OpenSim2Real/hardware_repository/README.md

# hardware_repository

This is the hardware repository for the OpenSim2Real project. It contains all of the CAD files and supporting documentation.
