OpenSim2Real/hardware_repository/docs/design/design_images/angles.PNG

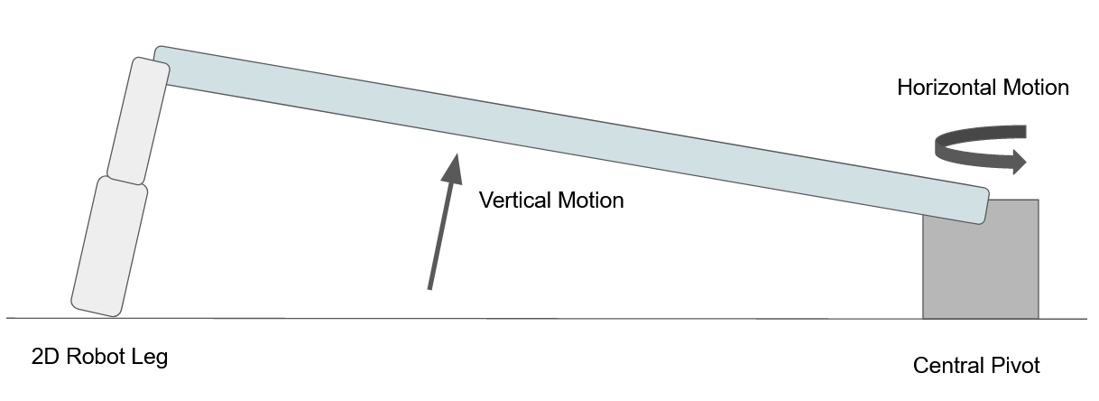
docs/design/design_images/angles.PNG
