OpenSim2Real/hardware_repository/docs/design/design_images/canelectronics.PNG

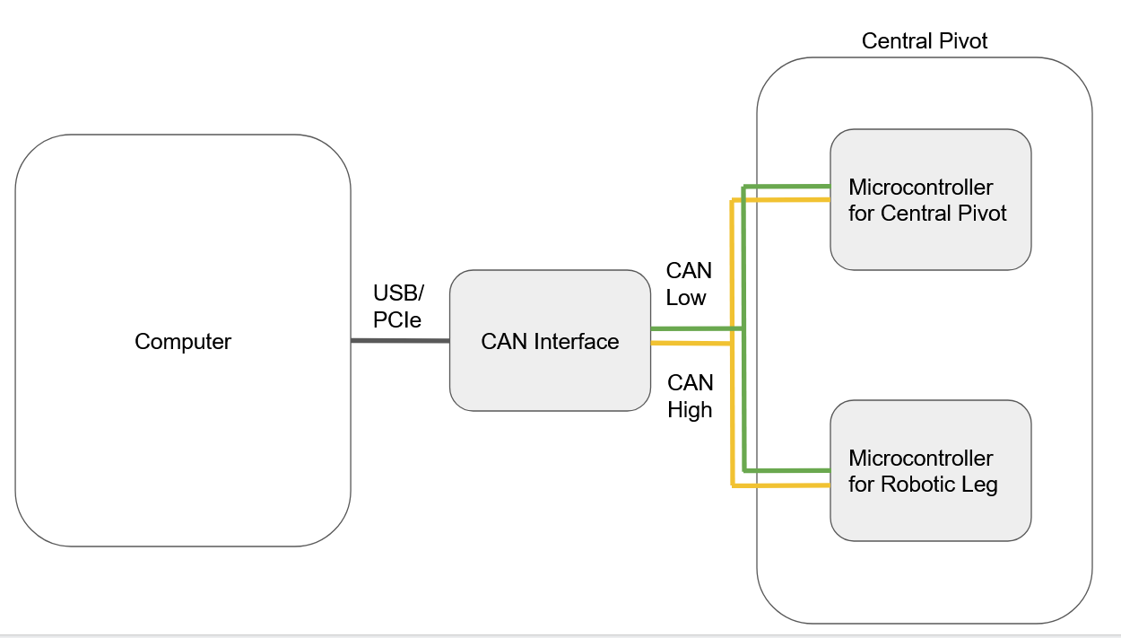
docs/design/design_images/canelectronics.PNG
