OpenSim2Real/hardware_repository/docs/design/design_images/controlelectronics.PNG

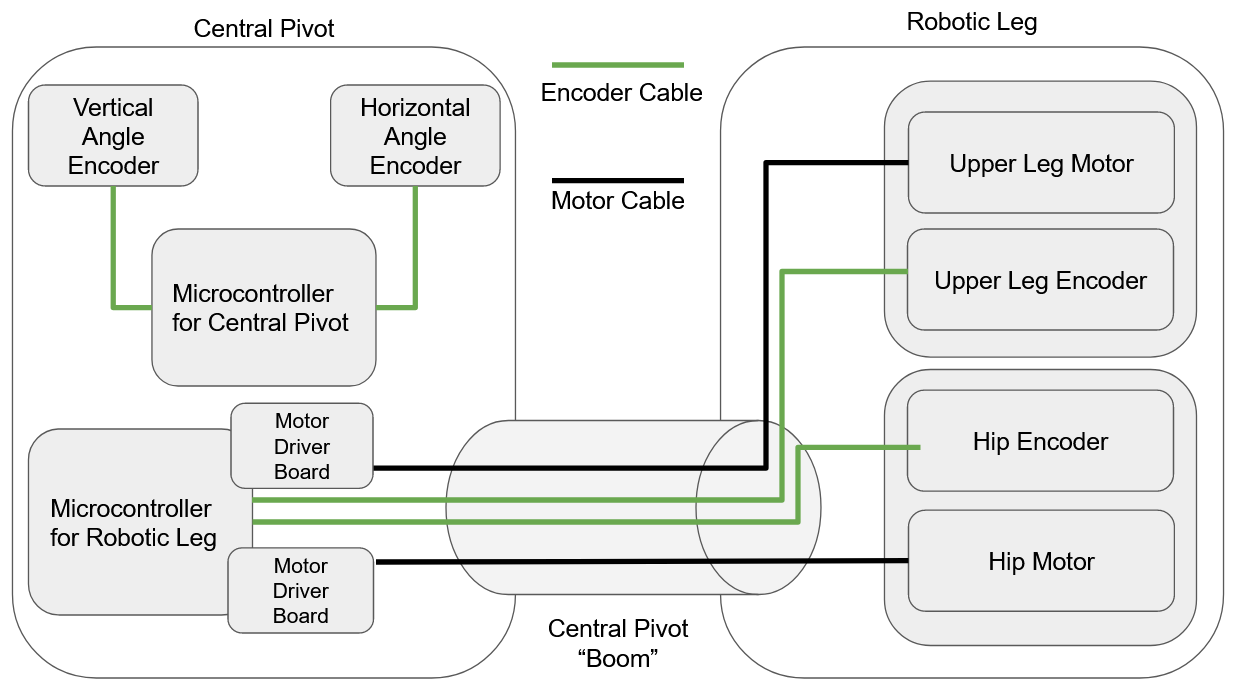
docs/design/design_images/controlelectronics.PNG
