OpenSim2Real/hardware_repository/docs/design/design_images/forces.PNG

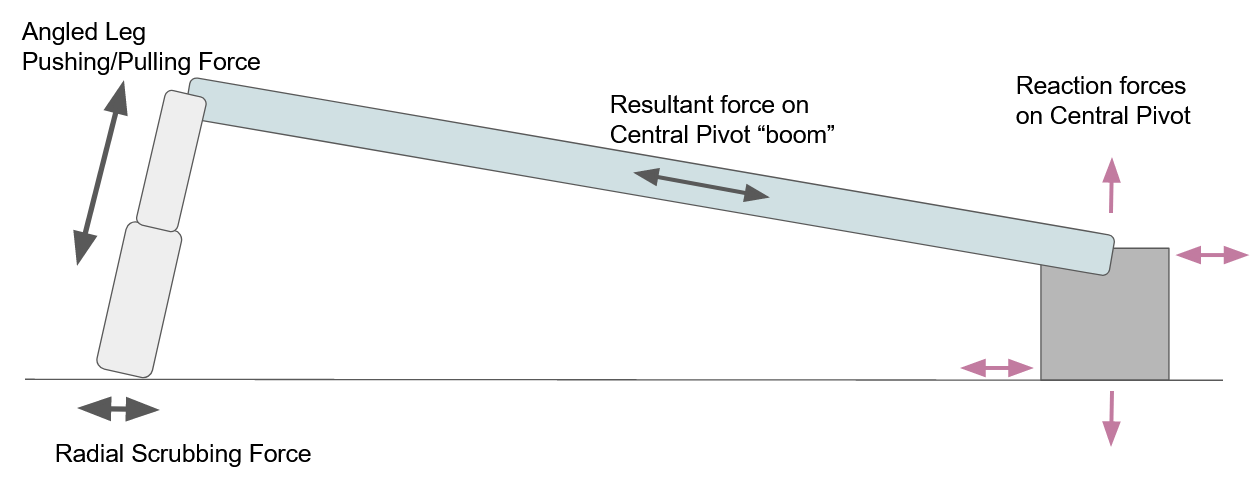
docs/design/design_images/forces.PNG
