OpenSim2Real/hardware_repository/docs/design/design_images/planarizer.PNG

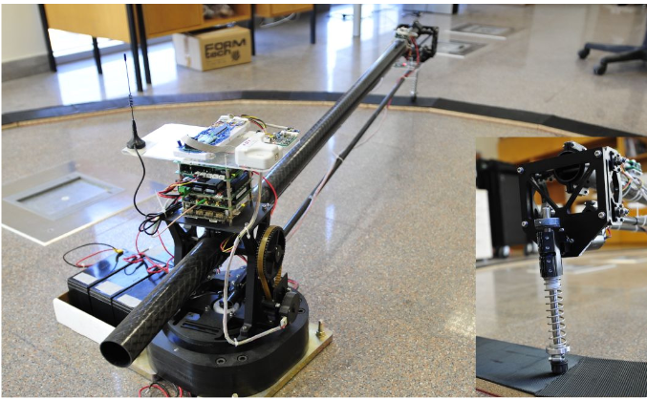
docs/design/design_images/planarizer.PNG
