OpenSim2Real/hardware_repository/docs/design/design_images/planarizer_2.PNG

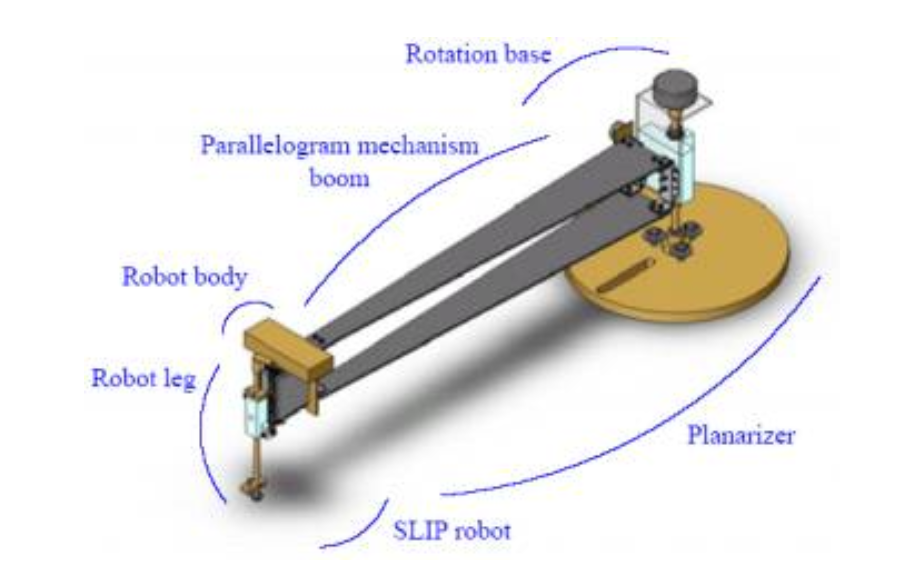
docs/design/design_images/planarizer_2.PNG
