OpenSim2Real/hardware_repository/docs/design/design_images/planarizerforces.PNG

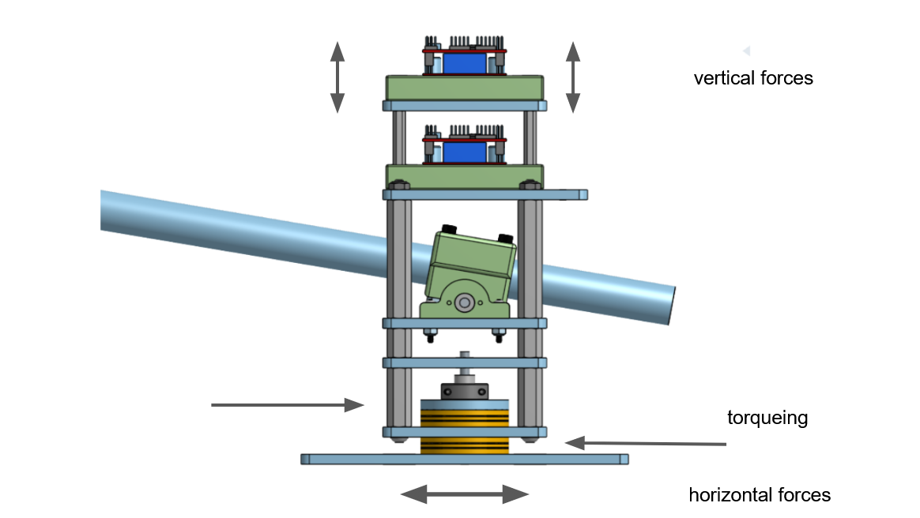
docs/design/design_images/planarizerforces.PNG
