OpenSim2Real/hardware_repository/docs/design/design_images/powerelectronics.PNG

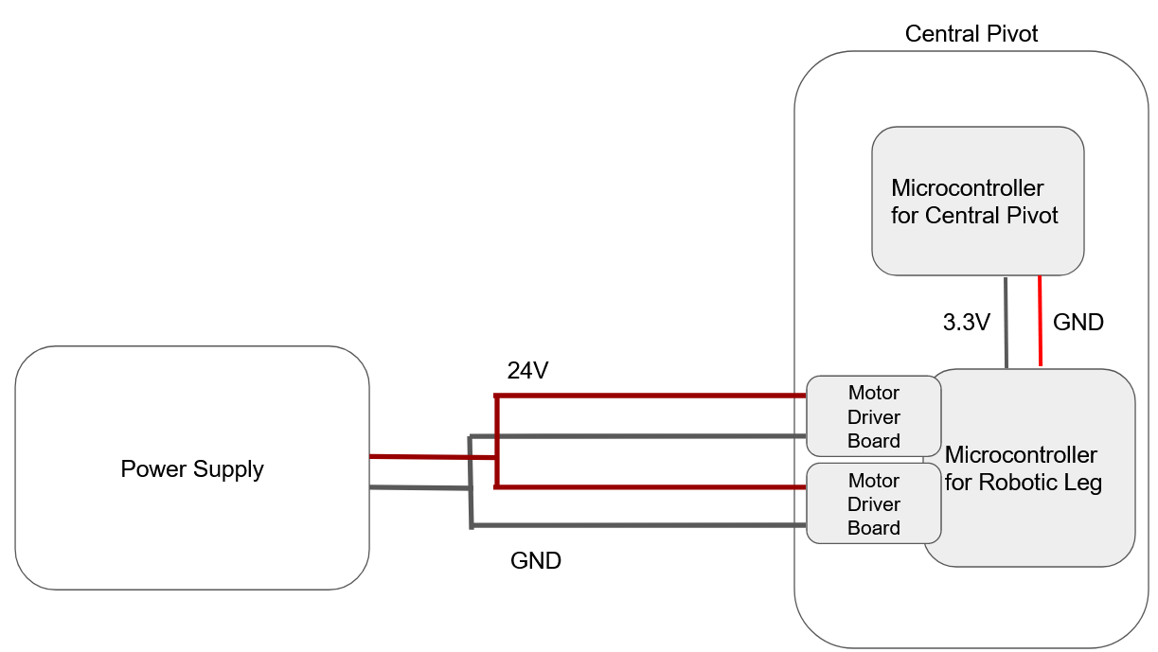
docs/design/design_images/powerelectronics.PNG
