OpenSim2Real/hardware_repository/docs/design/design_images/radialscrubbing.PNG

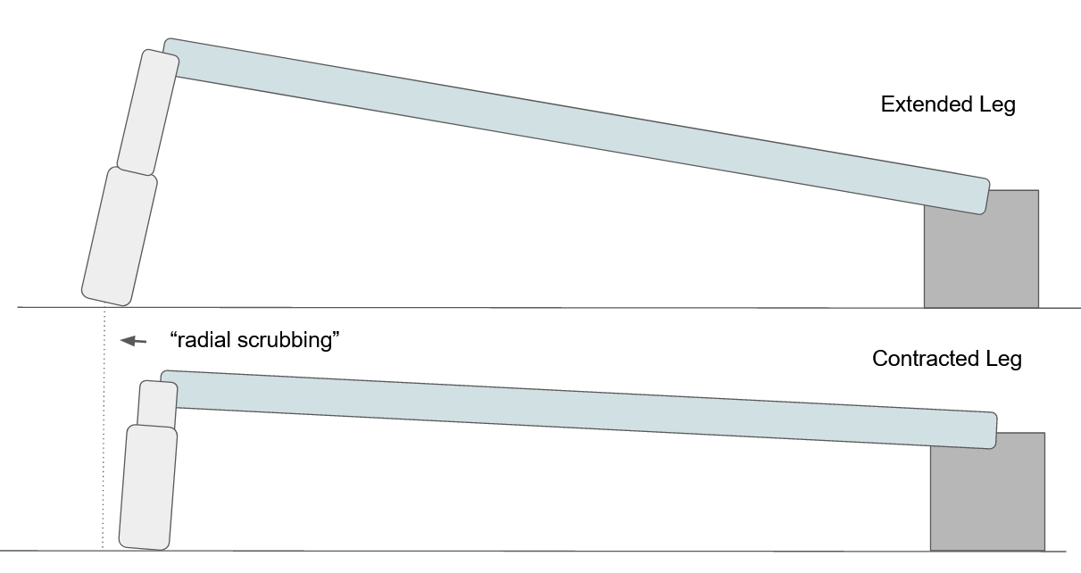
docs/design/design_images/radialscrubbing.PNG
