OpenSim2Real/hardware_repository/docs/design/design_images/roboticleg.PNG

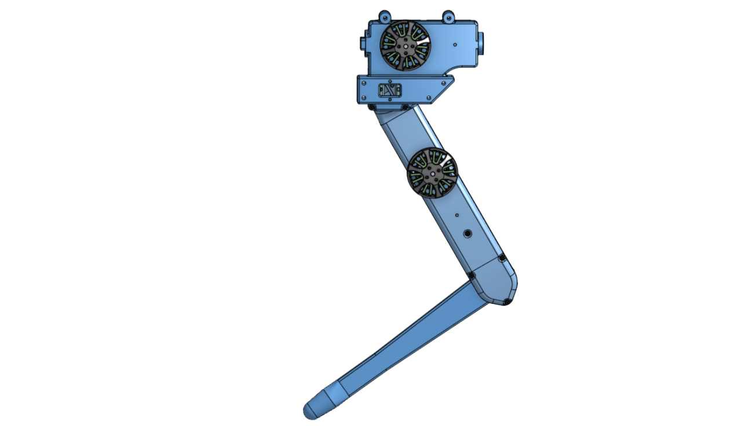
docs/design/design_images/roboticleg.PNG
