OpenSim2Real/hardware_repository/docs/design/design_images/treadmill.PNG

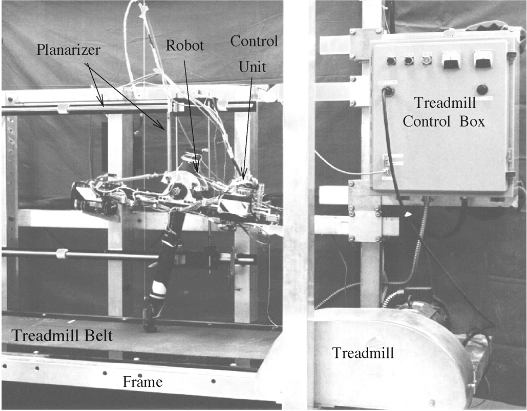
docs/design/design_images/treadmill.PNG
