OpenSim2Real/hardware_repository/docs/firmware/fm_images/import_2.PNG

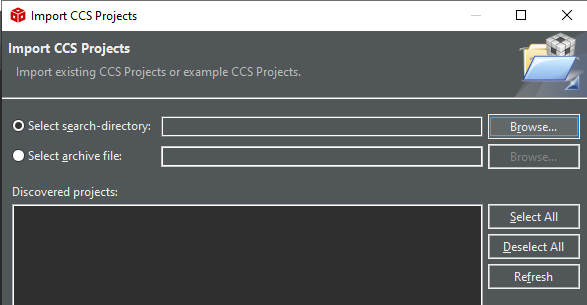
docs/firmware/fm_images/import_2.PNG
