OpenSim2Real/hardware_repository/docs/firmware/fm_images/load.PNG

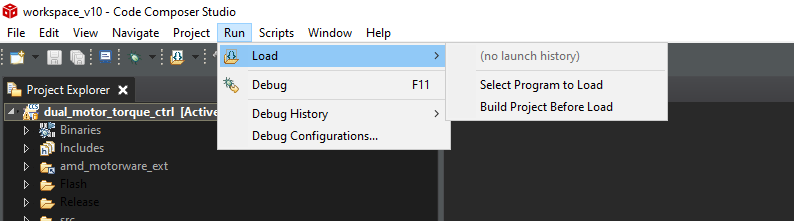
docs/firmware/fm_images/load.PNG
