OpenSim2Real/hardware_repository/docs/physical/cp_images/adapter.jpg

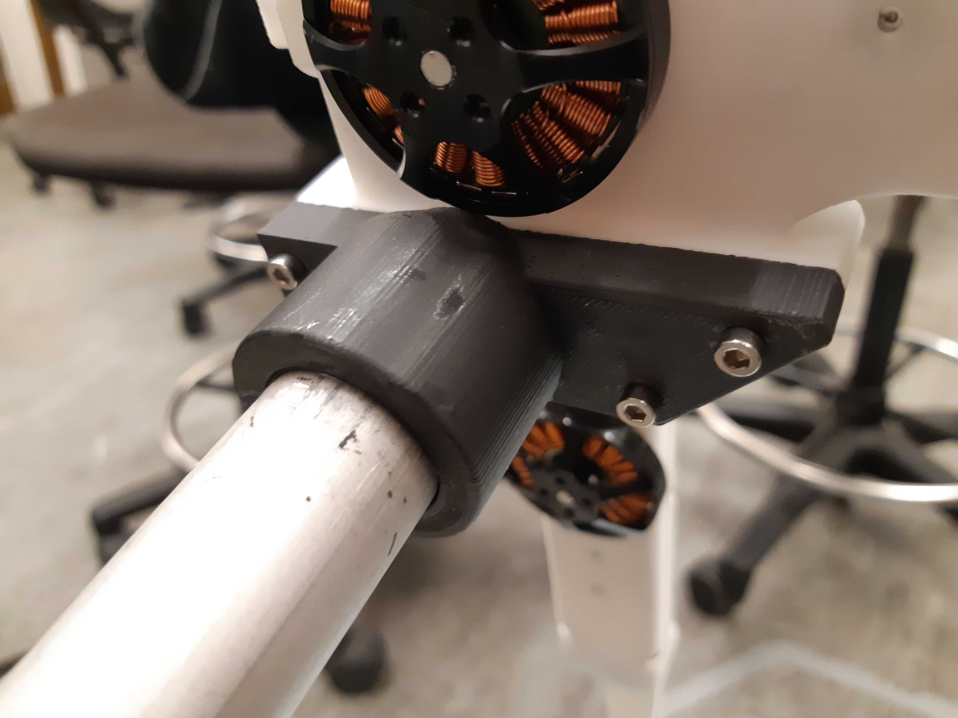
docs/physical/cp_images/adapter.jpg
