OpenSim2Real/hardware_repository/docs/physical/cp_images/adapter_1.jpg

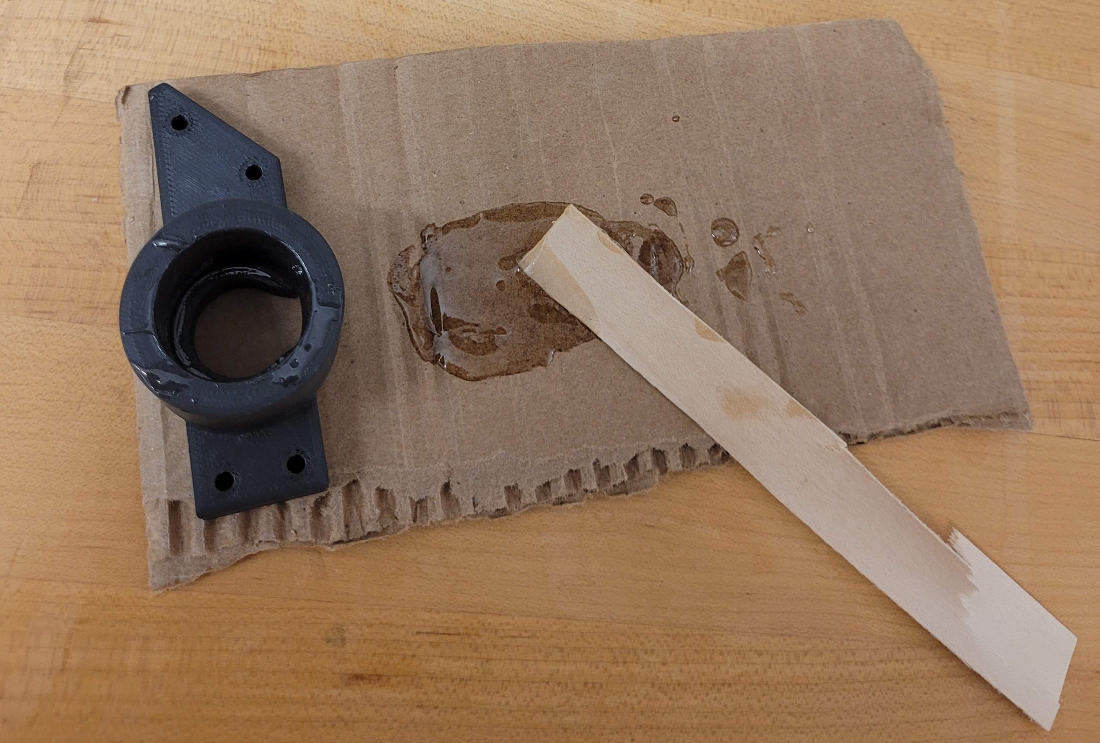
docs/physical/cp_images/adapter_1.jpg
