OpenSim2Real/hardware_repository/docs/physical/cp_images/adapter_2.jpg

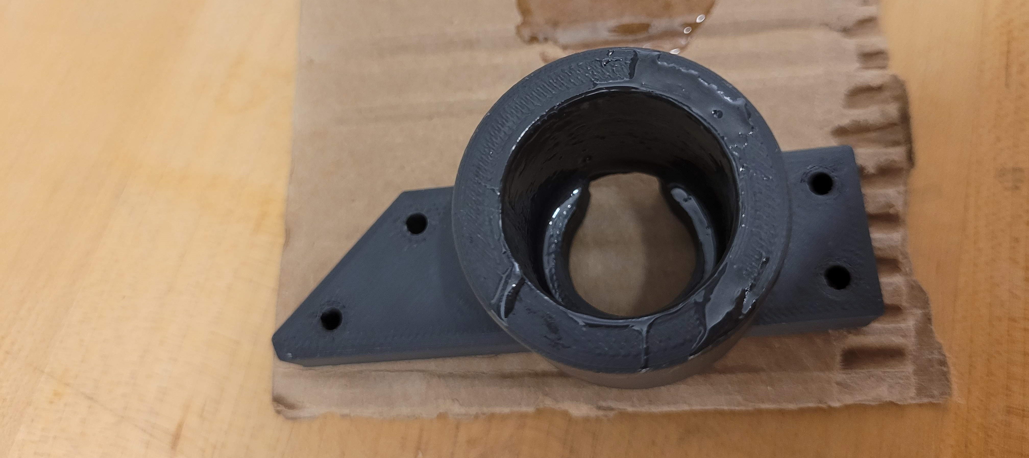
docs/physical/cp_images/adapter_2.jpg
