OpenSim2Real/hardware_repository/docs/physical/cp_images/adapter_4.jpg

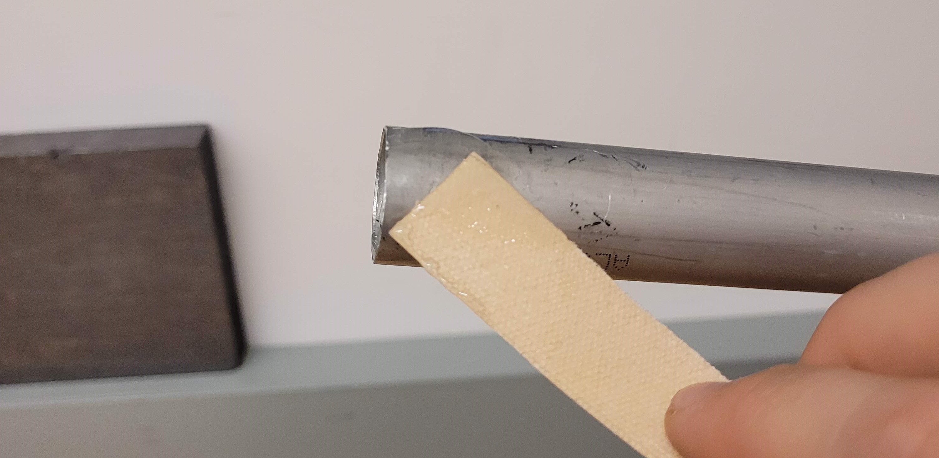
docs/physical/cp_images/adapter_4.jpg
