OpenSim2Real/hardware_repository/docs/physical/cp_images/cp_complete_3.jpg

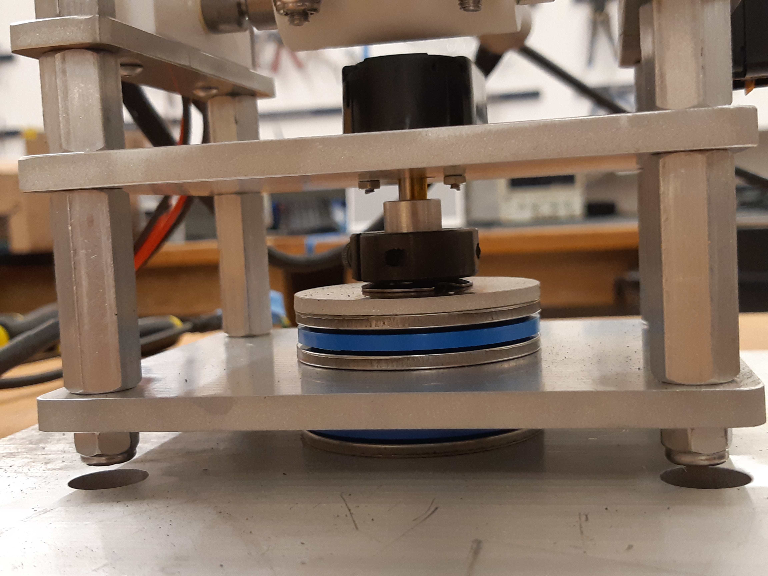
docs/physical/cp_images/cp_complete_3.jpg
