OpenSim2Real/hardware_repository/docs/physical/cp_images/cp_complete_5.jpg

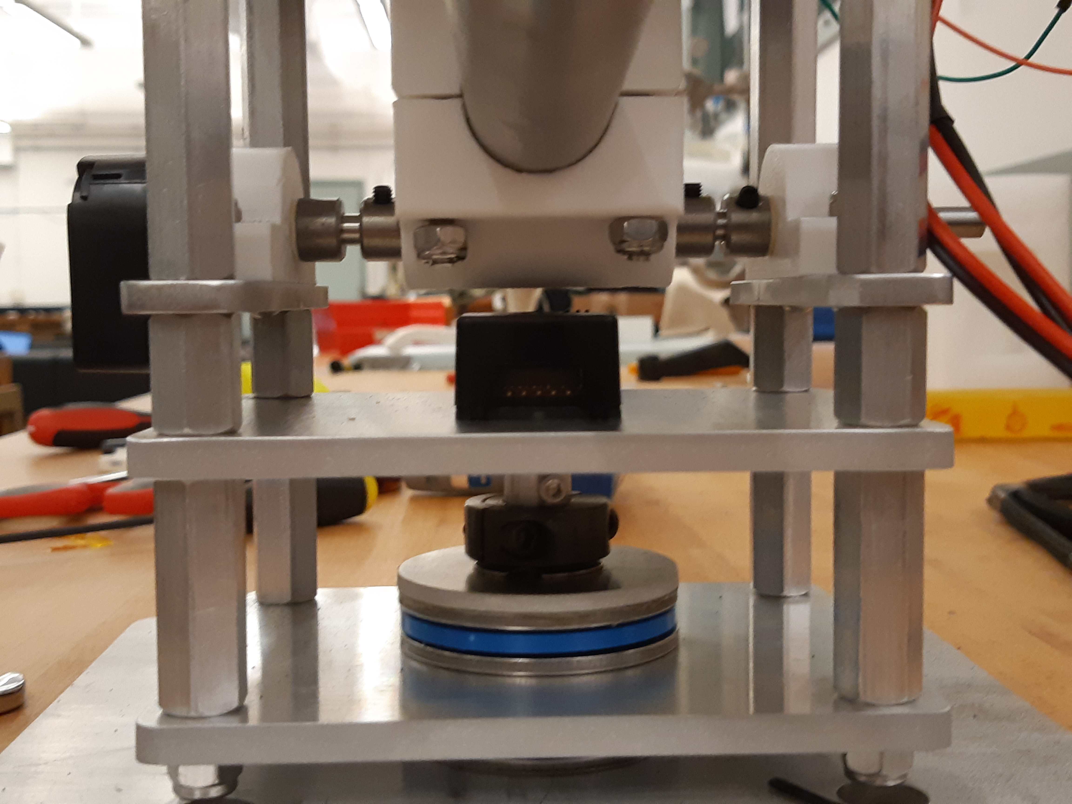
docs/physical/cp_images/cp_complete_5.jpg
