OpenSim2Real/hardware_repository/docs/physical/cp_images/cp_stage_1_2.jpg

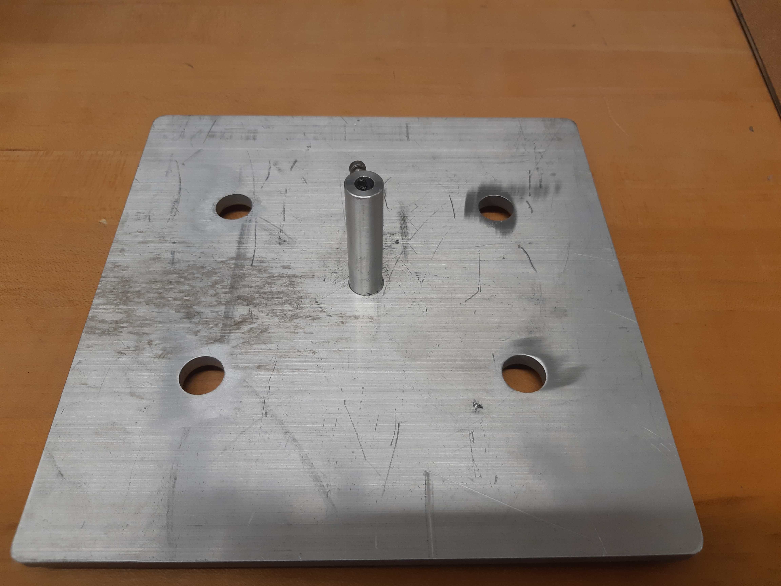
docs/physical/cp_images/cp_stage_1_2.jpg
