OpenSim2Real/hardware_repository/docs/physical/cp_images/cp_stage_9_1.jpg

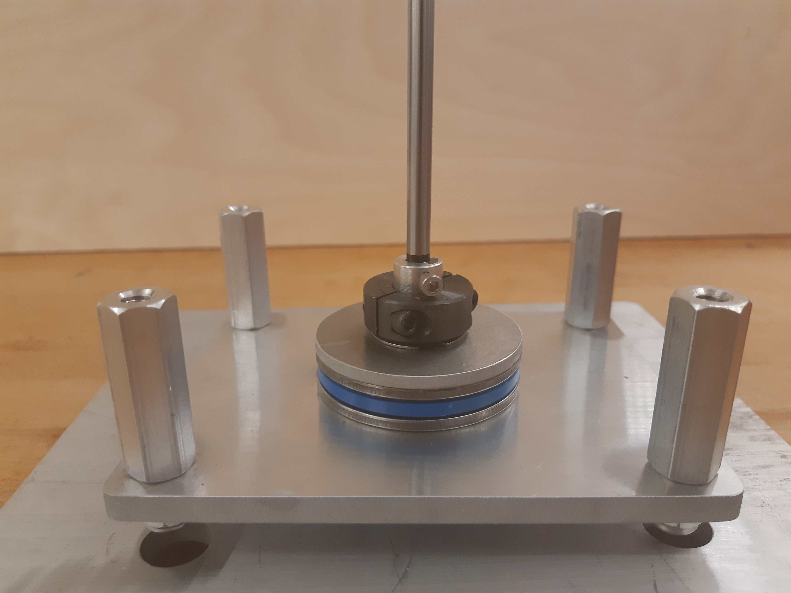
docs/physical/cp_images/cp_stage_9_1.jpg
