OpenSim2Real/hardware_repository/docs/physical/cp_images/cp_stage_14.jpg

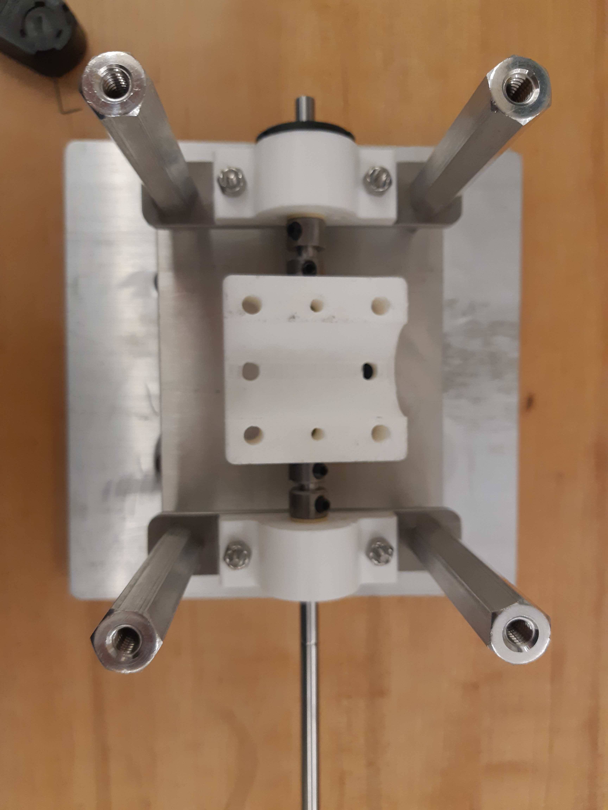
docs/physical/cp_images/cp_stage_14.jpg
