OpenSim2Real/hardware_repository/docs/physical/cp_images/encoderwire_5.jpg

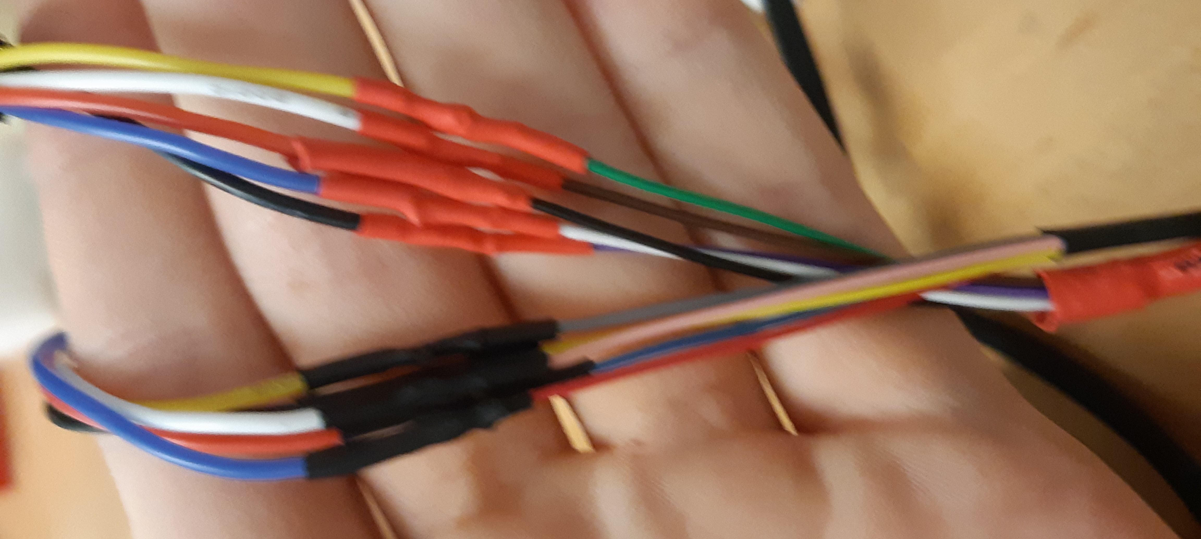
docs/physical/cp_images/encoderwire_5.jpg
