OpenSim2Real/hardware_repository/docs/physical/cp_images/shaft_holder_2.jpg

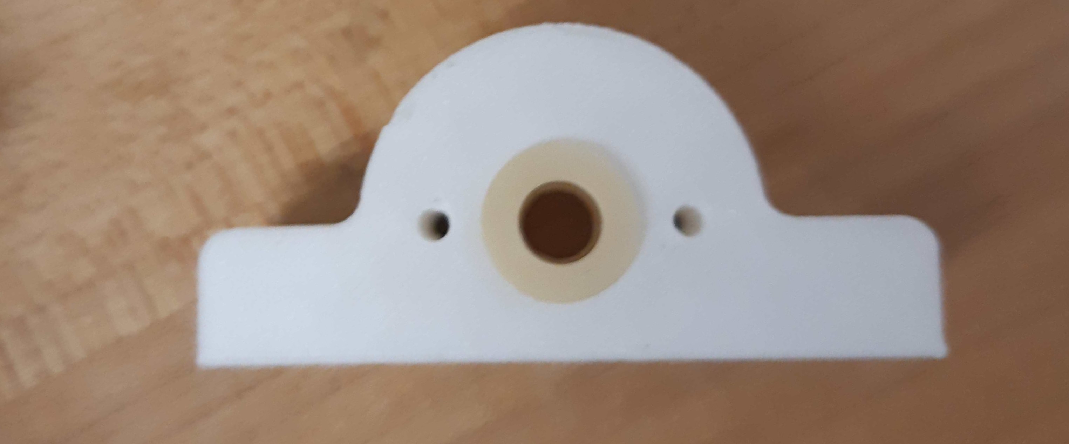
docs/physical/cp_images/shaft_holder_2.jpg
