OpenSim2Real/hardware_repository/docs/physical/cp_images/shaft_holder_5.jpg

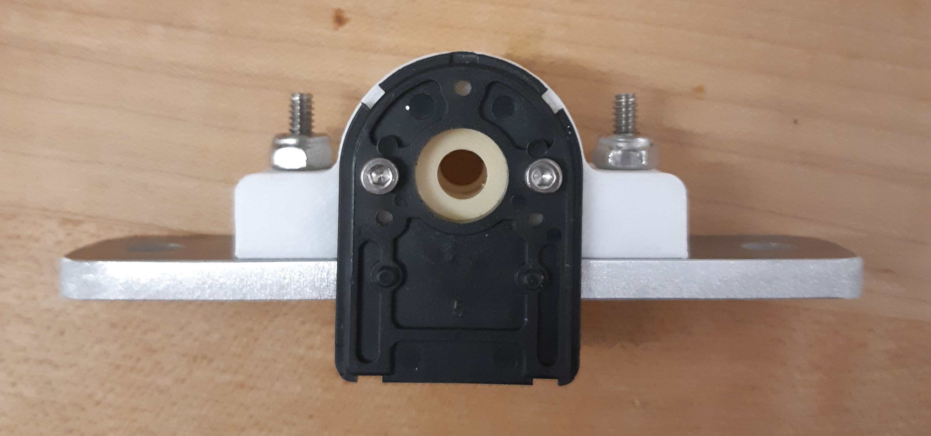
docs/physical/cp_images/shaft_holder_5.jpg
