OpenSim2Real/hardware_repository/docs/physical/in_images/3phase_5.jpg

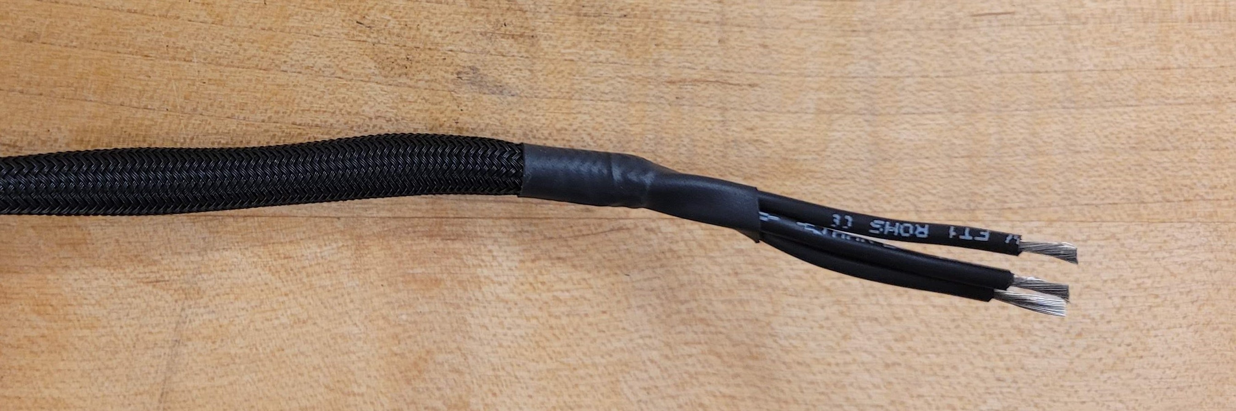
docs/physical/in_images/3phase_5.jpg
