OpenSim2Real/hardware_repository/docs/physical/in_images/3phase_8.jpg

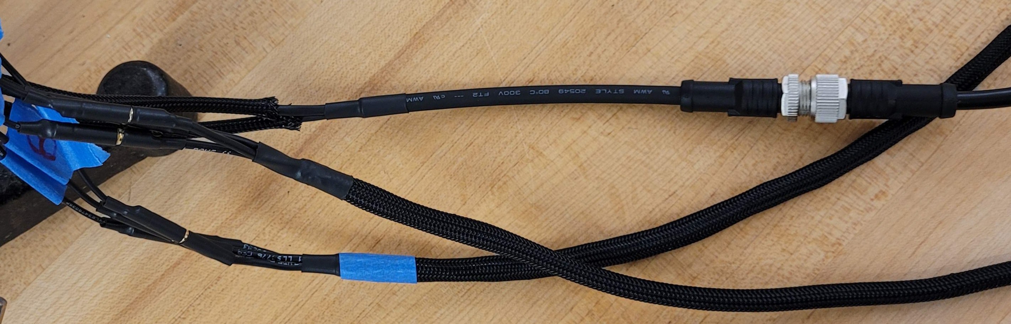
docs/physical/in_images/3phase_8.jpg
