OpenSim2Real/hardware_repository/docs/physical/in_images/3phase_9.jpg

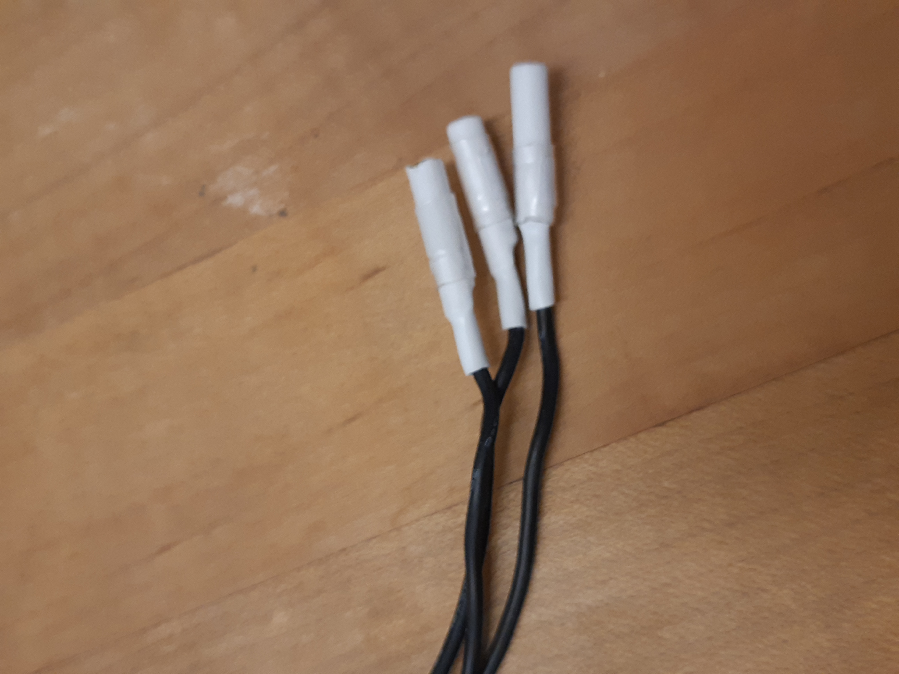
docs/physical/in_images/3phase_9.jpg
