OpenSim2Real/hardware_repository/docs/physical/in_images/can1.jpg

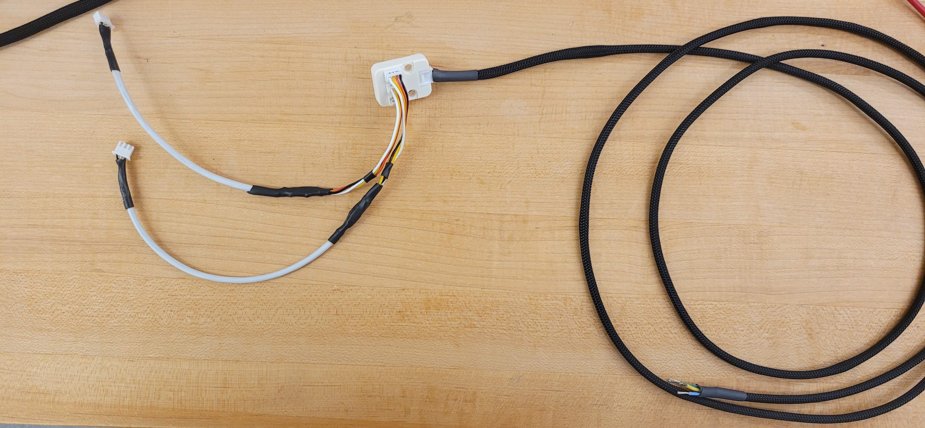
docs/physical/in_images/can1.jpg
