OpenSim2Real/hardware_repository/docs/physical/in_images/can2.jpg

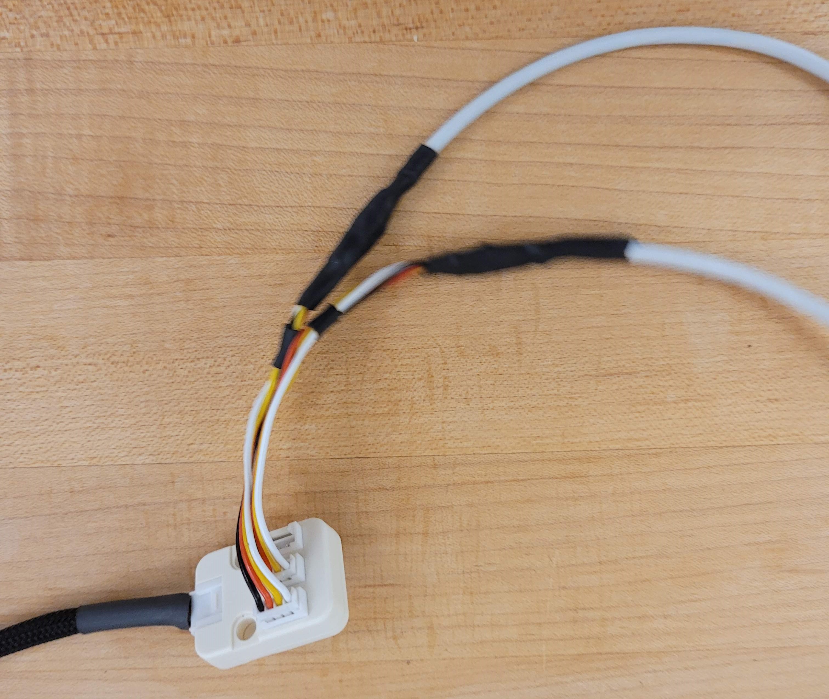
docs/physical/in_images/can2.jpg
