OpenSim2Real/hardware_repository/docs/physical/in_images/can3.jpg

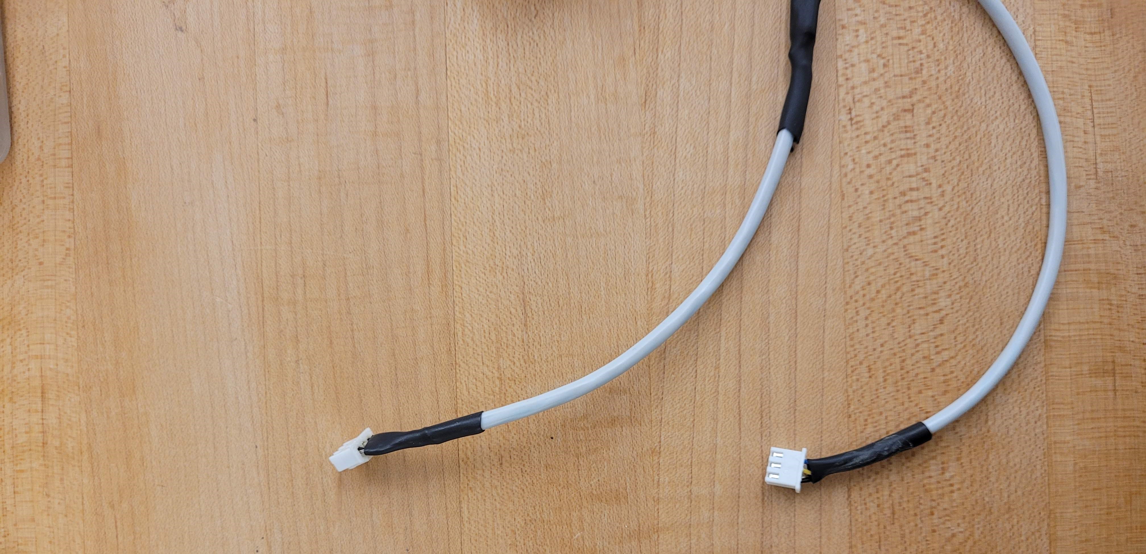
docs/physical/in_images/can3.jpg
