OpenSim2Real/hardware_repository/docs/physical/in_images/conn1.jpg

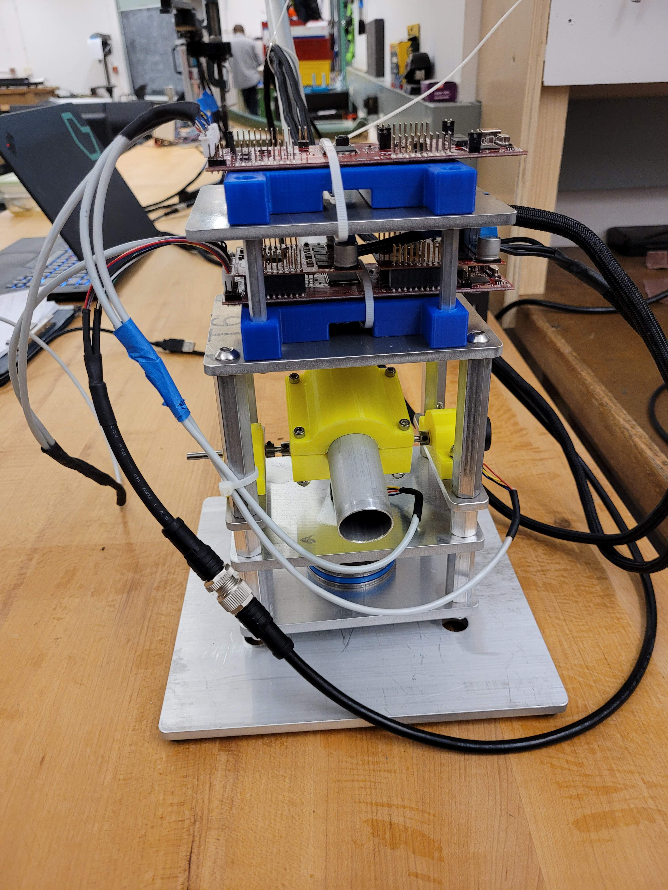
docs/physical/in_images/conn1.jpg
