OpenSim2Real/hardware_repository/docs/physical/in_images/conn2.jpg

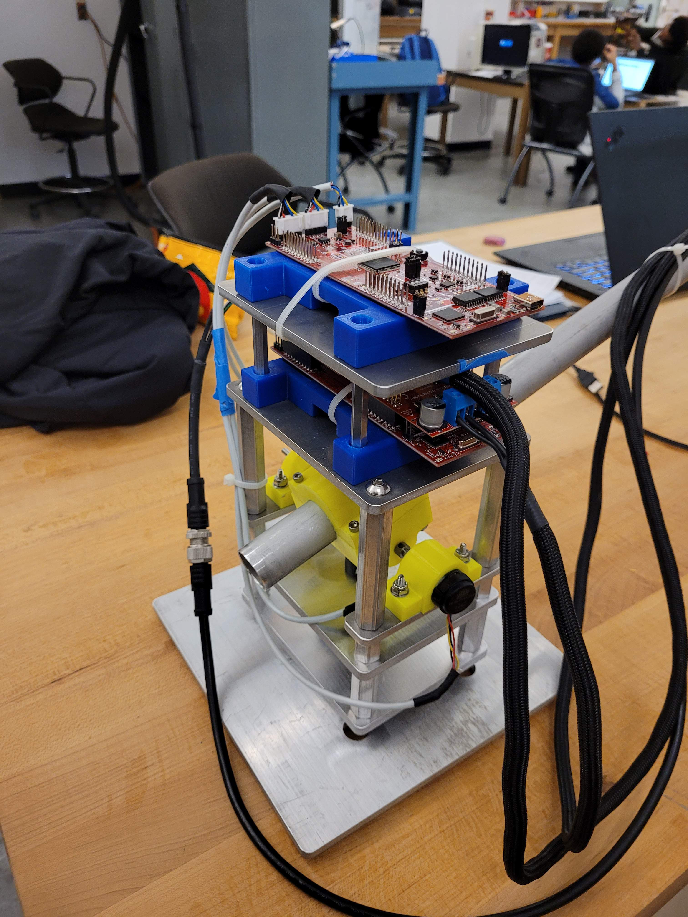
docs/physical/in_images/conn2.jpg
