OpenSim2Real/hardware_repository/docs/physical/in_images/conn3.jpg

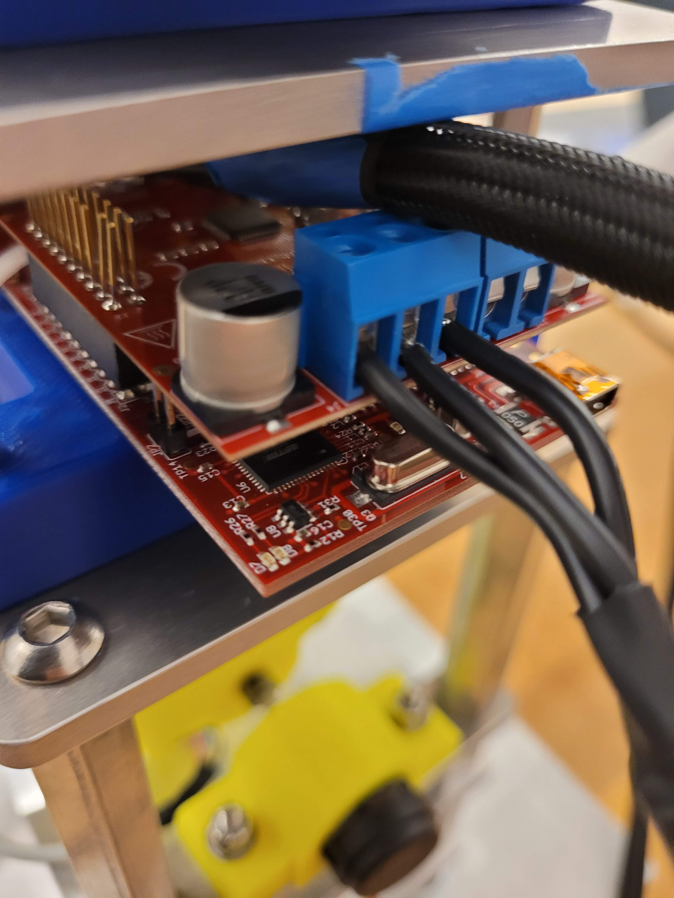
docs/physical/in_images/conn3.jpg
