OpenSim2Real/hardware_repository/docs/physical/in_images/conn4.jpg

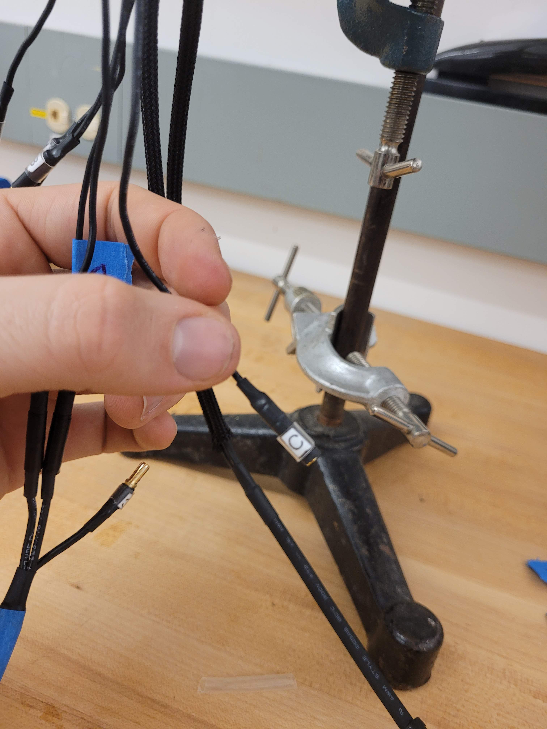
docs/physical/in_images/conn4.jpg
