OpenSim2Real/hardware_repository/docs/physical/in_images/conn5.jpg

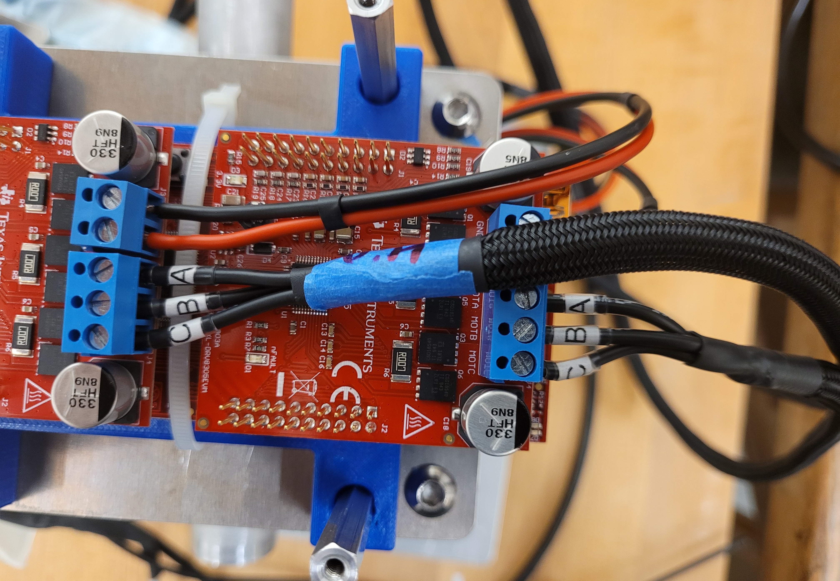
docs/physical/in_images/conn5.jpg
