OpenSim2Real/hardware_repository/docs/physical/in_images/damage_1.jpg

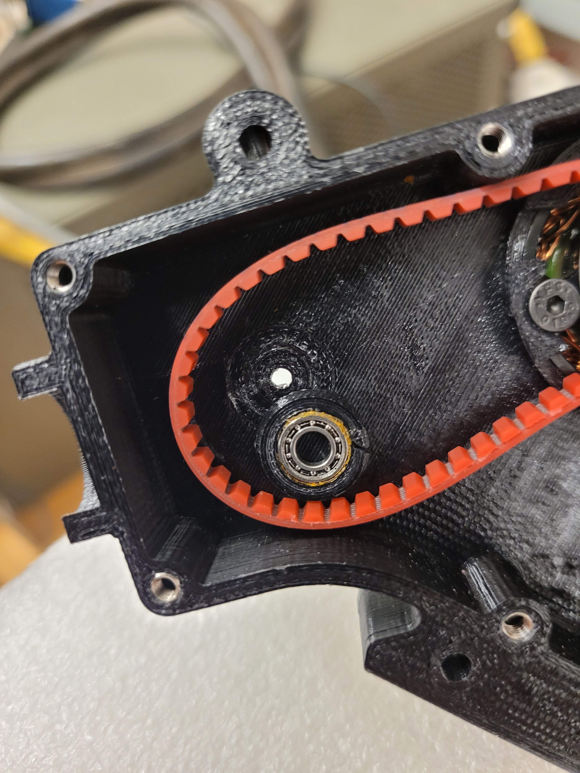
docs/physical/in_images/damage_1.jpg
