OpenSim2Real/hardware_repository/docs/physical/in_images/damage_2.jpg

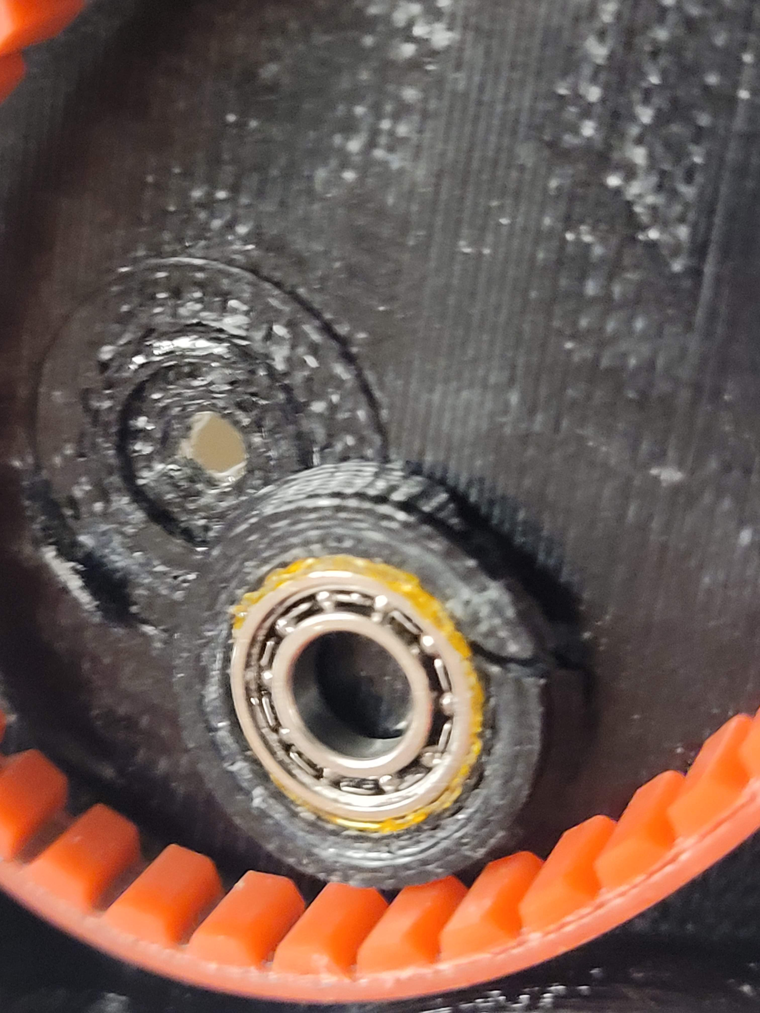
docs/physical/in_images/damage_2.jpg
