OpenSim2Real/hardware_repository/docs/physical/in_images/damage_3.jpg

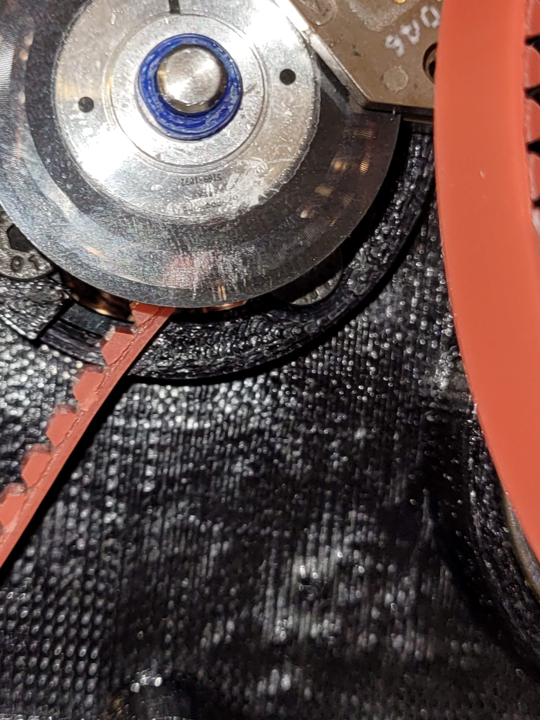
docs/physical/in_images/damage_3.jpg
