OpenSim2Real/hardware_repository/docs/physical/in_images/encoderwire_2.jpg

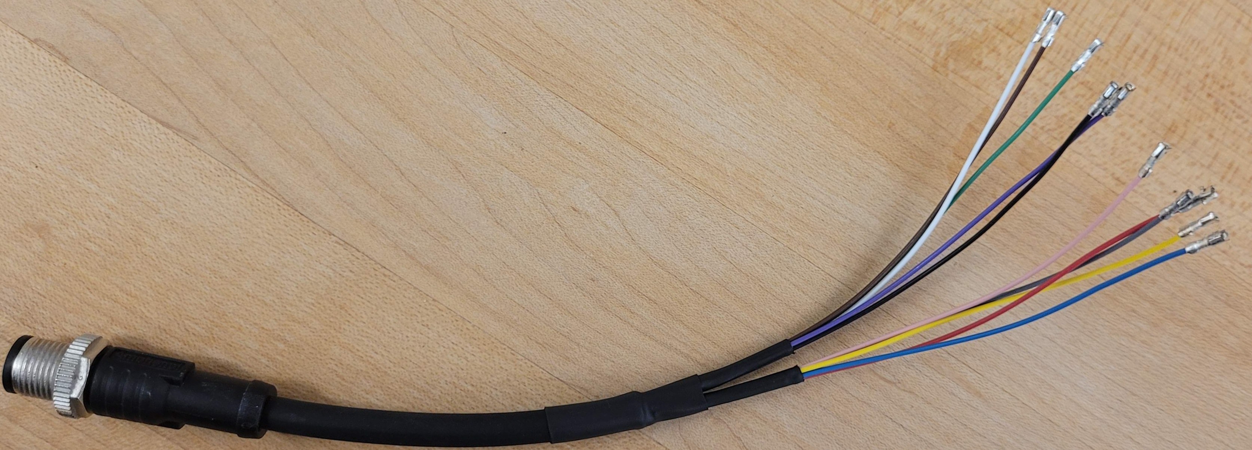
docs/physical/in_images/encoderwire_2.jpg
