OpenSim2Real/hardware_repository/docs/physical/in_images/encoderwire_5.jpg

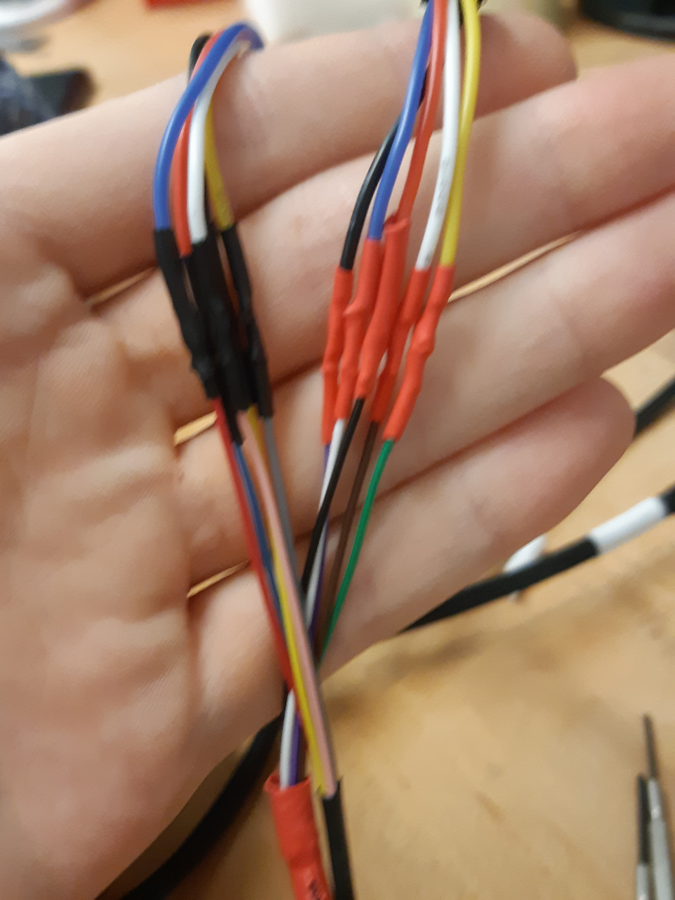
docs/physical/in_images/encoderwire_5.jpg
