OpenSim2Real/hardware_repository/docs/physical/in_images/full_leg.jpg

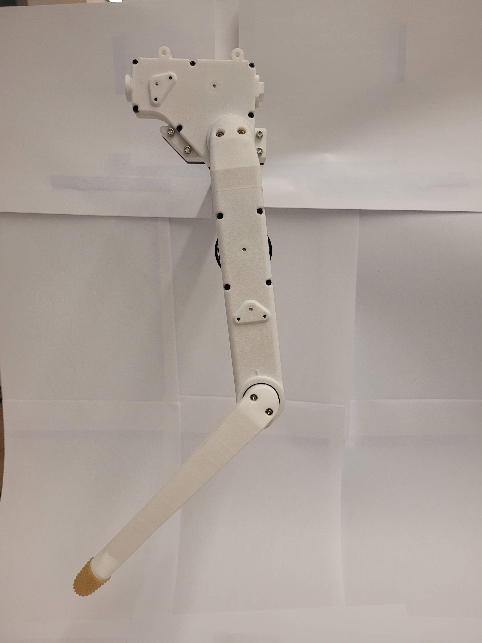
docs/physical/in_images/full_leg.jpg
