OpenSim2Real/hardware_repository/docs/physical/in_images/mm.jpg

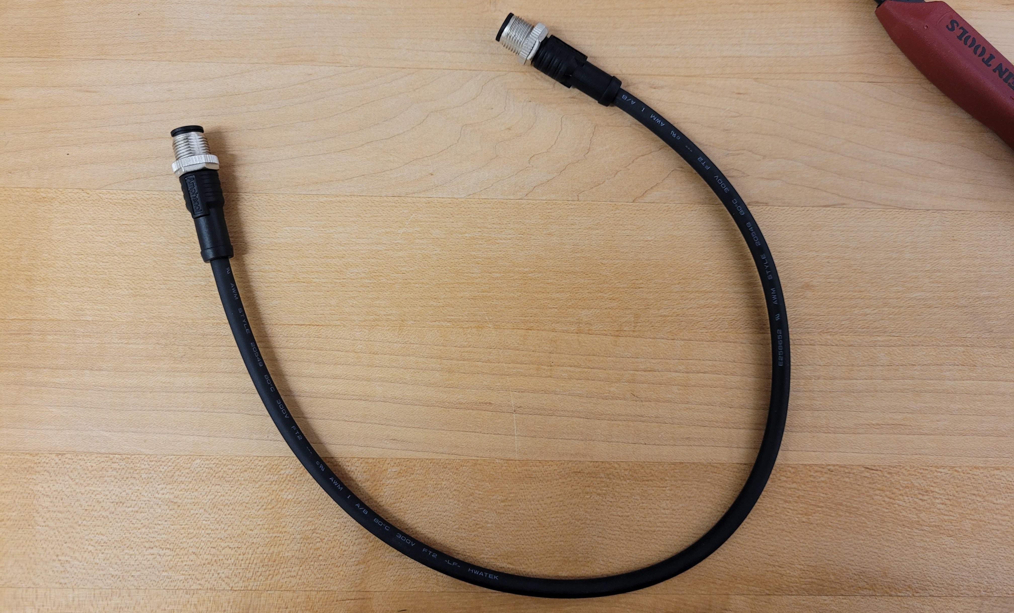
docs/physical/in_images/mm.jpg
