OpenSim2Real/hardware_repository/docs/physical/in_images/mm_cut.jpg

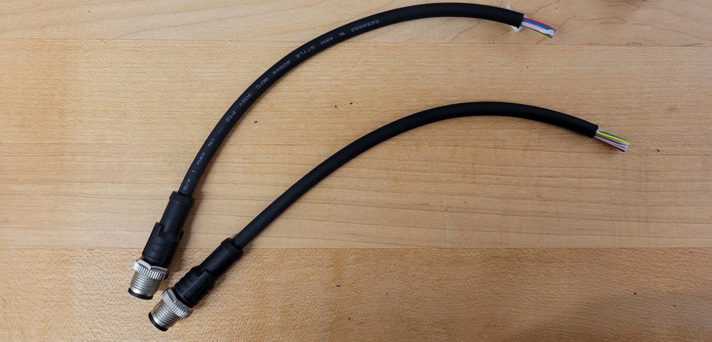
docs/physical/in_images/mm_cut.jpg
