OpenSim2Real/hardware_repository/docs/physical/in_images/power_2.jpg

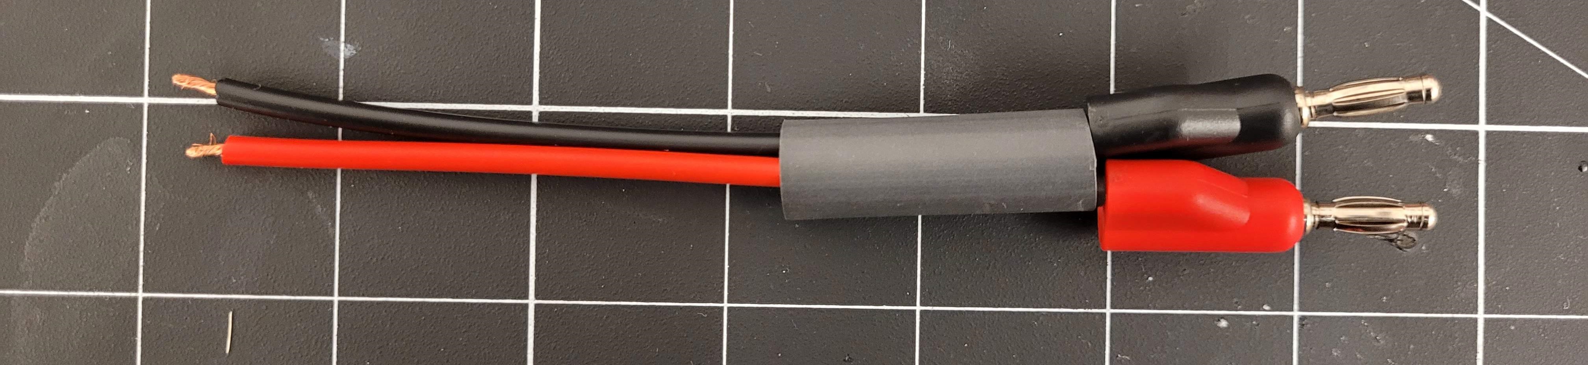
docs/physical/in_images/power_2.jpg
