OpenSim2Real/hardware_repository/docs/physical/in_images/power_3.jpg

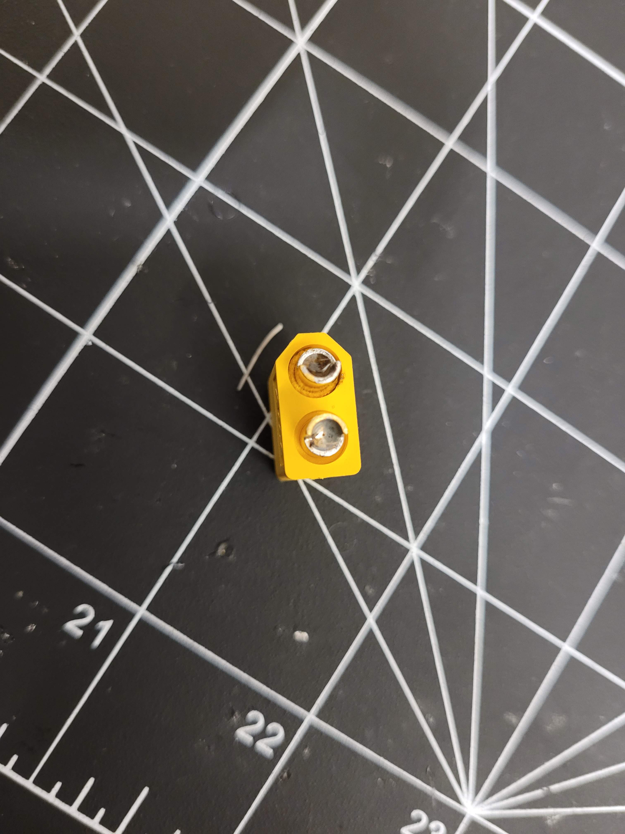
docs/physical/in_images/power_3.jpg
