OpenSim2Real/hardware_repository/docs/physical/in_images/power_7.jpg

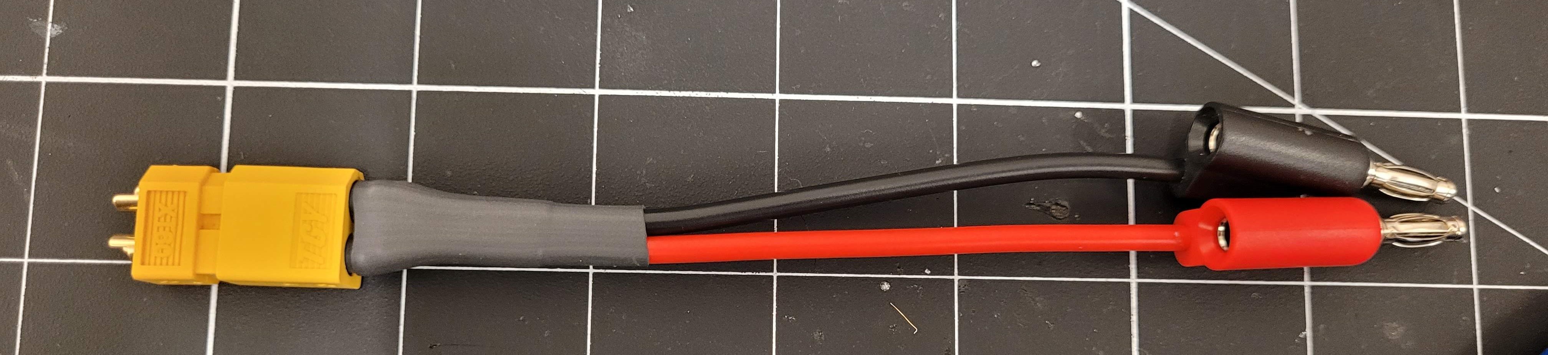
docs/physical/in_images/power_7.jpg
