OpenSim2Real/hardware_repository/docs/physical/in_images/power_8.jpg

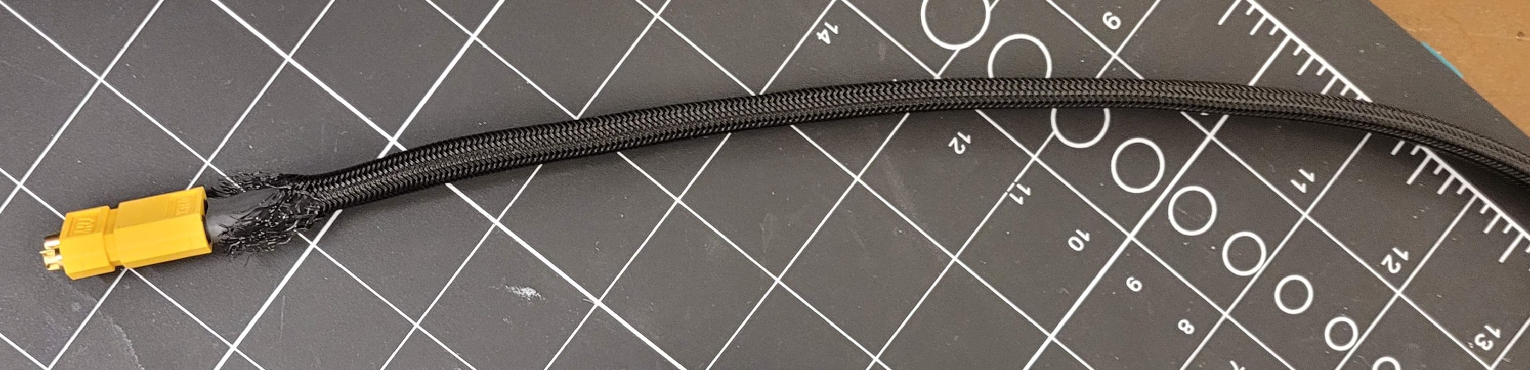
docs/physical/in_images/power_8.jpg
