OpenSim2Real/hardware_repository/docs/physical/leg_images/can_interface_1.PNG

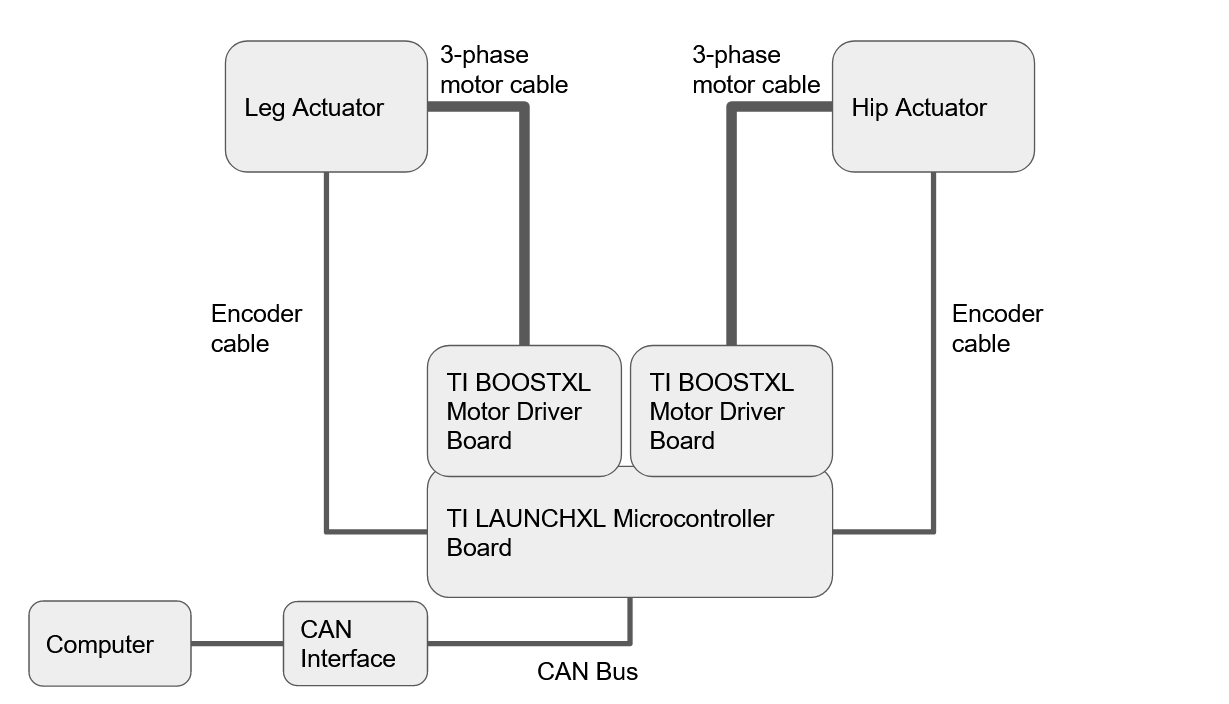
docs/physical/leg_images/can_interface_1.PNG
