OpenSim2Real/hardware_repository/docs/physical/leg_images/encoder_care_1.jpg

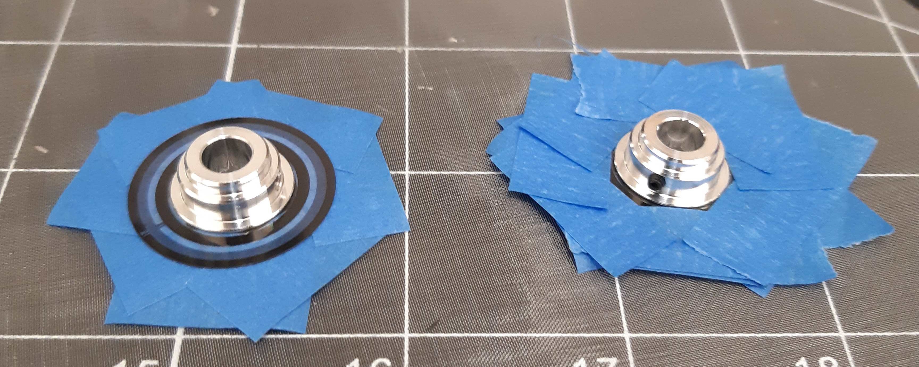
docs/physical/leg_images/encoder_care_1.jpg
