OpenSim2Real/hardware_repository/docs/physical/leg_images/frictioner.jpg

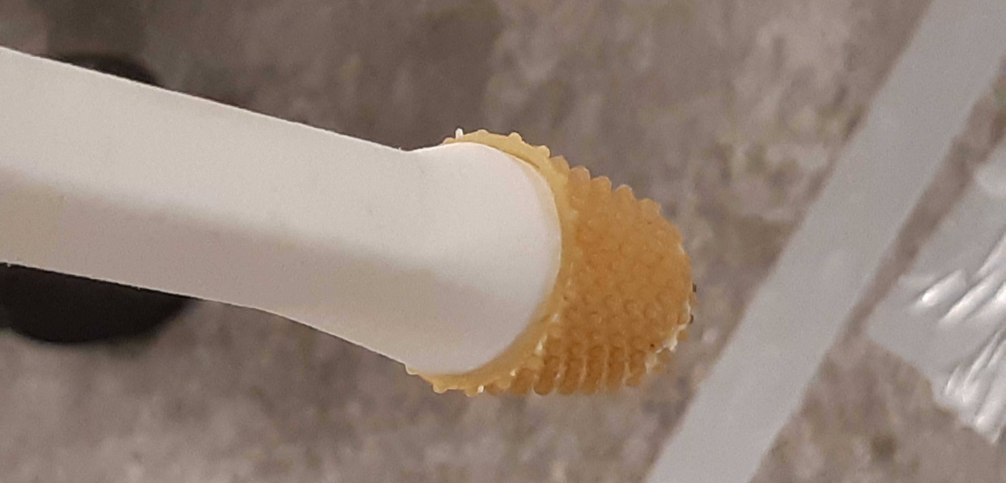
docs/physical/leg_images/frictioner.jpg
