OpenSim2Real/hardware_repository/docs/physical/leg_images/motor_spacing.jpg

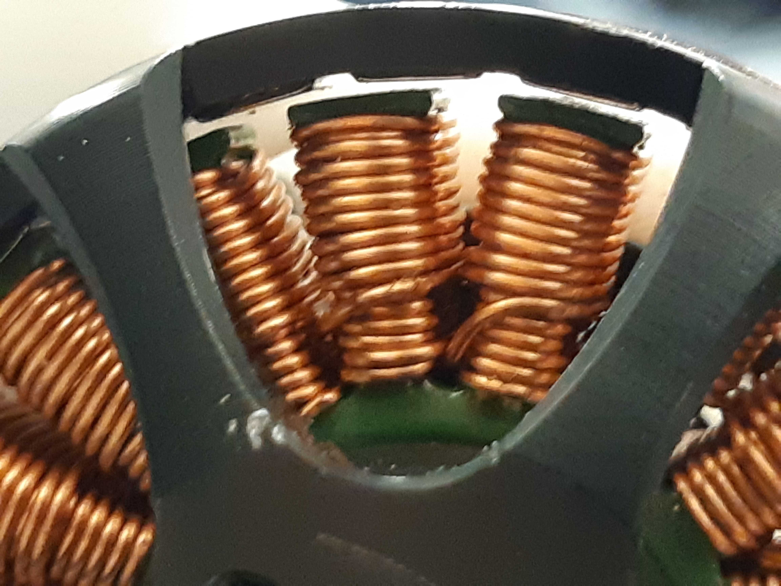
docs/physical/leg_images/motor_spacing.jpg
