OpenSim2Real/hardware_repository/docs/physical/leg_images/outputpulley_2.jpg

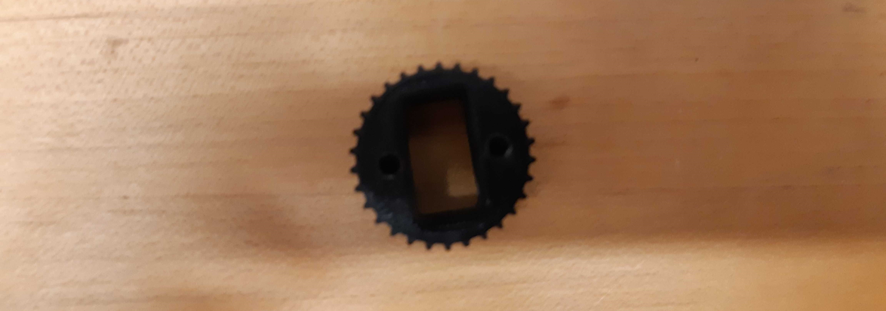
docs/physical/leg_images/outputpulley_2.jpg
