OpenSim2Real/hardware_repository/docs/physical/leg_images/roller_1.jpg

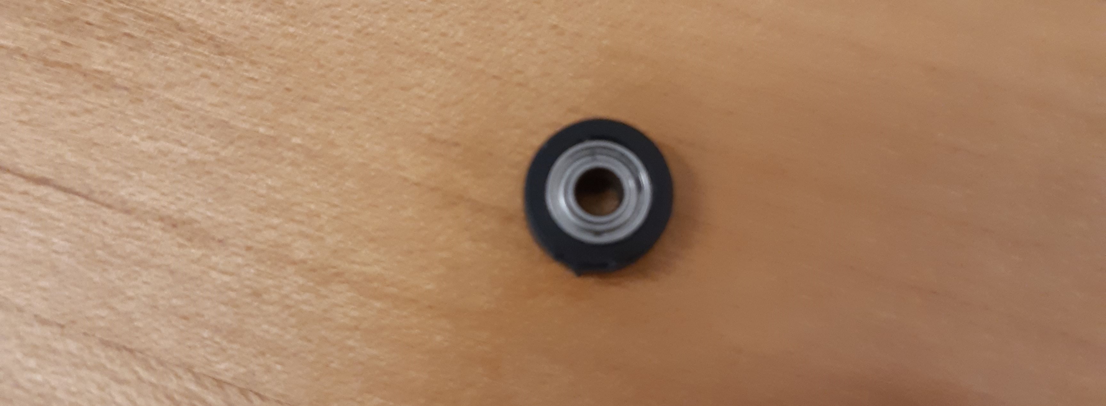
docs/physical/leg_images/roller_1.jpg
