OpenSim2Real/hardware_repository/docs/physical/leg_images/roller_3.jpg

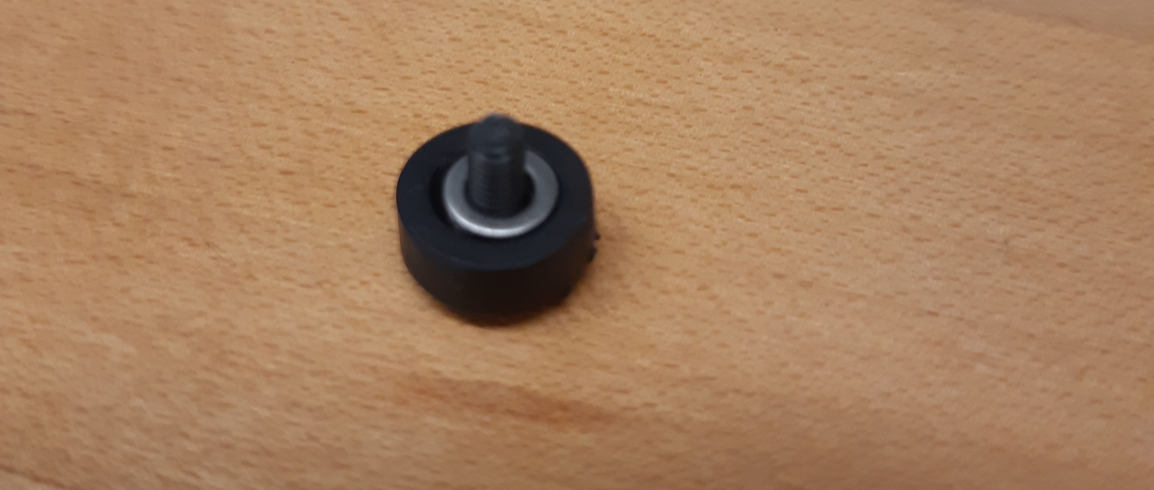
docs/physical/leg_images/roller_3.jpg
