OpenSim2Real/hardware_repository/docs/physical/tools_images/blackwire.jpg

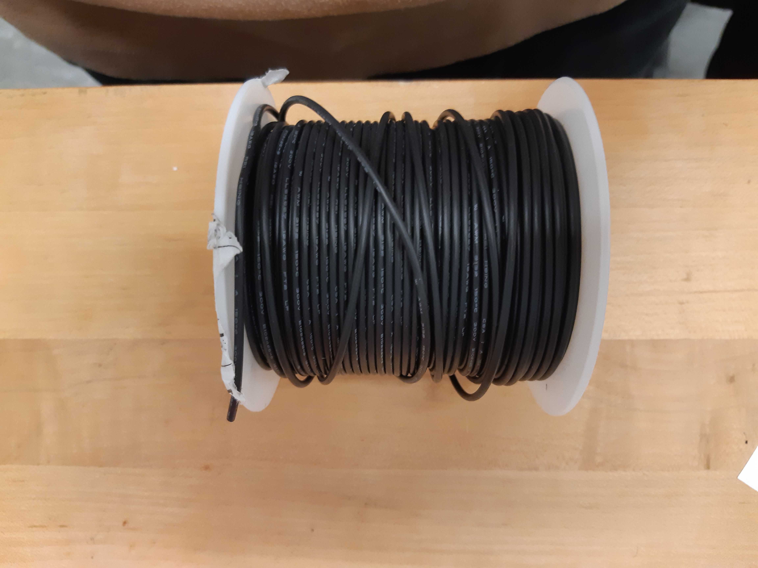
docs/physical/tools_images/blackwire.jpg
