OpenSim2Real/hardware_repository/docs/physical/tools_images/jumper.jpg

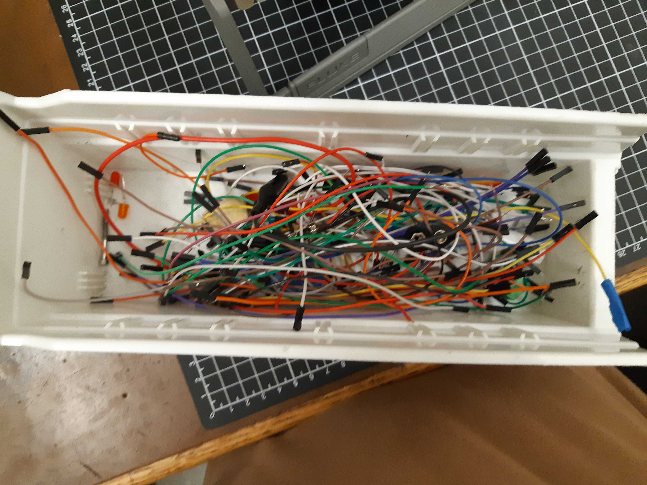
docs/physical/tools_images/jumper.jpg
