OpenSim2Real/hardware_repository/docs/physical/tools_images/sheath.jpg

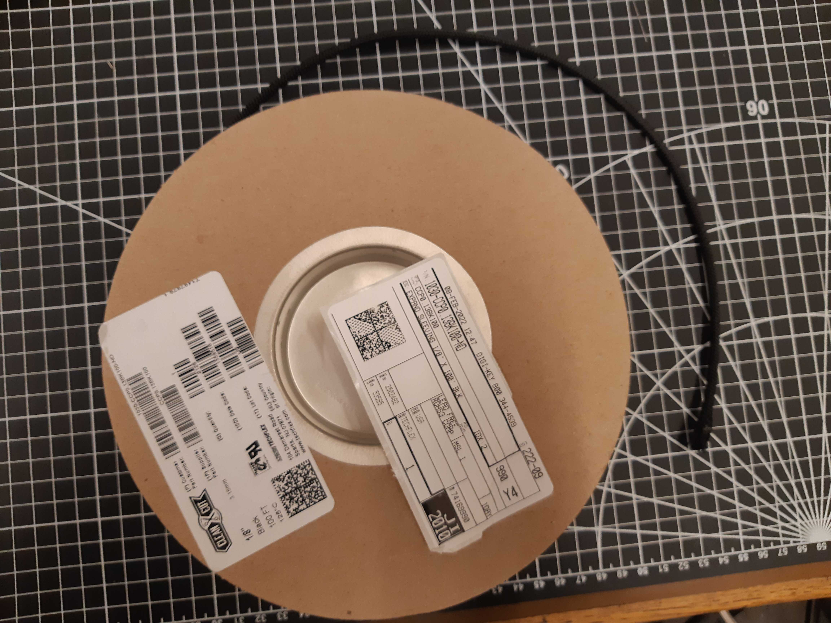
docs/physical/tools_images/sheath.jpg
