OpenSim2Real/hardware_repository/docs/physical/tools_images/wrench_2.jpg

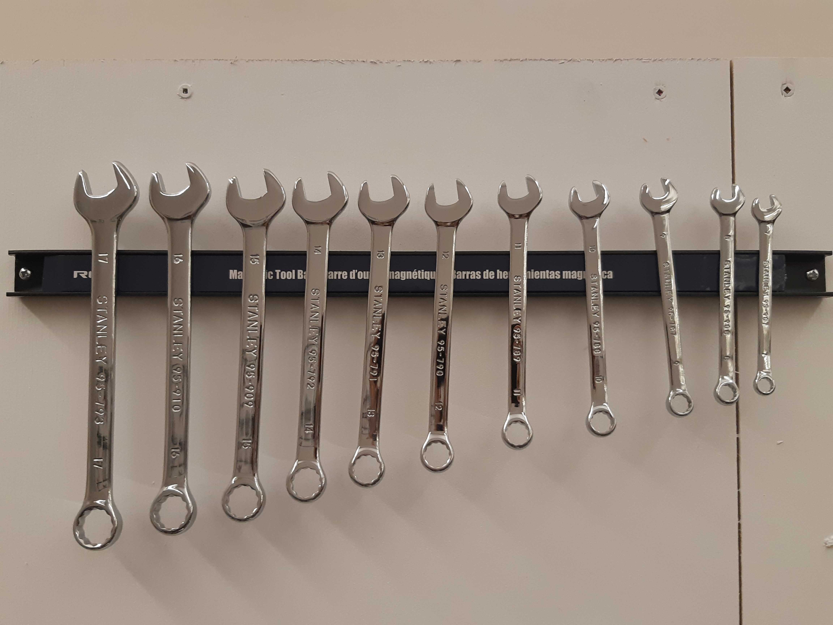
docs/physical/tools_images/wrench_2.jpg
