OpenSim2Real/hardware_repository/docs/physical/tools_images/wrench_3.jpg

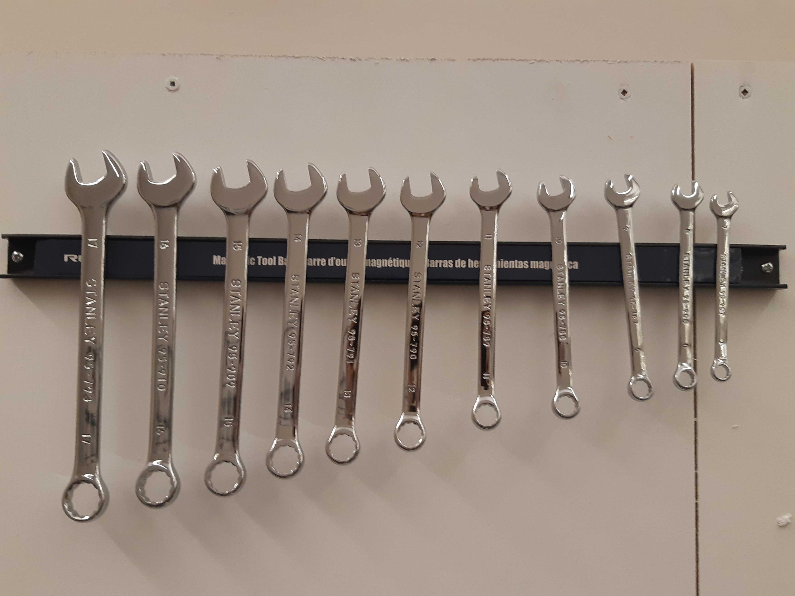
docs/physical/tools_images/wrench_3.jpg
