OpenSim2Real/hardware_repository/cad/misc/pulley-assembly-tool.STL

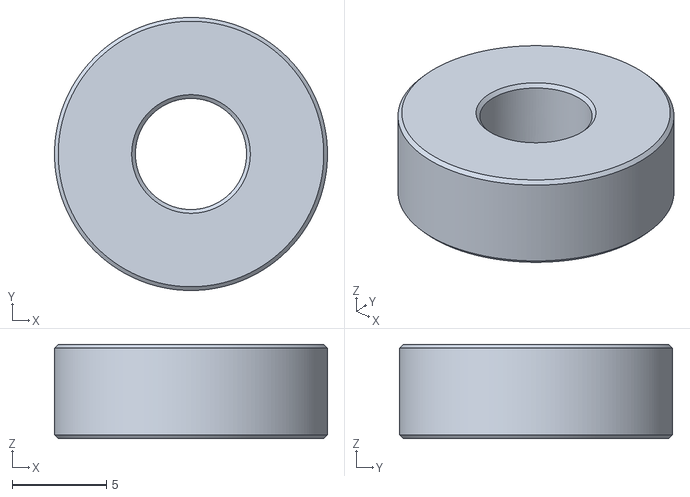
[picture p105: CAD file, 2022-04-04]
cad/misc/pulley-assembly-tool.STL
14.5 x 14.5 x 5.00
