OpenSim2Real/hardware_repository/cad/central-pivot/axle-holder-1.dxf

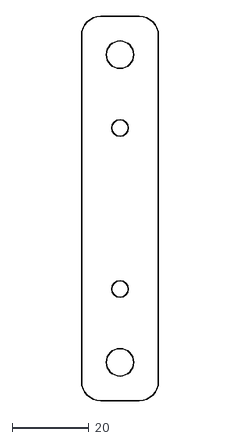
[picture p106: CAD file, 2022-04-03]
cad/central-pivot/axle-holder-1.dxf
20.0 x 100.0
