OpenSim2Real/hardware_repository/cad/lower-leg/lower-leg.step

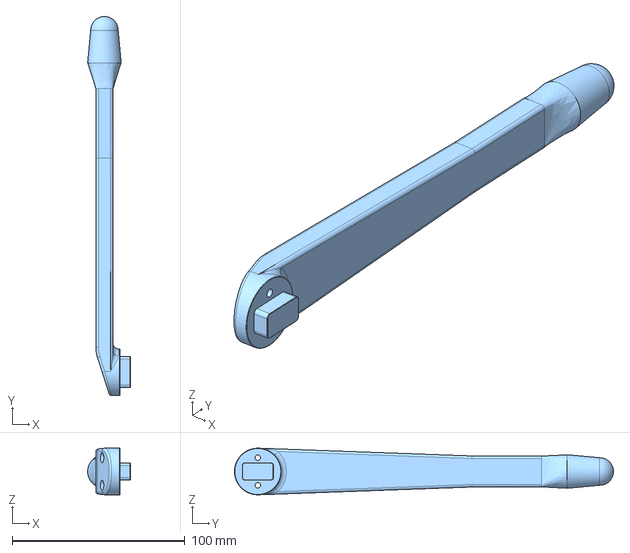
[picture p107: CAD file, 2022-04-02]
cad/lower-leg/lower-leg.step
24.7 x 219.3 x 27.0 mm
