OpenSim2Real/hardware_repository/cad/misc/tool_code_wheel_bonding.STL

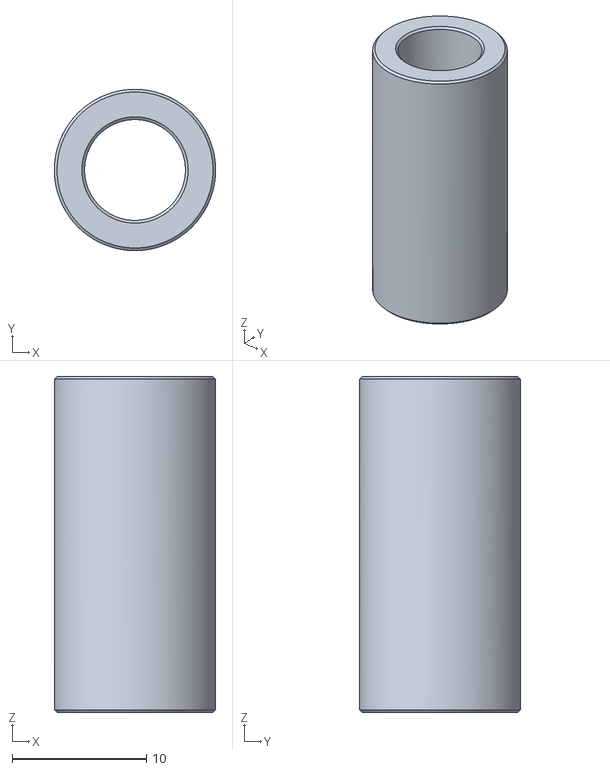
[picture p108: CAD file, 2022-04-04]
cad/misc/tool_code_wheel_bonding.STL
12.0 x 12.0 x 25.0
