OpenSim2Real/hardware_repository/cad/static-hip/transmission_pulley_at3_t30_output.step

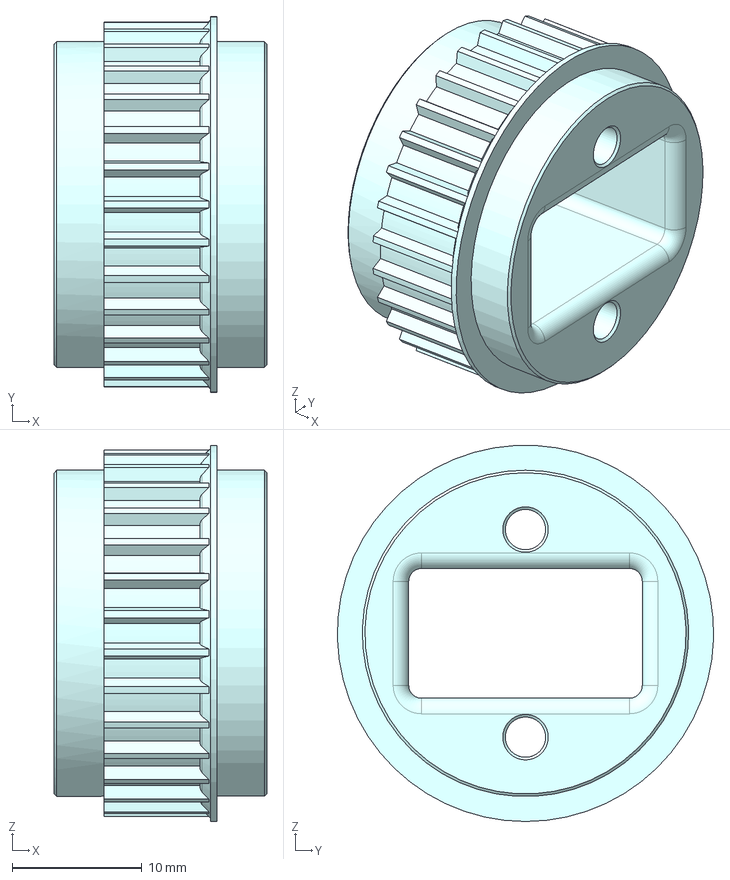
[picture p109: CAD file, 2022-04-02]
cad/static-hip/transmission_pulley_at3_t30_output.step
16.4 x 29.0 x 29.0 mm
