OpenSim2Real/hardware_repository/cad/upper-leg/upper_leg_200mm_cover.step

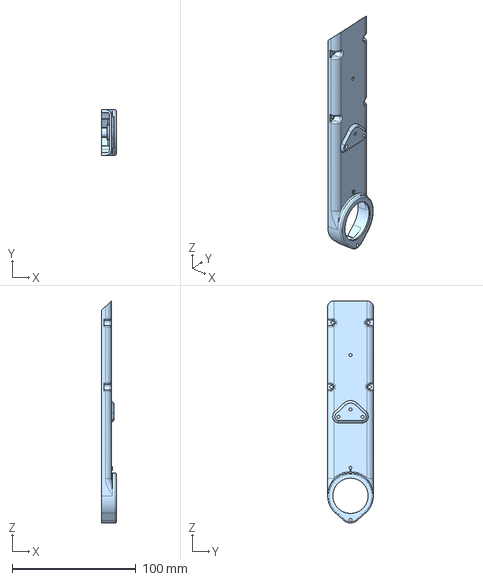
[picture p110: CAD file, 2022-04-02]
cad/upper-leg/upper_leg_200mm_cover.step
12.0 x 37.0 x 179.6 mm
