OpenSim2Real/hardware_repository/cad/central-pivot/upper-base.dxf

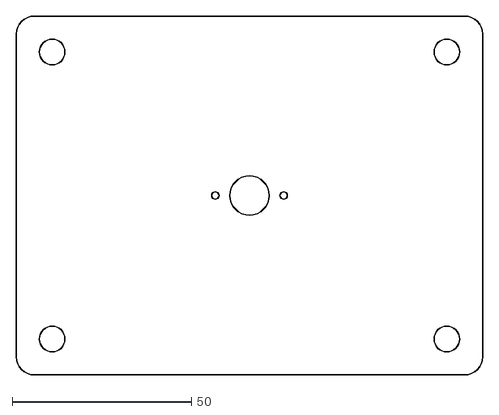
[picture p111: CAD file, 2022-04-03]
cad/central-pivot/upper-base.dxf
130.0 x 100.0
