OpenSim2Real/hardware_repository/cad/misc/tool_motor_shaft_pulley_bonding.STL

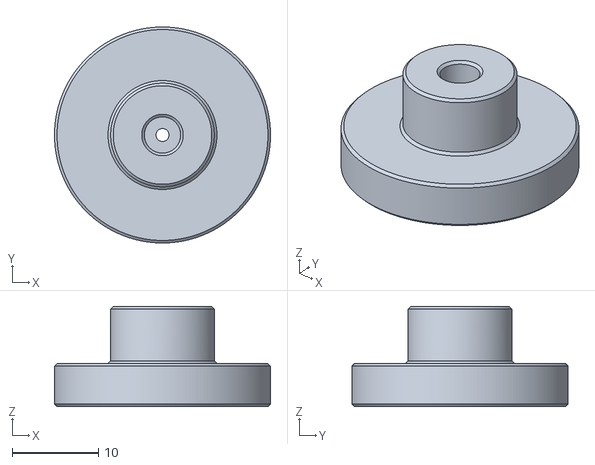
[picture p112: CAD file, 2022-04-04]
cad/misc/tool_motor_shaft_pulley_bonding.STL
25.0 x 25.0 x 11.6
