OpenSim2Real/hardware_repository/cad/static-hip/static_hip_cover_shell.step

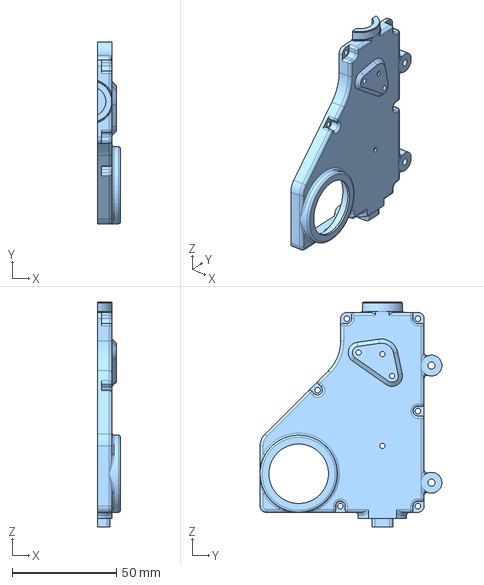
[picture p113: CAD file, 2022-04-02]
cad/static-hip/static_hip_cover_shell.step
11.0 x 87.1 x 107.8 mm
