OpenSim2Real/hardware_repository/cad/upper-leg/encoder_codewheel_pwb_mount.STL

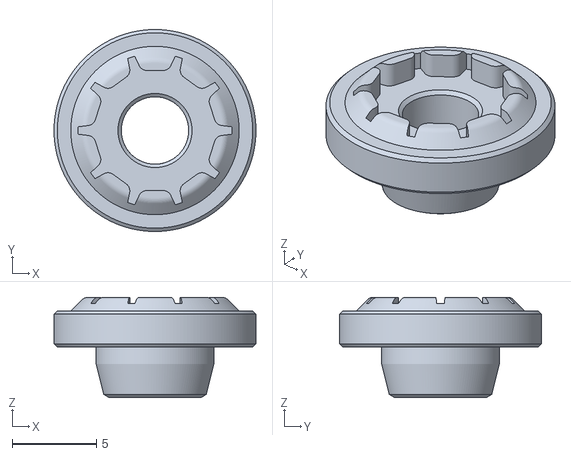
[picture p114: CAD file, 2022-04-02]
cad/upper-leg/encoder_codewheel_pwb_mount.STL
12.0 x 12.0 x 5.96
