OpenSim2Real/hardware_repository/cad/central-pivot/roof.dxf

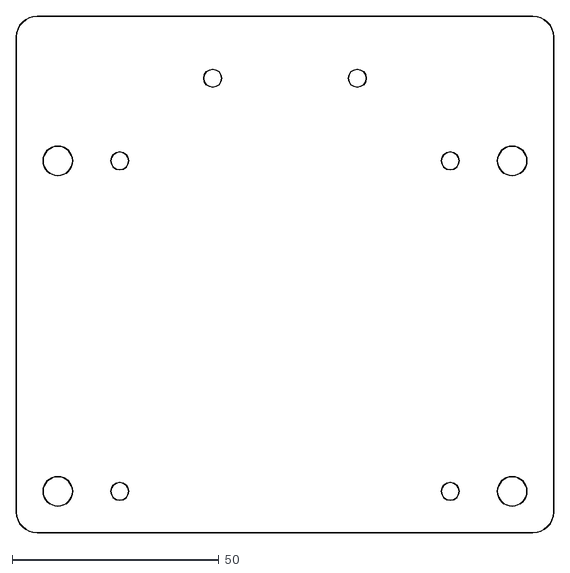
[picture p115: CAD file, 2022-04-03]
cad/central-pivot/roof.dxf
130.0 x 125.0
