OpenSim2Real/hardware_repository/cad/static-hip/encoder_codewheel_kit_mount.stl

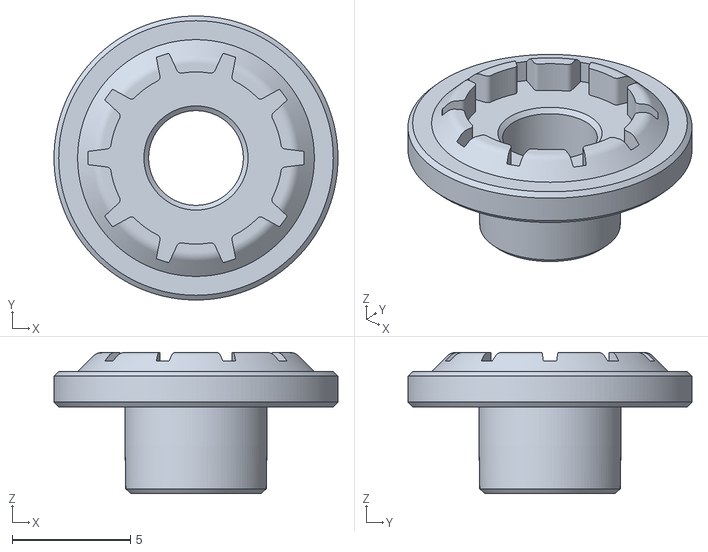
[picture p116: CAD file, 2022-04-02]
cad/static-hip/encoder_codewheel_kit_mount.stl
12.0 x 12.0 x 5.96
