OpenSim2Real/hardware_repository/cad/central-pivot/baseplate.dxf

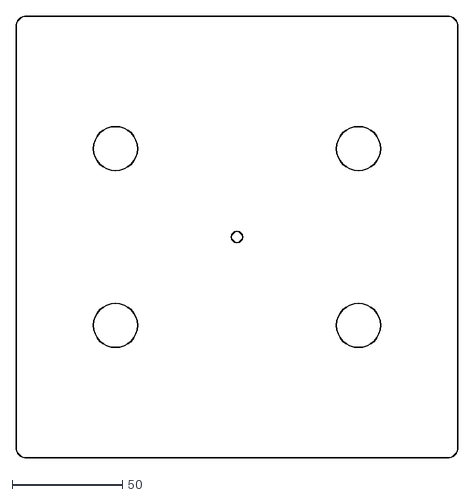
[picture p117: CAD file, 2022-04-03]
cad/central-pivot/baseplate.dxf
200.0 x 200.0
