OpenSim2Real/hardware_repository/cad/misc/pulley-protection-tool.stl

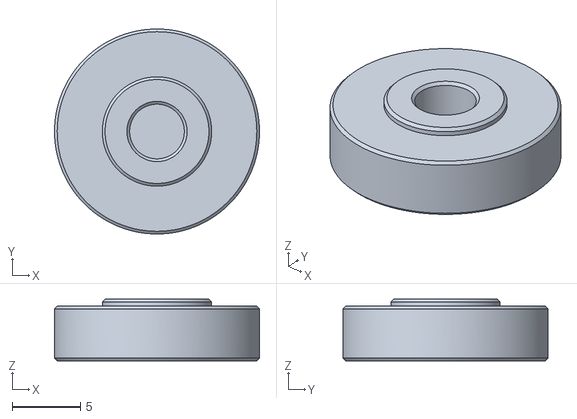
[picture p118: CAD file, 2022-04-04]
cad/misc/pulley-protection-tool.stl
15.0 x 15.0 x 4.50
