OpenSim2Real/hardware_repository/cad/static-hip/transmission_belt_tensioner_roller.step

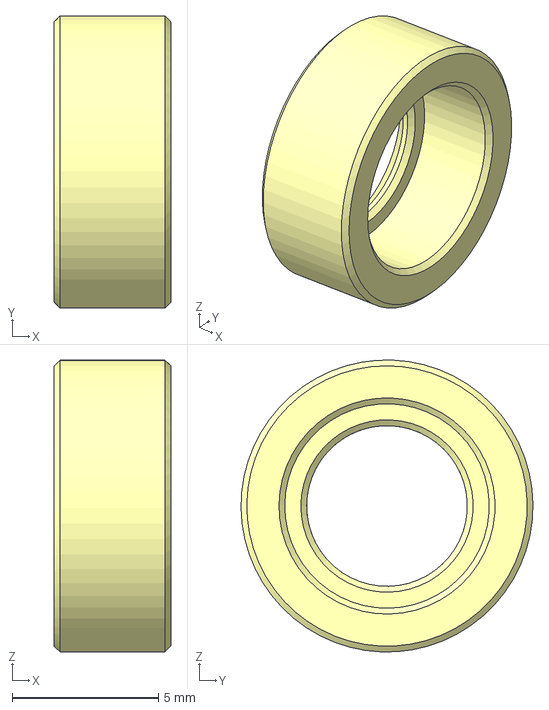
[picture p119: CAD file, 2022-04-02]
cad/static-hip/transmission_belt_tensioner_roller.step
4.00 x 10.00 x 9.99 mm
