OpenSim2Real/hardware_repository/cad/central-pivot/collar-mount.dxf

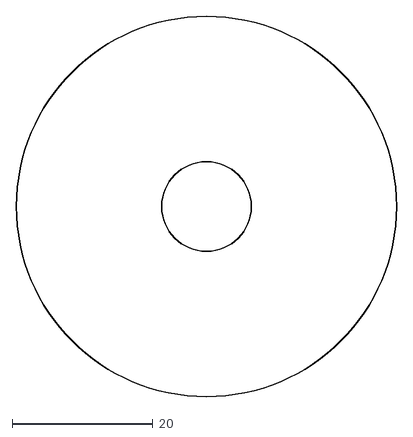
[picture p120: CAD file, 2022-04-03]
cad/central-pivot/collar-mount.dxf
54.0 x 54.0
