OpenSim2Real/hardware_repository/cad/misc/tool_motor_shaft_extraction.STL

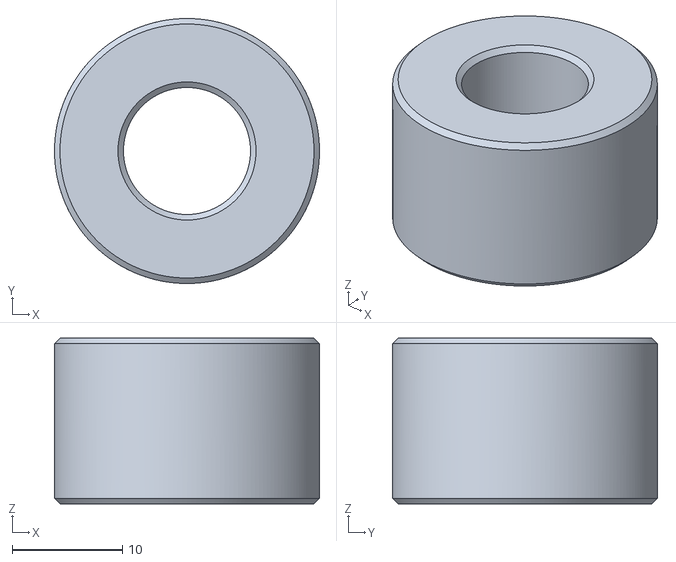
[picture p121: CAD file, 2022-04-04]
cad/misc/tool_motor_shaft_extraction.STL
24.0 x 24.0 x 15.0
