OpenSim2Real/hardware_repository/cad/static-hip/static_hip_base_shell.step

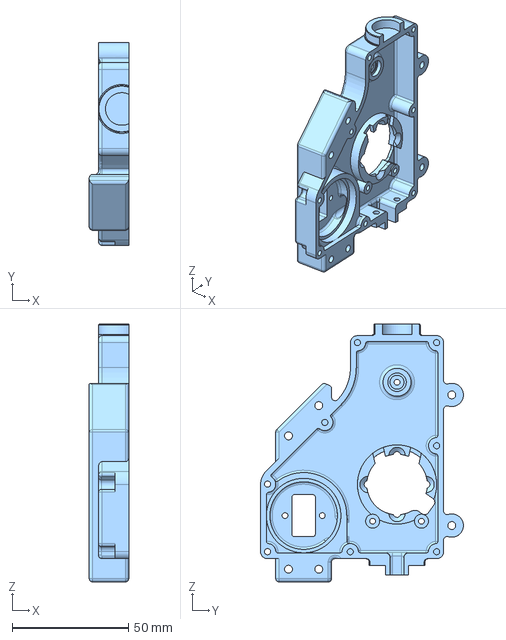
[picture p122: CAD file, 2022-04-02]
cad/static-hip/static_hip_base_shell.step
17.0 x 87.1 x 110.8 mm
