OpenSim2Real/hardware_repository/cad/central-pivot/electronic-holder.dxf

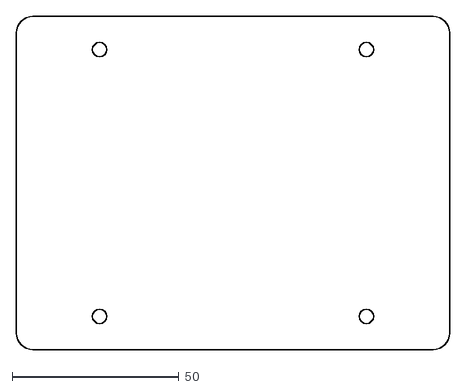
[picture p123: CAD file, 2022-04-03]
cad/central-pivot/electronic-holder.dxf
130.0 x 100.0
