OpenSim2Real/hardware_repository/cad/misc/centering-tool-1.stl

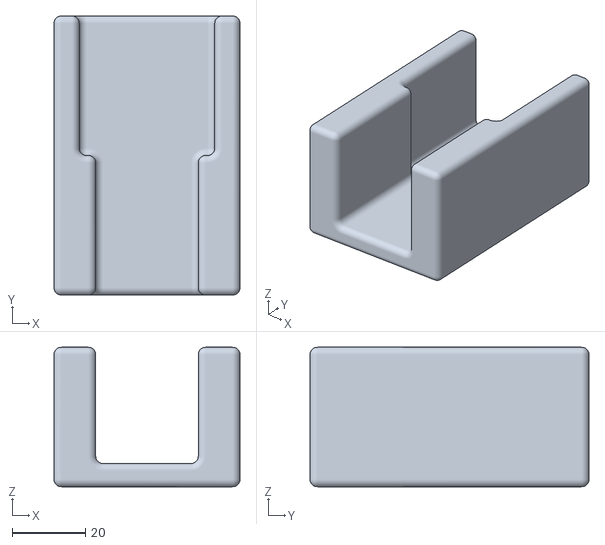
[picture p124: CAD file, 2022-04-02]
cad/misc/centering-tool-1.stl
50.8 x 76.2 x 38.1
