OpenSim2Real/hardware_repository/cad/static-hip/transmission_pulley_at3_t30_center.step

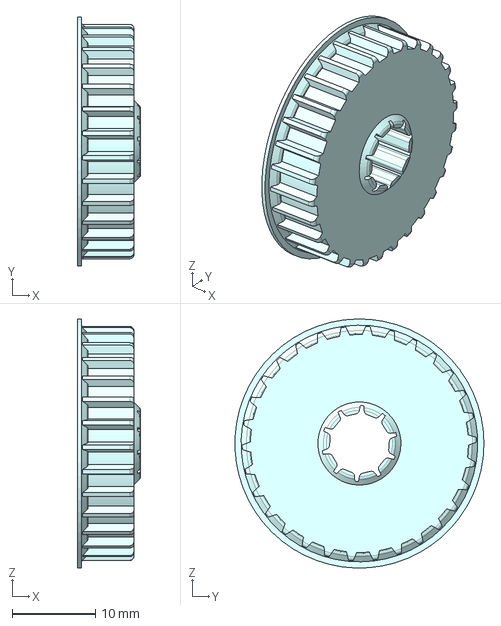
[picture p125: CAD file, 2022-04-02]
cad/static-hip/transmission_pulley_at3_t30_center.step
7.60 x 30.0 x 30.0 mm
