OpenSim2Real/hardware_repository/cad/central-pivot/lower-base.dxf

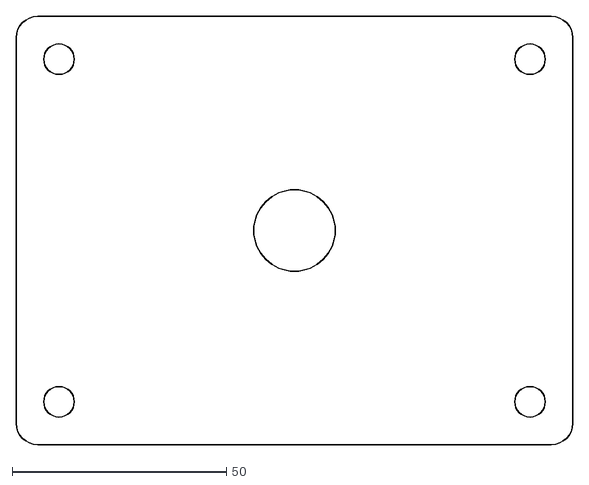
[picture p126: CAD file, 2022-04-03]
cad/central-pivot/lower-base.dxf
130.0 x 100.0
