OpenSim2Real/hardware_repository/cad/misc/centering-tool-2.stl

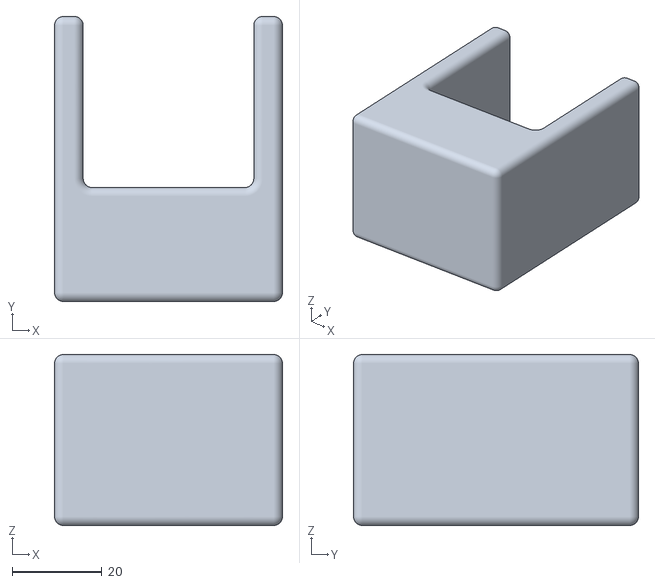
[picture p127: CAD file, 2022-04-02]
cad/misc/centering-tool-2.stl
50.8 x 63.5 x 38.1
