OpenSim2Real/hardware_repository/cad/upper-leg/upper_leg_200mm_base.step

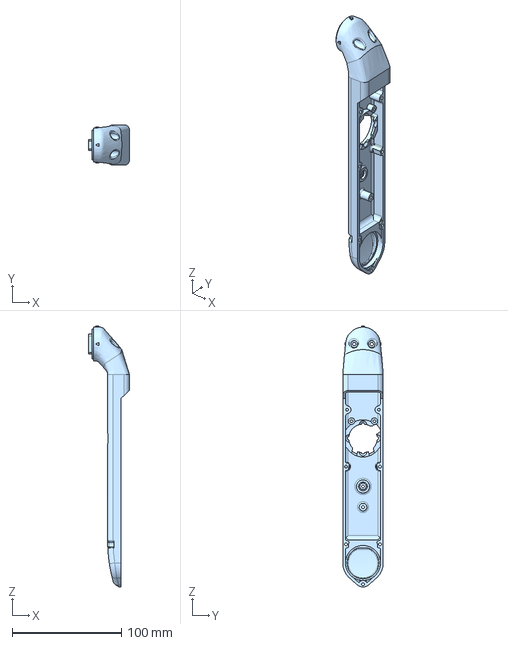
[picture p128: CAD file, 2022-04-02]
cad/upper-leg/upper_leg_200mm_base.step
37.5 x 37.0 x 238.5 mm
