OpenSim2Real/hardware_repository/cad/central-pivot/axle-mount-1.step

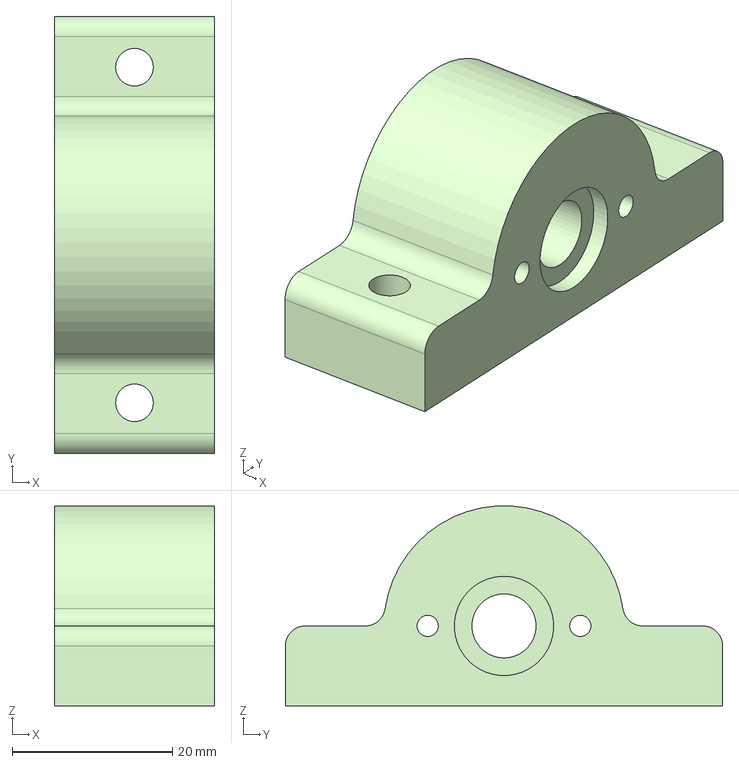
[picture p130: CAD file, 2022-04-02]
cad/central-pivot/axle-mount-1.step
20.0 x 54.6 x 25.0 mm
