OpenSim2Real/hardware_repository/cad/central-pivot/dowel-mount-upper.step

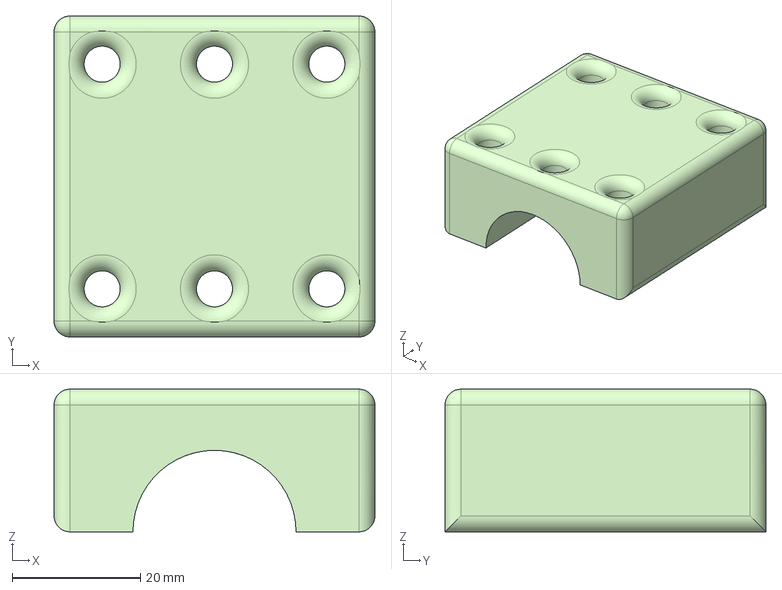
[picture p131: CAD file, 2022-04-02]
cad/central-pivot/dowel-mount-upper.step
50.0 x 50.0 x 22.2 mm
