OpenSim2Real/hardware_repository/cad/central-pivot/collar-2.step

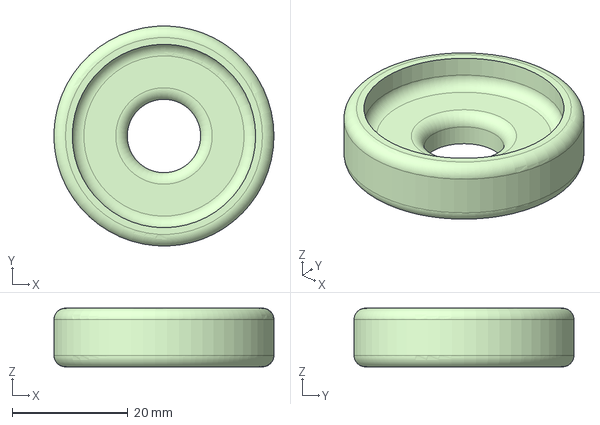
[picture p132: CAD file, 2022-04-02]
cad/central-pivot/collar-2.step
38.1 x 38.1 x 10.2 mm
