OpenSim2Real/hardware_repository/cad/central-pivot/collar-1.step

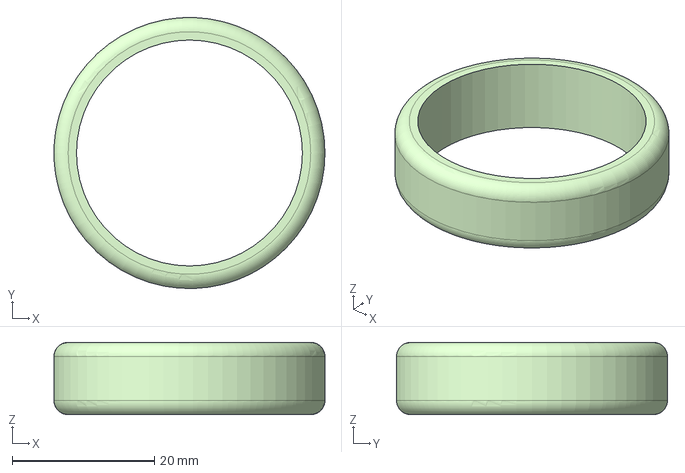
[picture p133: CAD file, 2022-04-02]
cad/central-pivot/collar-1.step
38.1 x 38.1 x 10.2 mm
