OpenSim2Real/hardware_repository/cad/central-pivot/ti-launchpad-holder.step

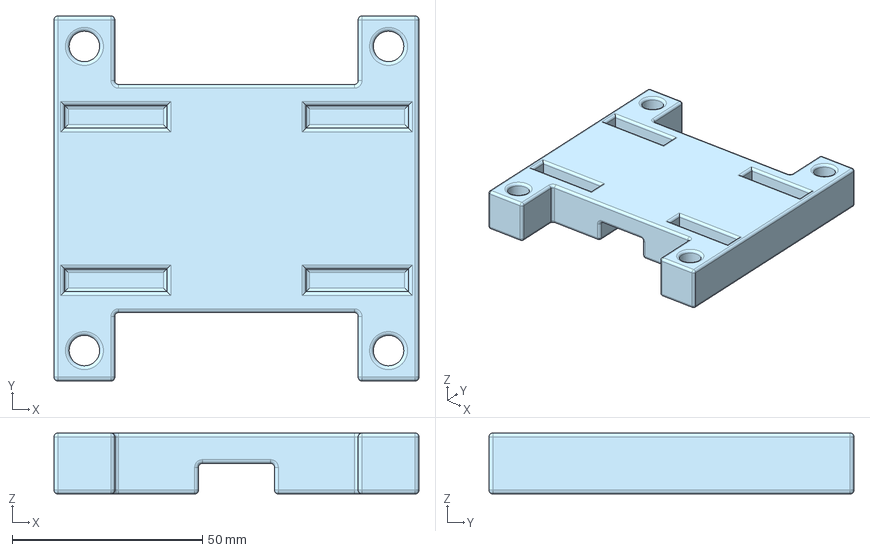
[picture p134: CAD file, 2022-04-02]
cad/central-pivot/ti-launchpad-holder.step
96.0 x 96.0 x 16.0 mm
