OpenSim2Real/hardware_repository/cad/central-pivot/dowel-mount-lower.step

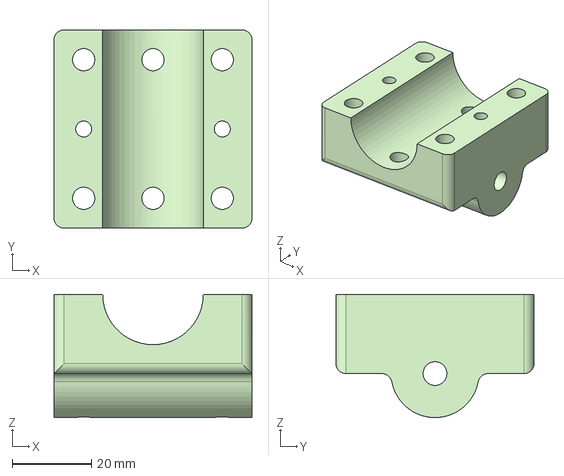
[picture p135: CAD file, 2022-04-02]
cad/central-pivot/dowel-mount-lower.step
50.0 x 50.0 x 31.1 mm
