OpenSim2Real/hardware_repository/(list of files, cad)

Other CAD files:
cad/upper-leg/transmission_pulley_at3_t30_output.step
cad/upper-leg/transmission_belt_tensioner_roller.step
cad/upper-leg/transmission_pulley_at3_t30_center.step
cad/central-pivot/axle-mount-2.step
cad/central-pivot/axle-mount-1.stl
cad/central-pivot/axle-mount-2.stl
cad/central-pivot/collar-1.stl
cad/central-pivot/collar-2.stl
cad/central-pivot/dowel-mount-lower.stl
cad/central-pivot/dowel-mount-upper.stl
cad/lower-leg/lower-leg.stl
cad/static-hip/transmission_belt_tensioner_roller.stl
cad/static-hip/transmission_pulley_at3_t30_center.stl
cad/static-hip/transmission_pulley_at3_t30_output.stl
cad/upper-leg/transmission_belt_tensioner_roller.stl
cad/upper-leg/transmission_pulley_at3_t30_center.stl
cad/upper-leg/transmission_pulley_at3_t30_output.stl
