OpenSim2Real/hardware_repository/docs/physical/build_instructions_leg.rst

.. _build_instructions_leg:

================
Leg Instructions
================

Introduction
============

The Robotic Leg is part of the complete Monopod, and the build instructions follows closely from
the build instructions provided by the Open Dynamic Robot Initiative. However, several clarifying
instructions have been added here to aid construction.

Before starting assembly, ensure that all parts in the Bill of Materials for the Robotic Leg have arrived.

About ODRI
==========

The Open Dynamic Robot Initiative :footcite:`grimminger2020open` is a project by the Max Planck Institute for Intelligent Systems to
create a low cost, open source, robotics platform for researchers to experiment with legged actuation.
ODRI's robotic platform consists of modular actuators which can be assembled in various configurations
to serve different purposes.

This project uses 2 such modular actuators, assembled into a 2-jointed Robotic Leg. Several modifications
from the base design were made to facilitate connection with the Central Pivot assembly, but most of the
assembly instructions remain unchanged.

The ODRI-provided instructions are found here:

- `ODRI Hardware Repository <https://github.com/open-dynamic-robot-initiative/open_robot_actuator_hardware>`_.

This section provides additional commentary and troubleshooting advice.

3D Printing
===========

Instructions
------------

The Robotic Leg requires the following STL parts to be printed:

+-----------+-------------------------------------------------------------------------------------------------------------------------------------------+
| Quantity  | Part Name                                                                                                                                 |
+===========+===========================================================================================================================================+
| 1         | `Static Hip Base Shell <https://github.com/OpenSim2Real/hardware_repository/blob/main/cad/static-hip/static_hip_base_shell.stl>`_         |
+-----------+-------------------------------------------------------------------------------------------------------------------------------------------+
| 1         | `Static Hip Cover Shell <https://github.com/OpenSim2Real/hardware_repository/blob/main/cad/static-hip/static_hip_cover_shell.stl>`_       |
+-----------+-------------------------------------------------------------------------------------------------------------------------------------------+
| 1         | `Upper Leg Base Shell <https://github.com/OpenSim2Real/hardware_repository/blob/main/cad/upper-leg/upper_leg_200mm_base.stl>`_            |
+-----------+-------------------------------------------------------------------------------------------------------------------------------------------+
| 1         | `Upper Leg Cover Shell <https://github.com/OpenSim2Real/hardware_repository/blob/main/cad/upper-leg/upper_leg_200mm_cover.stl>`_          |
+-----------+-------------------------------------------------------------------------------------------------------------------------------------------+
| 1         |  `Lower Leg <https://github.com/OpenSim2Real/hardware_repository/blob/main/cad/lower-leg/lower-leg.stl>`_                                 |
+-----------+-------------------------------------------------------------------------------------------------------------------------------------------+
| 2         | `Codewheel Mount <https://github.com/OpenSim2Real/hardware_repository/blob/main/cad/static-hip/encoder_codewheel_kit_mount.stl>`_         |
+-----------+-------------------------------------------------------------------------------------------------------------------------------------------+
| 2         | `Output Pulley <https://github.com/OpenSim2Real/hardware_repository/blob/main/cad/static-hip/transmission_pulley_at3_t30_output.stl>`_    |
+-----------+-------------------------------------------------------------------------------------------------------------------------------------------+
| 2         | `Center Pulley <https://github.com/OpenSim2Real/hardware_repository/blob/main/cad/static-hip/transmission_pulley_at3_t30_center.stl>`_    |
+-----------+-------------------------------------------------------------------------------------------------------------------------------------------+
| 4         | `Tensioner Roller <https://github.com/OpenSim2Real/hardware_repository/blob/main/cad/upper-leg/transmission_belt_tensioner_roller.stl>`_  |
+-----------+-------------------------------------------------------------------------------------------------------------------------------------------+
| 1         | `Centering Tool 1 <https://github.com/OpenSim2Real/hardware_repository/blob/main/cad/misc/centering-tool-1.stl>`_                         |
+-----------+-------------------------------------------------------------------------------------------------------------------------------------------+
| 1         | `Centering Tool 2 <https://github.com/OpenSim2Real/hardware_repository/blob/main/cad/misc/centering-tool-2.stl>`_                         |
+-----------+-------------------------------------------------------------------------------------------------------------------------------------------+
| 1         | `Pulley Assembly Tool <https://github.com/OpenSim2Real/hardware_repository/blob/main/cad/misc/pulley-assembly-tool.STL>`_                 |
+-----------+-------------------------------------------------------------------------------------------------------------------------------------------+
| 1         | `Pulley Protection Tool <https://github.com/OpenSim2Real/hardware_repository/blob/main/cad/misc/pulley-protection-tool.stl>`_             |
+-----------+-------------------------------------------------------------------------------------------------------------------------------------------+
| 1         | `Code Wheel Bonding Tool <https://github.com/OpenSim2Real/hardware_repository/blob/main/cad/misc/tool_code_wheel_bonding.STL>`_           |
+-----------+-------------------------------------------------------------------------------------------------------------------------------------------+
| 1         | `Motor Shaft Extraction Tool <https://github.com/OpenSim2Real/hardware_repository/blob/main/cad/misc/tool_motor_shaft_extraction.STL>`_   |
+-----------+-------------------------------------------------------------------------------------------------------------------------------------------+
| 1         | `Motor Shaft Bonding Tool <https://github.com/OpenSim2Real/hardware_repository/blob/main/cad/misc/tool_motor_shaft_pulley_bonding.STL>`_  |
+-----------+-------------------------------------------------------------------------------------------------------------------------------------------+

ODRI has the following recommendations for 3D printing. Adapt them as necessary for the parts we have.

- `3D Printed Parts Details <https://github.com/open-dynamic-robot-initiative/open_robot_actuator_hardware/blob/master/mechanics/actuator_module_v1/details/details_3d_printed_parts.md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>`_

Our team recommends the SLS process with Nylon 12 material to print all the parts. Our team recommends not
using inexpensive FDM printers with the commonly available PLA material - some FDM printers do not have
sufficient precision, and this will cause problems when fitting parts together. The PLA material also has
a low glass transition temperature, which constitutes a risk of part deformation under high pressures or
temperatures.

The STL files provided in our BOM have their holes and features offset by 0.2mm of radius. This ensures
that all bearings and 3D printed parts will fit into each other with minimal application of force. 3D
printers of inferior quality often overfill or underfill these features, therefore this modification to
the STL files is necessary. STEP files without this feature modification are also provided in the BOM.

Preparation
-----------

ODRI has the following instructions for 3D printed parts preparation. Adapt them as necessary for the parts we have.

- `Shell Preparation <https://github.com/open-dynamic-robot-initiative/open_robot_actuator_hardware/blob/master/mechanics/actuator_module_v1/details/details_shell_preparation.md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>`_

- `Output Pulley Preparation <https://github.com/open-dynamic-robot-initiative/open_robot_actuator_hardware/blob/master/mechanics/actuator_module_v1/details/details_output_pulley_preparation.md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>`_

Suggestions:

- If the 3D printed parts have their features adjusted as above, then the further modification of part dimensions
  described by ODRI are no longer required, although some drilling of M2.5 and M3 holes to size might still be
  necessary. When that has been completed, the described tapping of holes for M3 screws, and M2.5 and M3
  helicoils can be started.

- Our team recommends printing dummy parts to practise tapping and helicoil insertion, before applying this
  procedure on the real parts. This is important because an incorrectly inserted helicoil could cause an
  actuator shell to not close properly.

- The bearings now might be a bit too loose for their bearing seats. If that is the case, then apply some thin tape
  around the rim of the bearings until it is a snug fit.

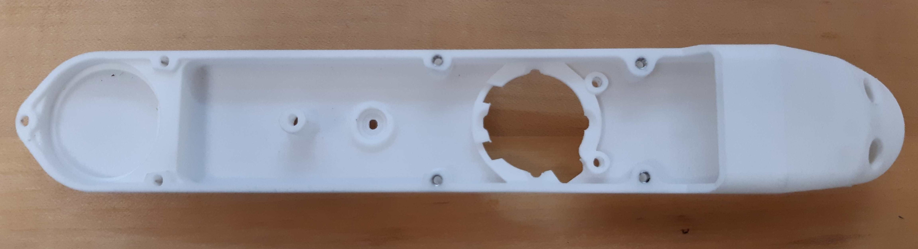
[picture p136: docs/physical/leg_images/leg_1.jpg]


   Upper Leg Base Shell, after helicoil insertion and threading. Do the same thing for the Static Hip Base Shell.

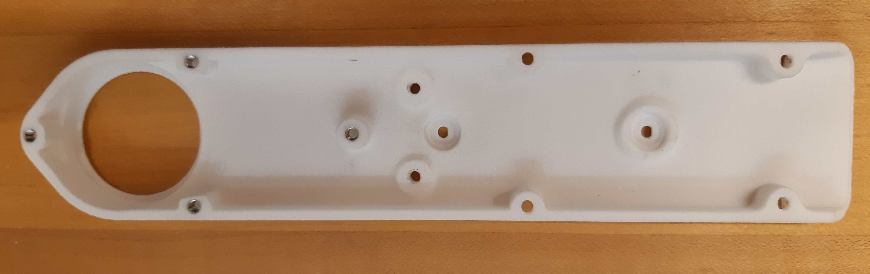
[picture p137: docs/physical/leg_images/leg_5.jpg]


   Upper Leg Cover Shell, after helicoil insertion and threading. Do the same thing for the Static Hip Cover Shell.

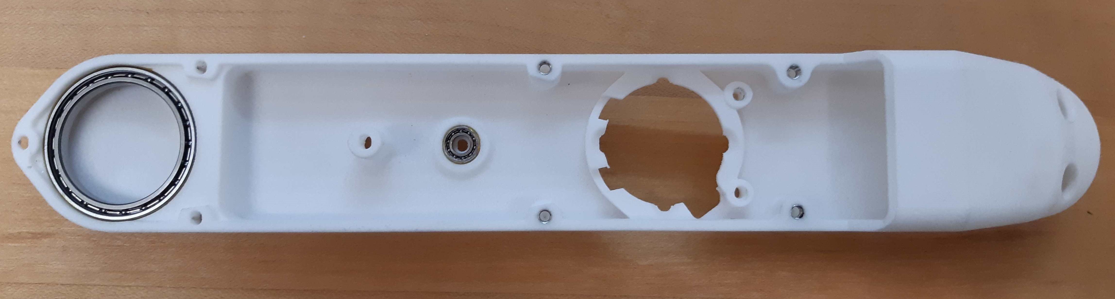
[picture p138: docs/physical/leg_images/leg_2.jpg]


   Upper Leg Base Shell, with bearings inserted.

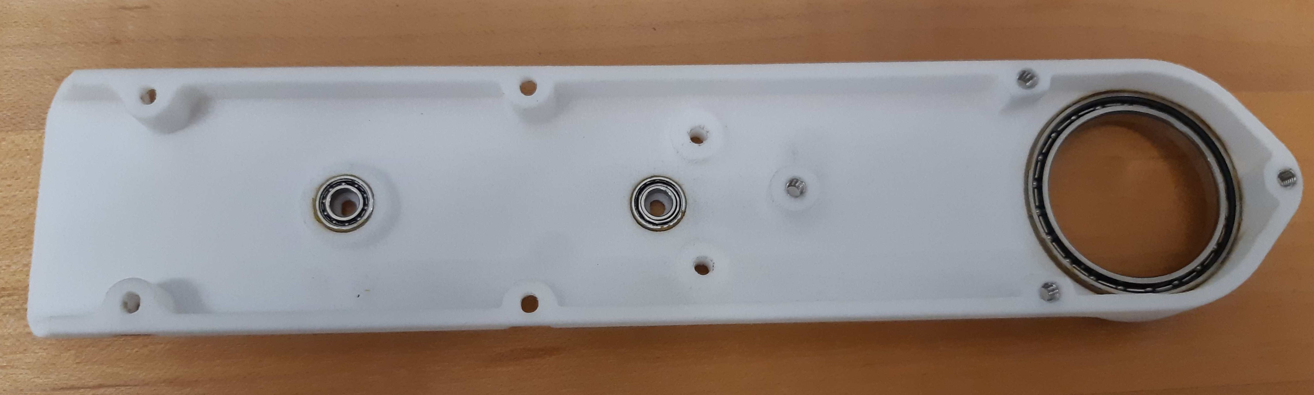
[picture p139: docs/physical/leg_images/leg_7.jpg]


   Upper Leg Cover Shell, with bearings inserted.

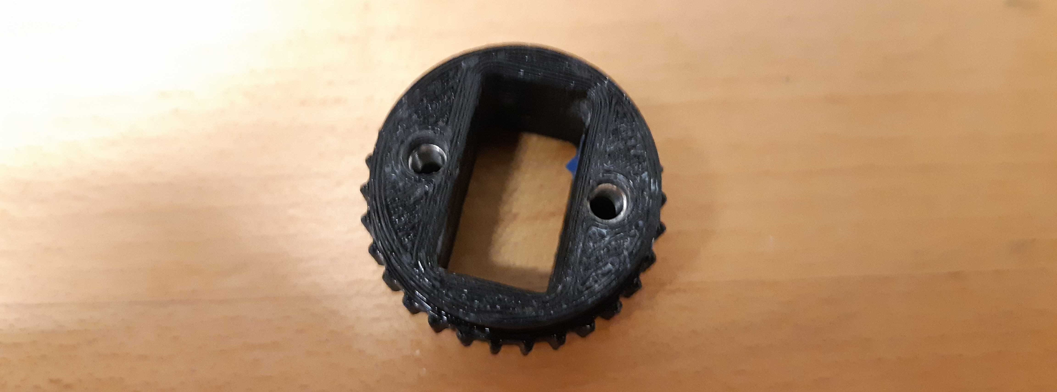
[picture p140: docs/physical/leg_images/outputpulley.jpg]


   Output Pulley, after helicoil insertion. Make 2 of these.

Motor Shaft
===========

ODRI has the following instructions for the motor shaft preparation.

- `Encoder Disassembly <https://github.com/open-dynamic-robot-initiative/open_robot_actuator_hardware/blob/master/mechanics/actuator_module_v1/details/details_encoder_kit_disassembly.md>`_: Process to disassemble an encoder to get the encoder code wheel and the encoder electronics.

- `Machined Parts Preparation <https://github.com/open-dynamic-robot-initiative/open_robot_actuator_hardware/blob/master/mechanics/actuator_module_v1/details/details_machined_parts.md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>`_: Instructions to get the necessary machined parts.

- `Motor Shaft Preparation <https://github.com/open-dynamic-robot-initiative/open_robot_actuator_hardware/blob/master/mechanics/actuator_module_v1/details/details_motor_shaft_preparation.md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>`_: Process to create a motor shaft assembly with the encoder code wheel

Suggestions:

- The motor shaft preparation steps are quite difficult to follow. The machined timing belt pulleys are difficult
  and/or expensive to get and even more difficult to machine, and cutting the encoder disc down to size is also a
  very difficult and delicate process. The motor shaft preparation guide also requires a lot of finessing to get right.

- Instead, our team and ODRI, recommends buying a pre-built motor shaft here:
  `PWB Encoders ODRI Kit <https://www.pwb-encoders.com/news/produkte/-/detail/news/plugplay-loesung-fuer-ein-open-source-roboter-projekt--12014>`_. Our team recommends buying this early, and getting extras, because the lead time for this product can get quite long for North American users.

Encoder
=======

ODRI has the following instructions to prepare the encoders. Follow these, but disregard the instructions to crimp the Hirose connectors, as we will
be using different connectors.

- `Encoder Preparation <https://github.com/open-dynamic-robot-initiative/open_robot_actuator_hardware/blob/master/mechanics/actuator_module_v1/details/details_encoder_preparation.md>`_

Suggestions:

- Measure out 30-50cm for each encoder wire.
- Again, do not follow the instructions given for the Hirose connectors.

Motor
=====

ODRI has the following instructions to prepare the motors:

- `Motor Preparation <https://github.com/open-dynamic-robot-initiative/open_robot_actuator_hardware/blob/master/mechanics/actuator_module_v1/details/details_motor_preparation.md>`_

Suggestions:

- Do not forget that the motor shaft is connected to the motor rotor by 2 threaded inserts.
  Make sure that those are removed before attempting to separate the motor shaft from the motor rotor,
  otherwise you risk shearing parts of the threaded insert, or the motor shaft.

- Remember that when the BLDC motors were bought from the store, they came with a brass spacer.
  Make sure to keep these spacers safely, they are needed in the leg actuator assembly process.

Center Pulley
=============

`ODRI has the following instructions to prepare the center pulley <https://github.com/open-dynamic-robot-initiative/open_robot_actuator_hardware/blob/master/mechanics/actuator_module_v1/details/details_center_pulley_preparation.md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>`_

Suggestions:

- It is important to ensure that the machined timing belt pulley is centered on the 3D-printed part and is vertical.
  Otherwise, the timing belt will not mesh properly with it. We recommend filing down the side of the machined pulley
  that will be pushed into the 3D-printed part to reduce the amount of force needed to push the two parts together
  using an arbor press.

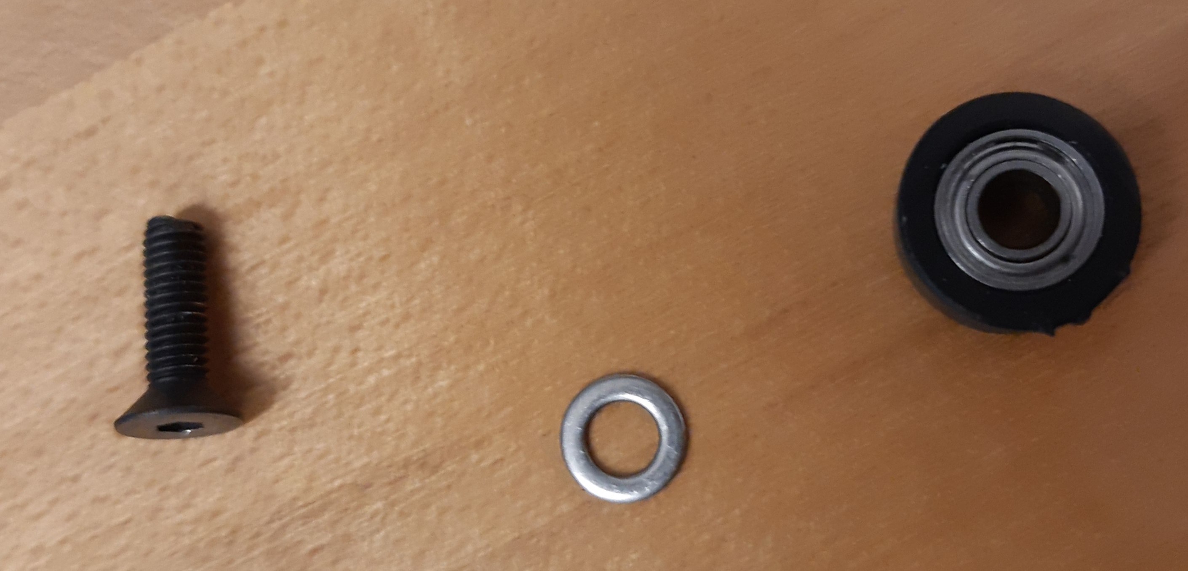
[picture p141: docs/physical/leg_images/roller_2.jpg]


   3D-printed roller with bearing inserted, with spacer and screw

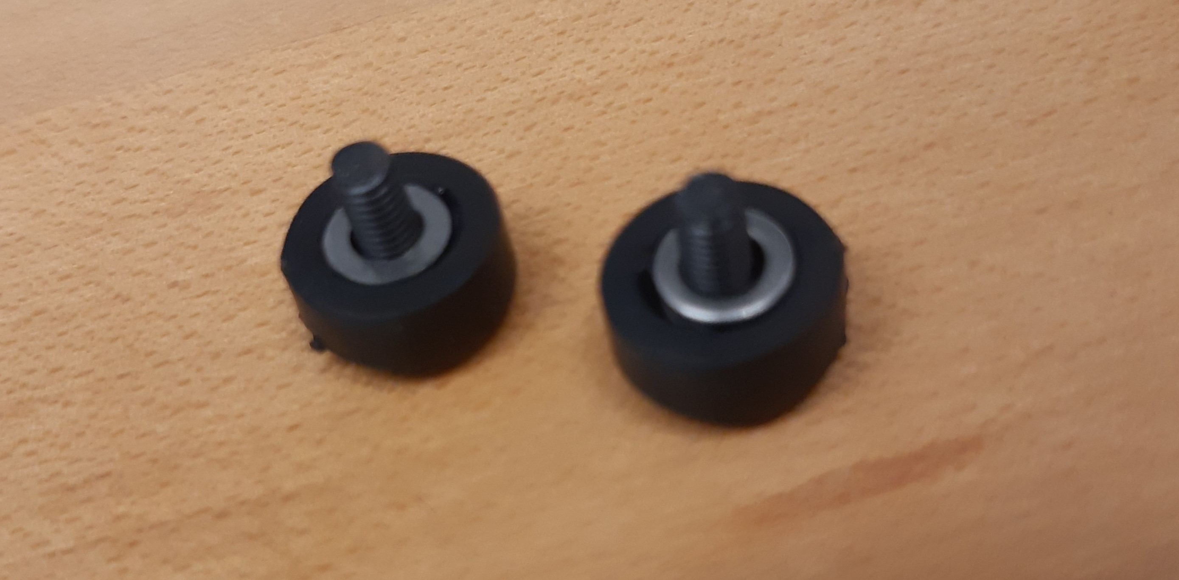
[picture p142: docs/physical/leg_images/roller_4.jpg]


   Completed rollers.

Final Assembly
===============

At this point, the subcomponents have all been assembled and it is possible to put together the actuator.

ODRI has the following instructions for the final assembly process.

- `Final Assembly Process <https://github.com/open-dynamic-robot-initiative/open_robot_actuator_hardware/blob/master/mechanics/actuator_module_v1/details/details_actuator_module_assembly.md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>`_

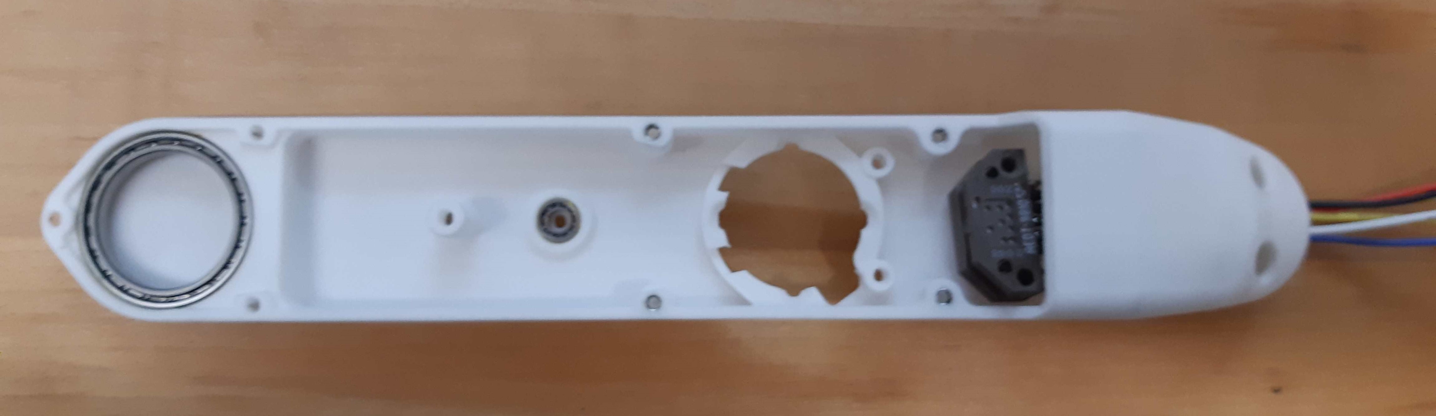
[picture p143: docs/physical/leg_images/leg_3.jpg]


   Upper Leg Base Cover with encoder inserted

The assembly process is similar for both the "hip" and "leg" actuator.

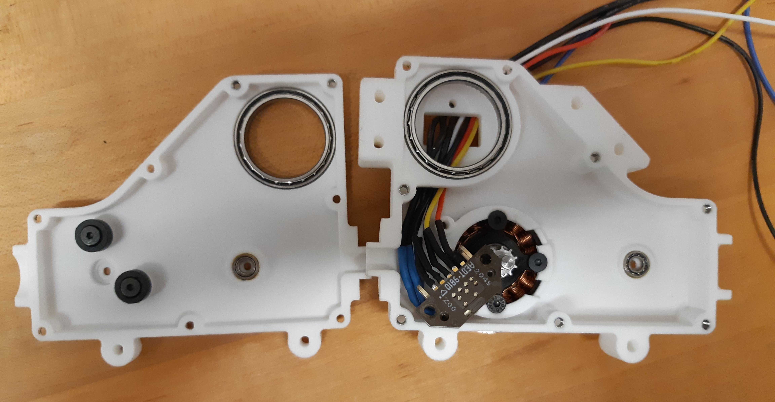
[picture p144: docs/physical/leg_images/hip_4.jpg]


   Hip base and cover shell, with encoder inserted.

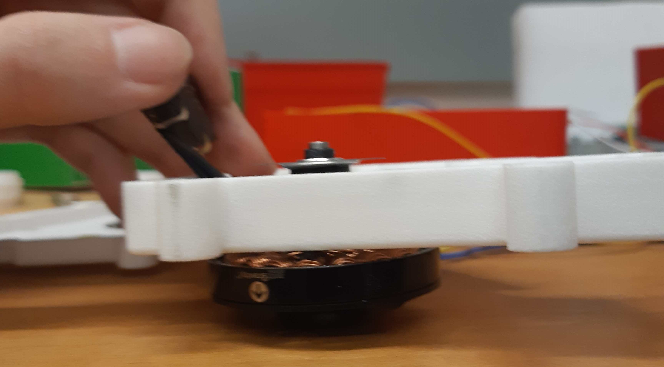
[picture p145: docs/physical/leg_images/hip_1.jpg]


   Encoder disc inserted into the motor shaft, on the Hip base shell

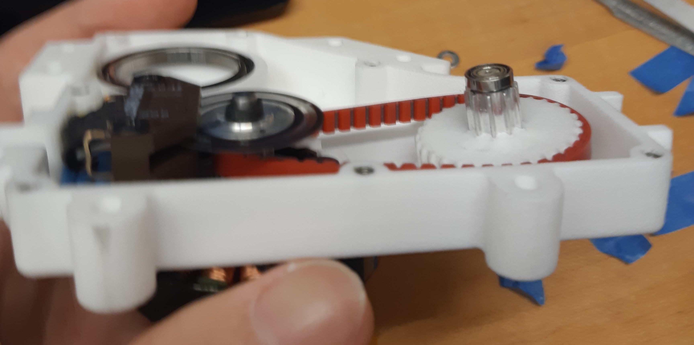
[picture p146: docs/physical/leg_images/hip_2.jpg]


   Partially assembled hip actuator.

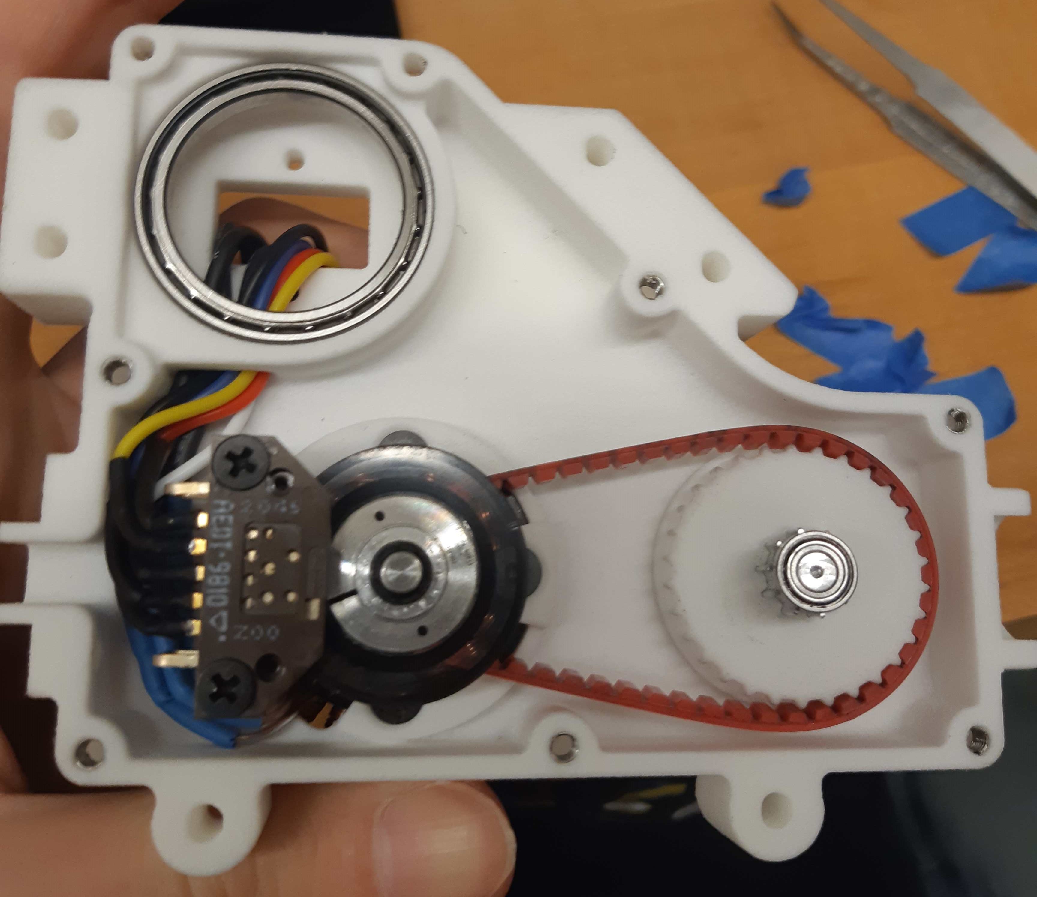
[picture p147: docs/physical/leg_images/hip_3.jpg]


   Another view of a partially assembled hip actuator.

Suggestions:

- Before closing the shells of the leg or hip actuators, ensure that the encoder disc, attached to the motor shaft,
  is spinning freely and is not being scratched by the encoder reader or interfering with any other part.
  If they are interfering, you must disassemble the encoder assembly again and correct for any misalignments which
  may have caused the encoder disc to not spin freely. The tolerance is very tight; the encoder wheel must spin
  within a ~3mm air space, so be very careful.

- Before attaching the motors to the shell, make sure that the motor stator, rotor and shaft, as well as the shell,
  are free of any magnetic and non-magnetic debris. Magnetic debris can be removed with strong tape.
- Make sure that the spinning 3D printed parts are clean of print artifacts, otherwise they might interfere with
  non-spinning parts and cause friction. Protect all the bearings from debris, and don’t apply a lot of axial force
  on them, otherwise the bearings might have more friction than expected. If possible, use shielded bearings instead of
  open bearings - this is totally worth it, even though the open bearings are cheaper.

Conclusion
==========

At the end of this section, there should be a single "hip" actuator, and a single "leg" actuator assembled. Do not
attach them together yet, as testing requires both actuators to be seperated first.

  .. footbibliography::
