OpenSim2Real/hardware_repository/docs/physical/build_requirements.rst

.. _build_requirements:

==================
Build Requirements
==================

Introduction
============

The following tools and skills are required for successful construction of the Monopod.

Shop and Tool
=============

As far as possible, the tools required for successful construction are chosen to be
readily available.

.. list-table:: Mechanical Tools Required

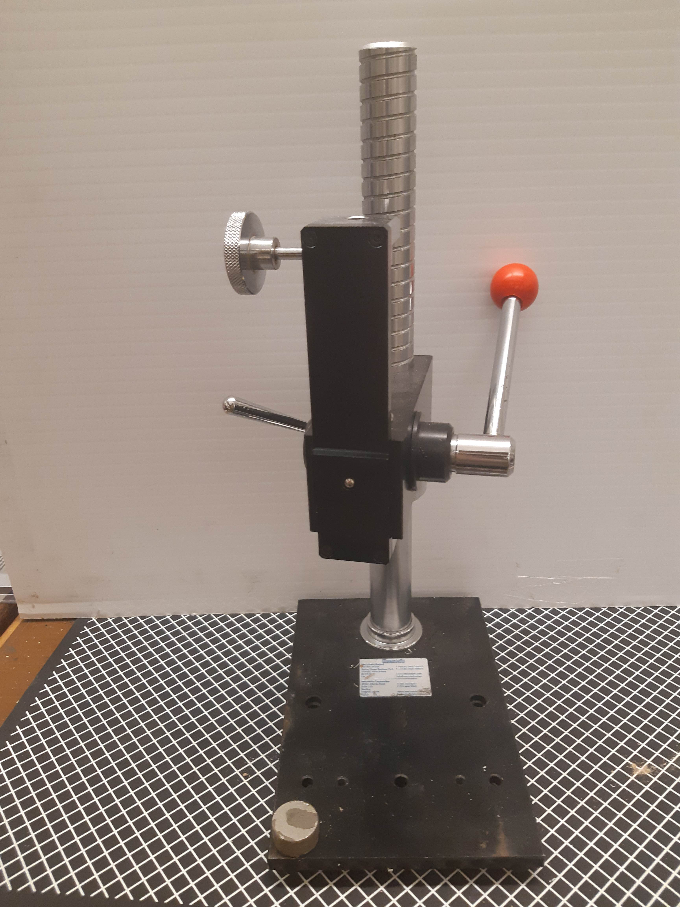
[picture p183: docs/physical/tools_images/arborpress.jpg]
   * - 

          Arbor Press

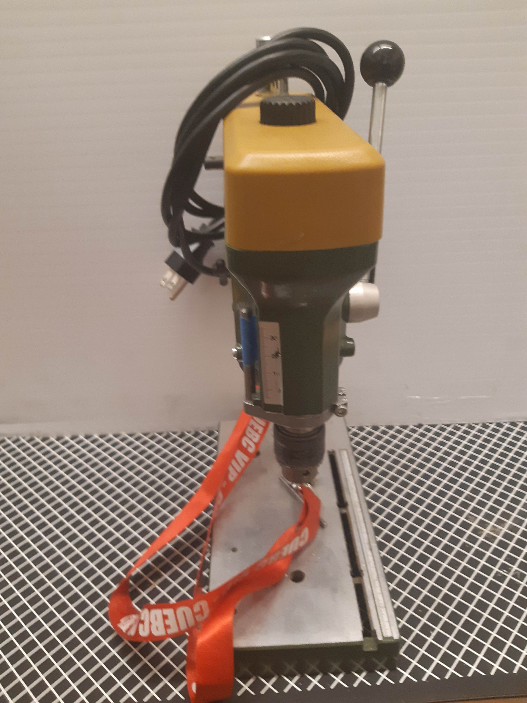
[picture p184: docs/physical/tools_images/drill.jpg]
     - 

          Tabletop Mill

     - 

          Drill Bits

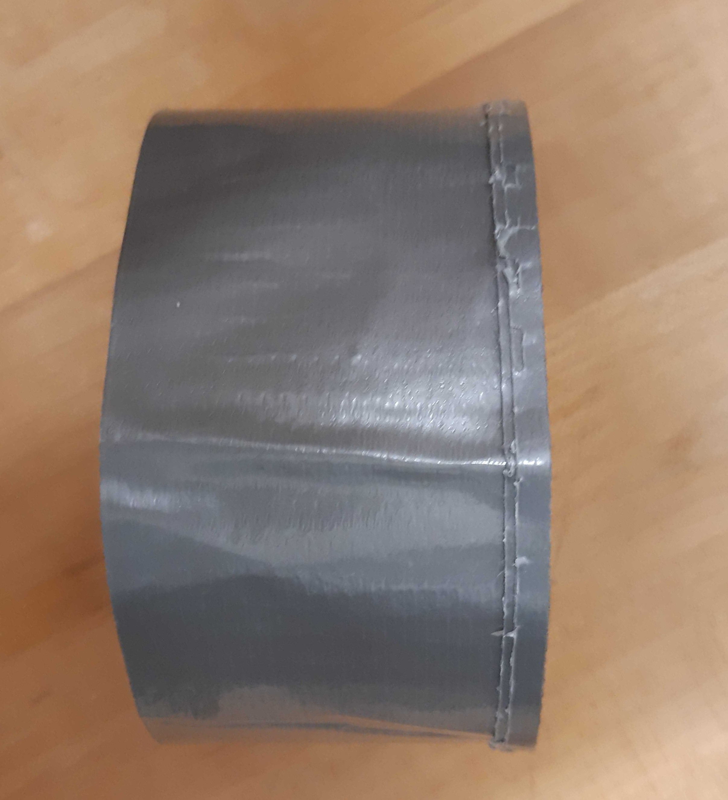
[picture p186: docs/physical/tools_images/ducttape.jpg]
   * - 

          Duct Tape

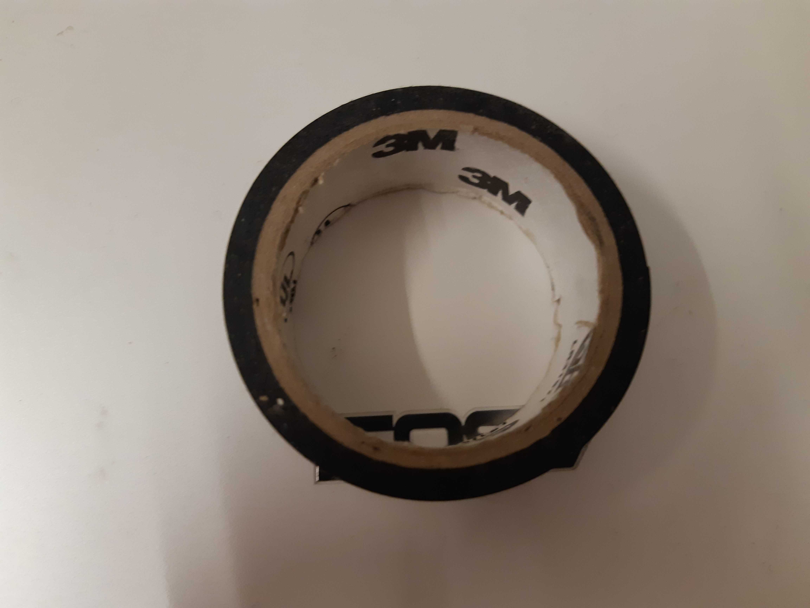
[picture p187: docs/physical/tools_images/electrical_tape.jpg]
     - 

          Electrical Tape

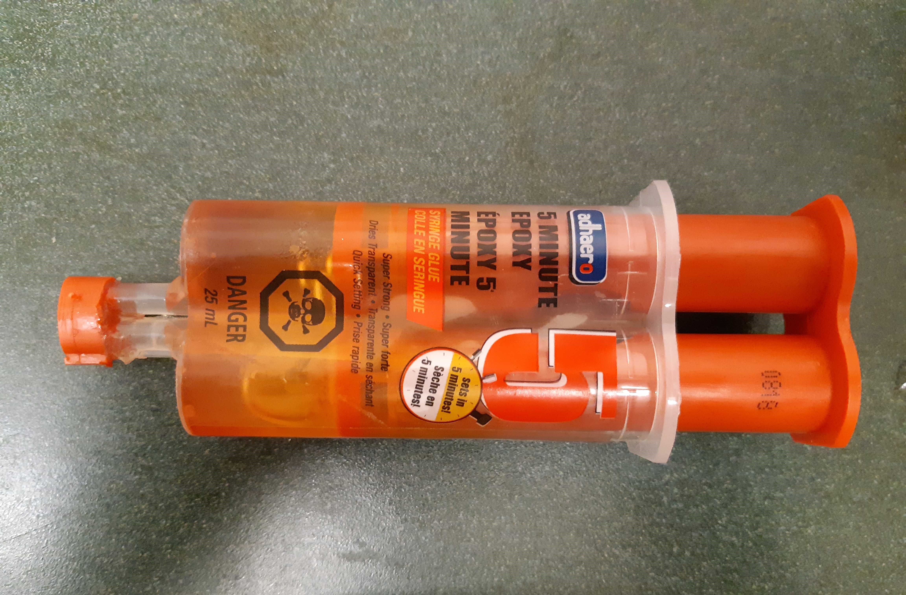
[picture p188: docs/physical/tools_images/epoxy.jpg]
     - 

          Epoxy

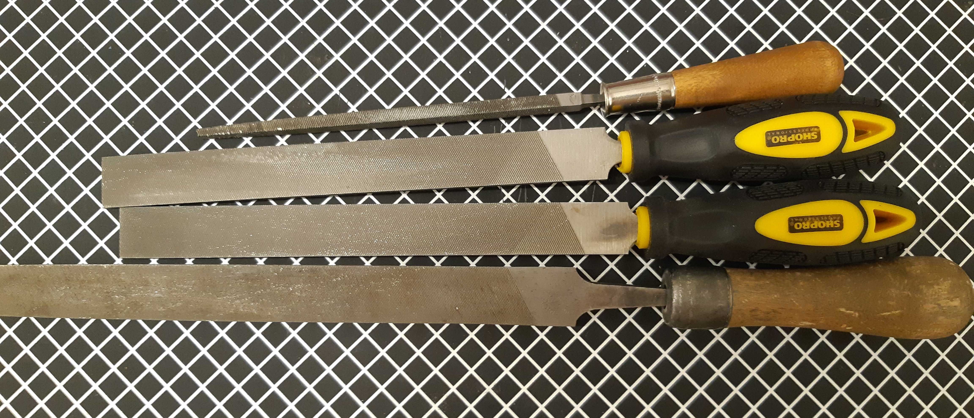
[picture p189: docs/physical/tools_images/files.jpg]
   * - 

          Files

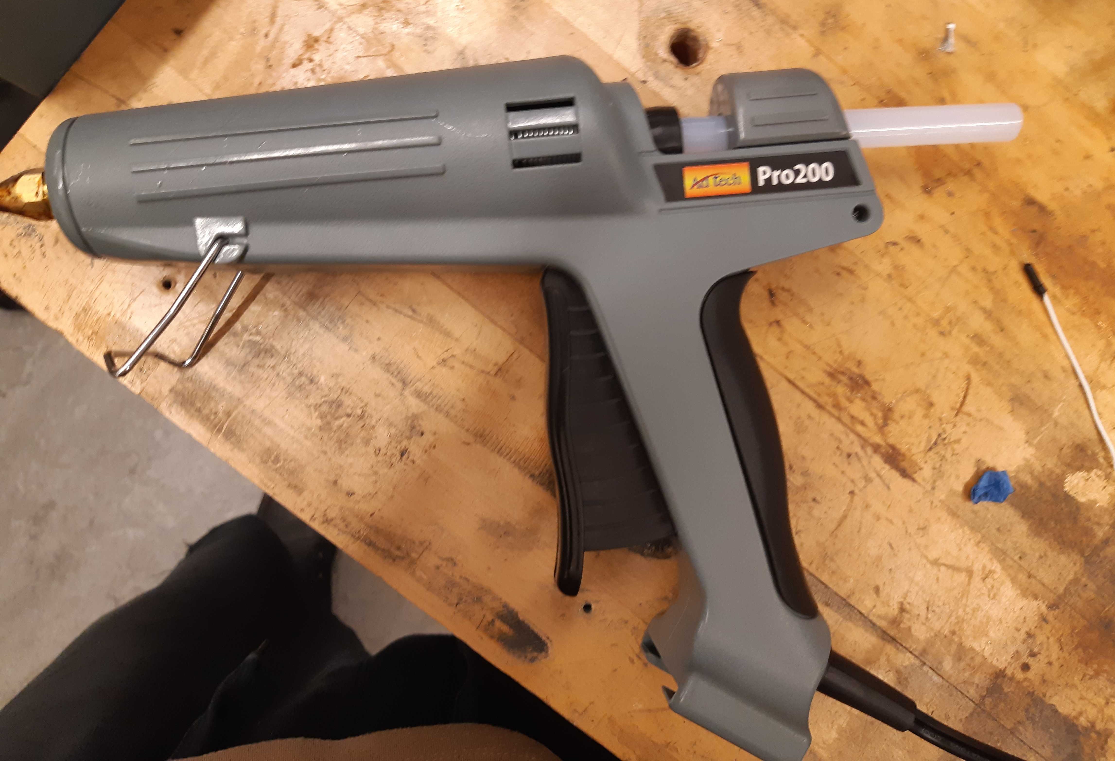
[picture p190: docs/physical/tools_images/gluegun.jpg]
     - 

          Glue Gun

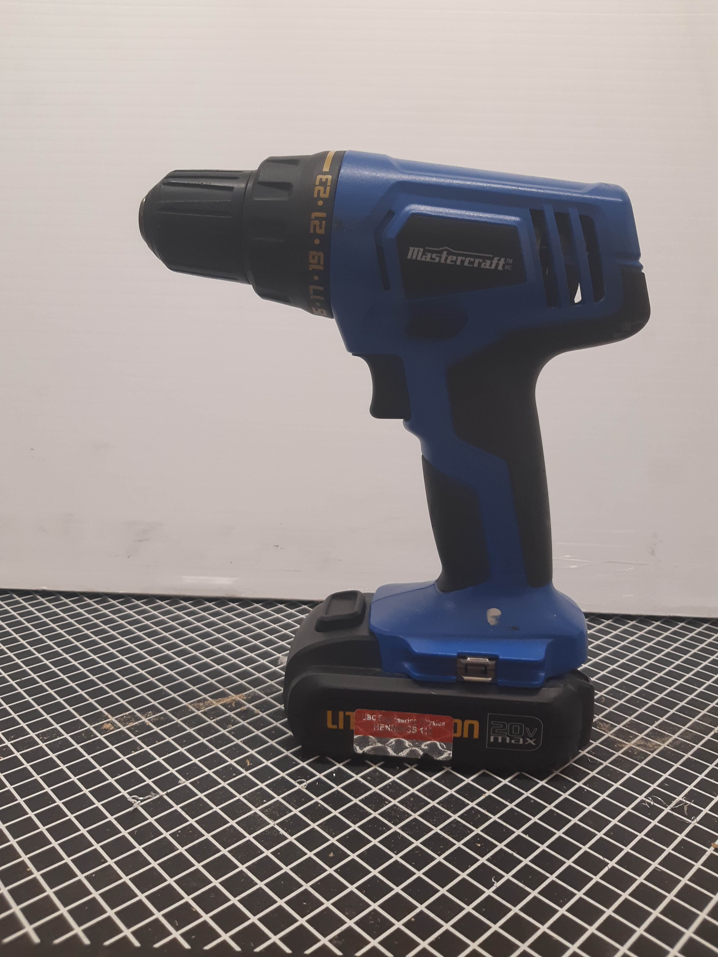
[picture p191: docs/physical/tools_images/handdrill.jpg]
     - 

     	    Handdrill

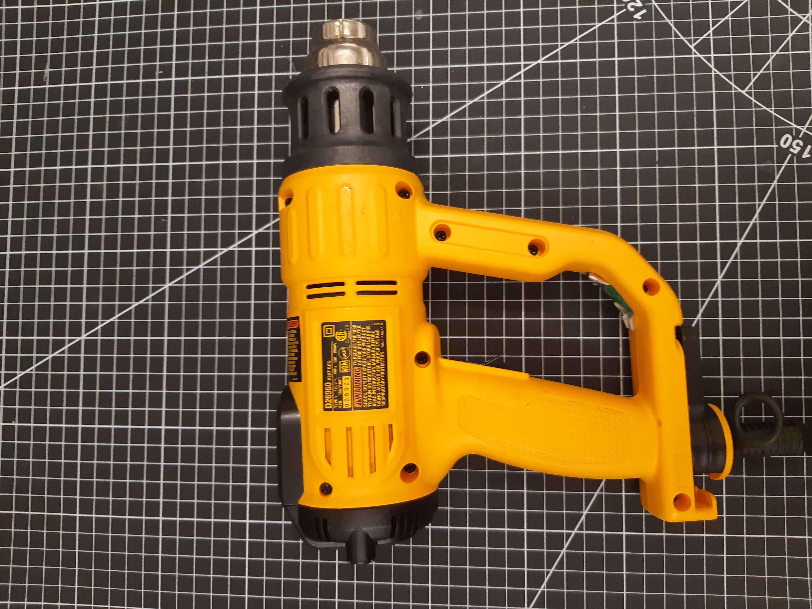
[picture p192: docs/physical/tools_images/heatgun.jpg]
   * - 

          Heatgun

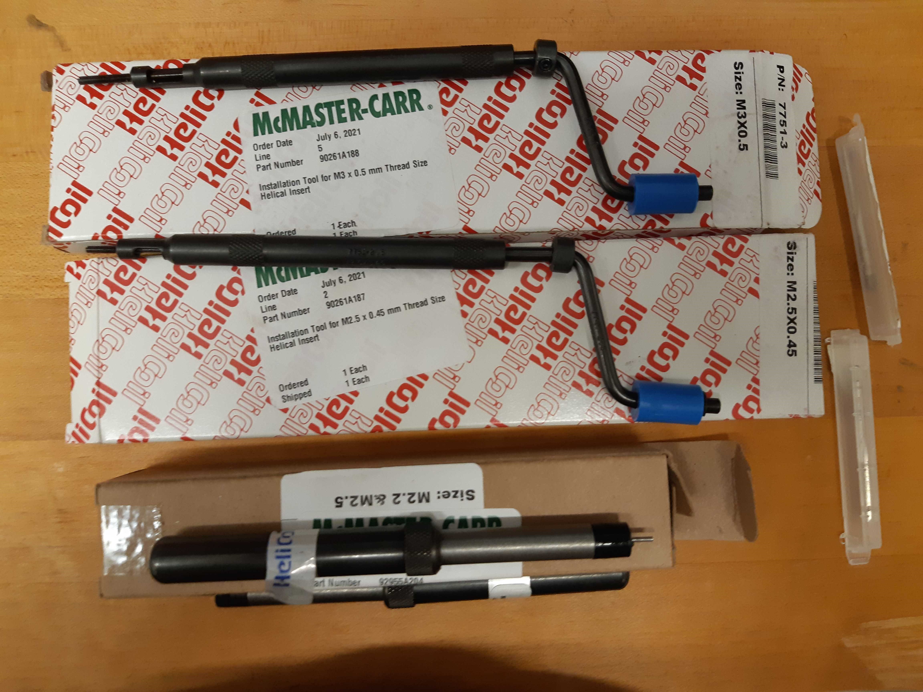
[picture p193: docs/physical/tools_images/helicoilinsertion.jpg]
     - 

          Helicoil insertion tools for M2.5 and M3

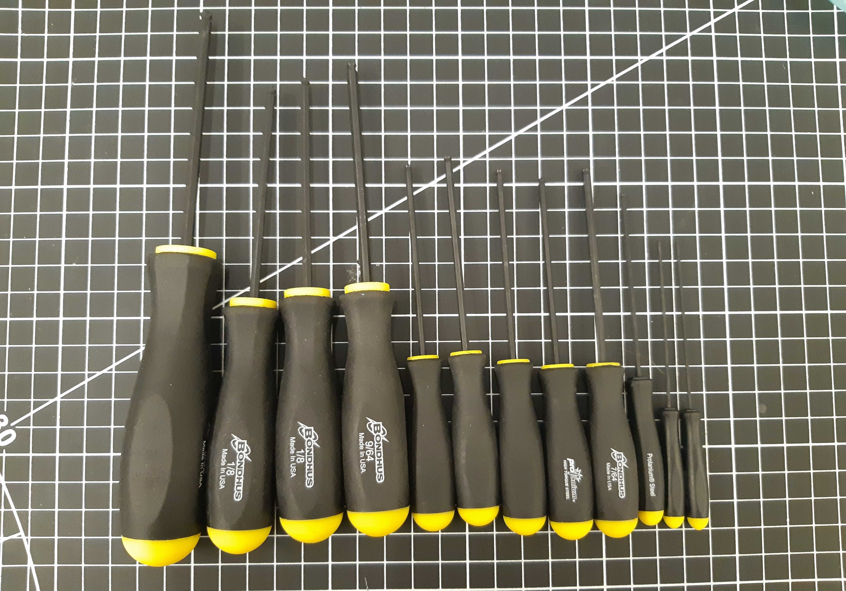
[picture p194: docs/physical/tools_images/hex.jpg]
     - 

          Hex Screwdrivers

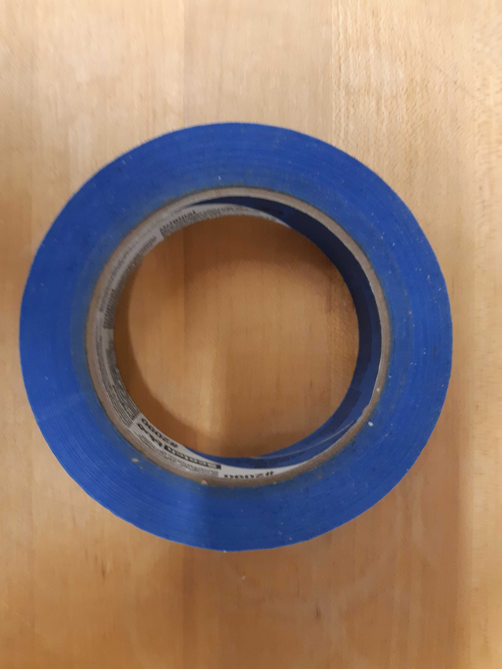
[picture p195: docs/physical/tools_images/maskingtape.jpg]
   * - 

          Masking Tape

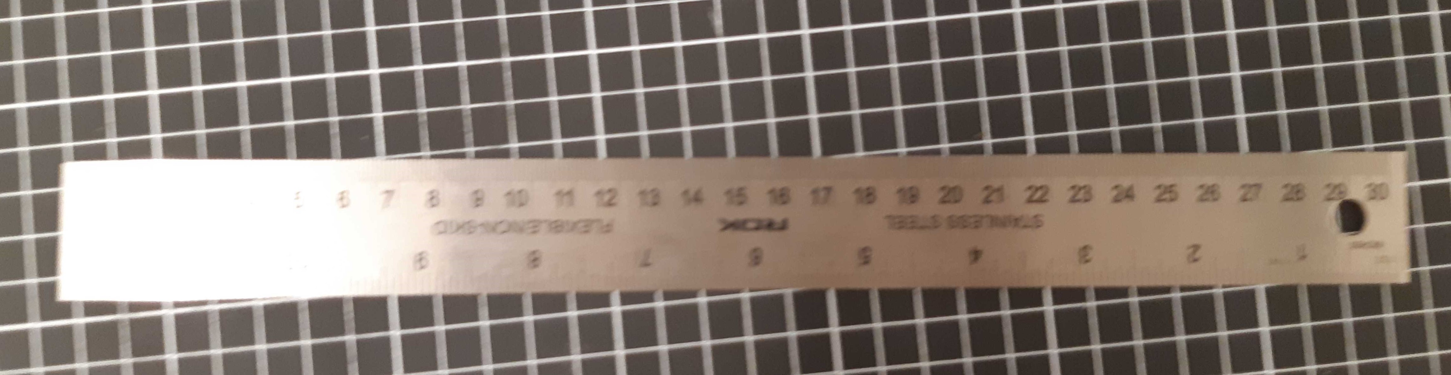
[picture p196: docs/physical/tools_images/ruler.jpg]
     - 

          Ruler

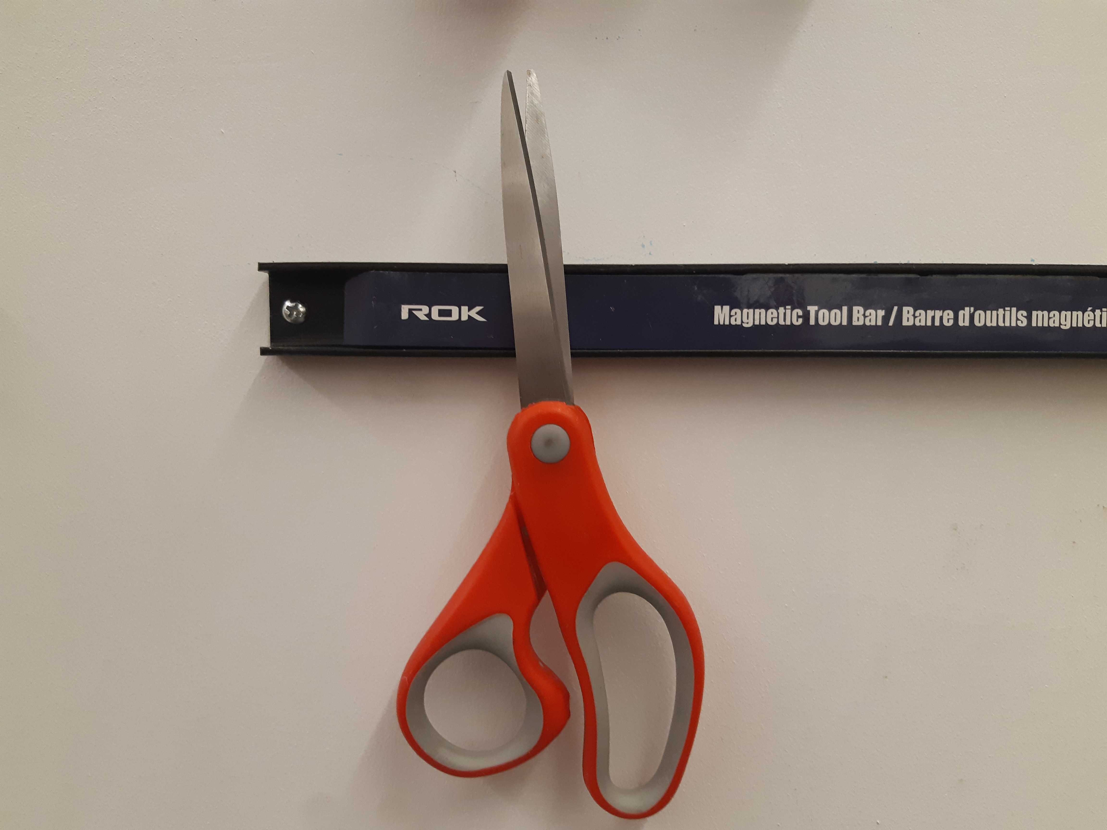
[picture p197: docs/physical/tools_images/scissors.jpg]
     - 

          Scissors

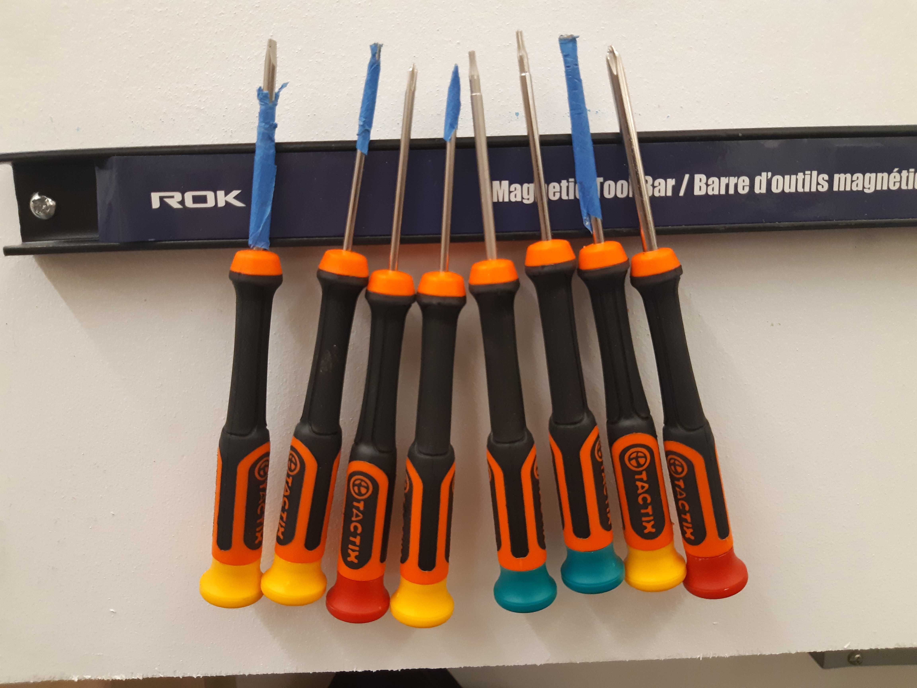
[picture p198: docs/physical/tools_images/screwdriver.jpg]
   * - 

          Complete set of screwdrivers

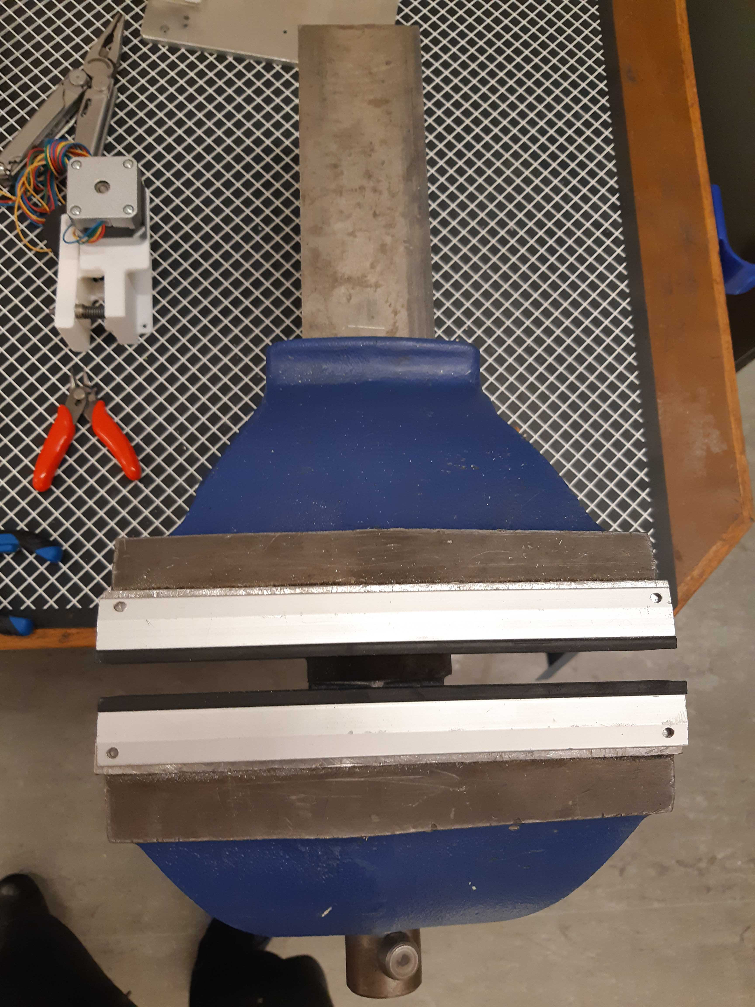
[picture p199: docs/physical/tools_images/tabletopvise.jpg]
     - 

          Tabletop Vise

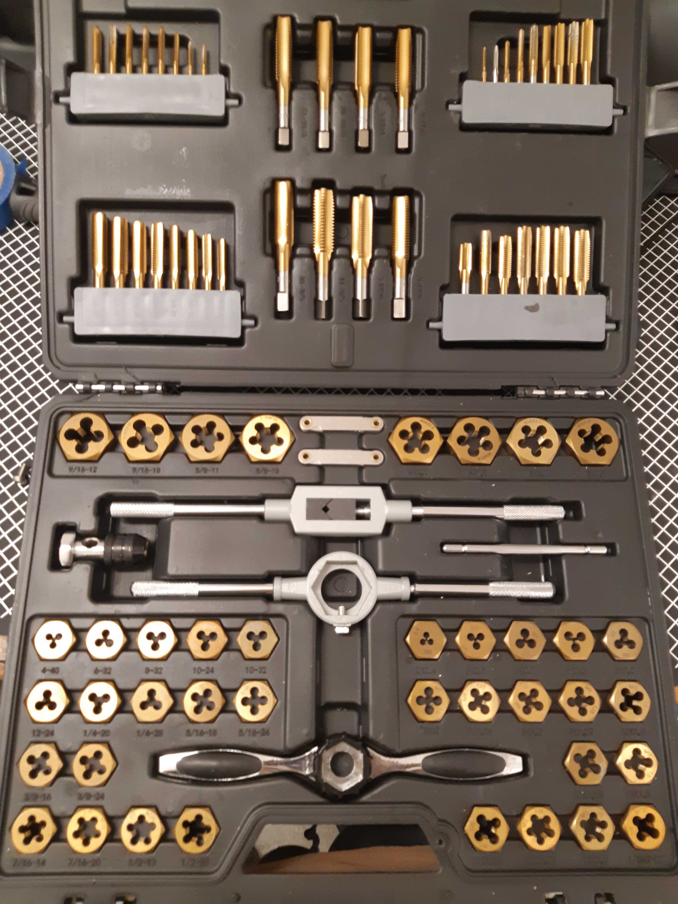
[picture p200: docs/physical/tools_images/taps.jpg]
     - 

          Complete set of taps

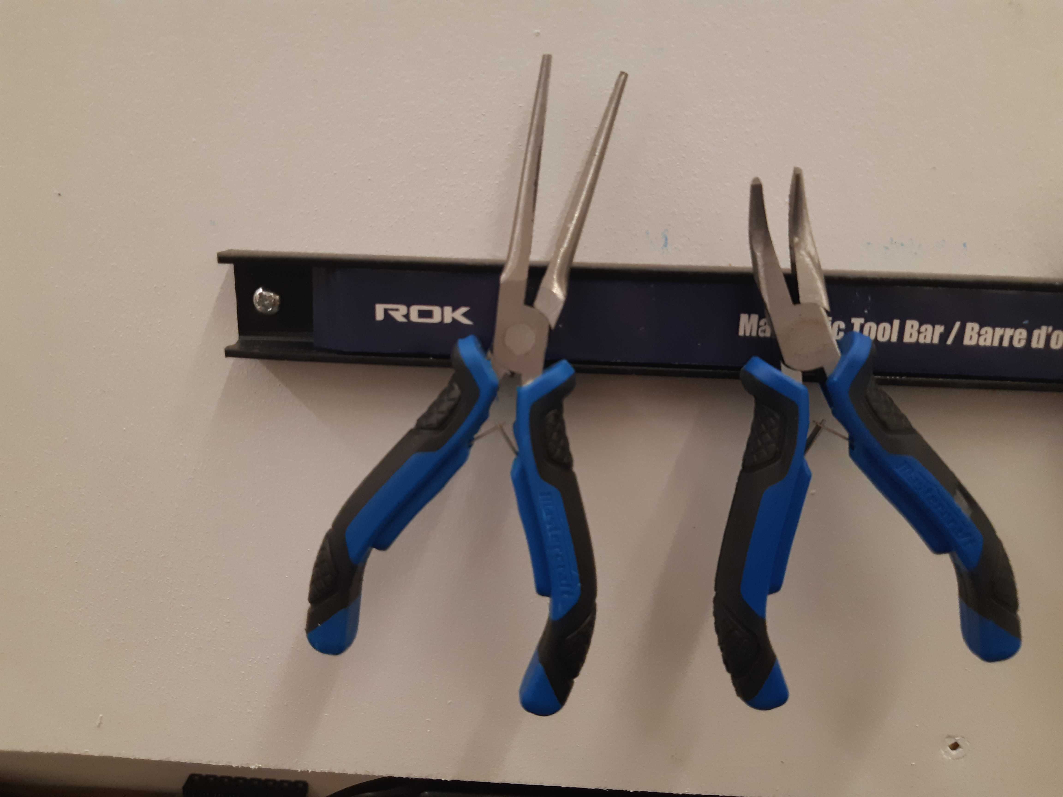
[picture p201: docs/physical/tools_images/tweezers.jpg]
   * - 

          Tweezers

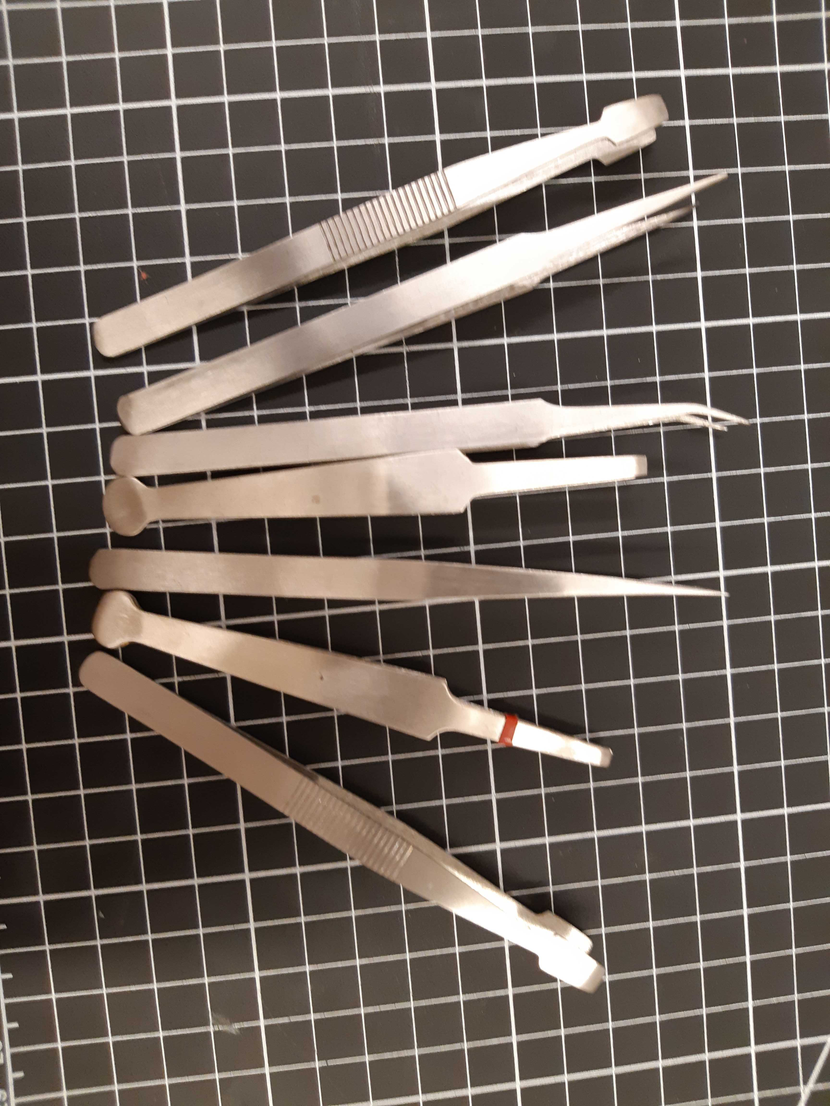
[picture p202: docs/physical/tools_images/tweezers_2.jpg]
     - 

          Needlenose tweezers

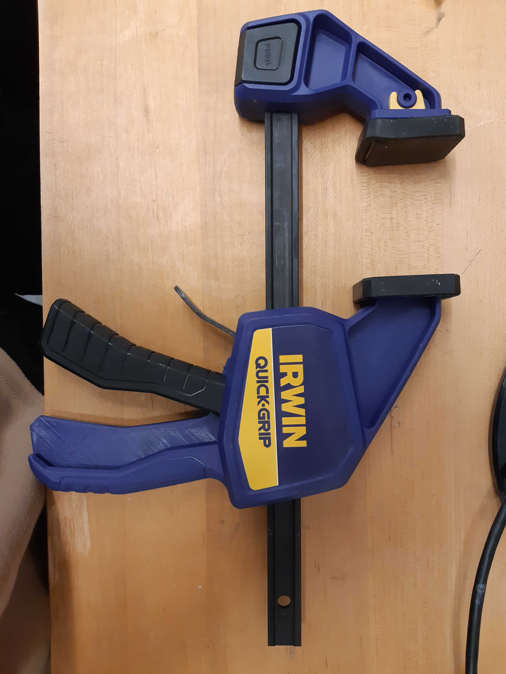
[picture p203: docs/physical/tools_images/vise.jpg]
     - 

          Handheld vise

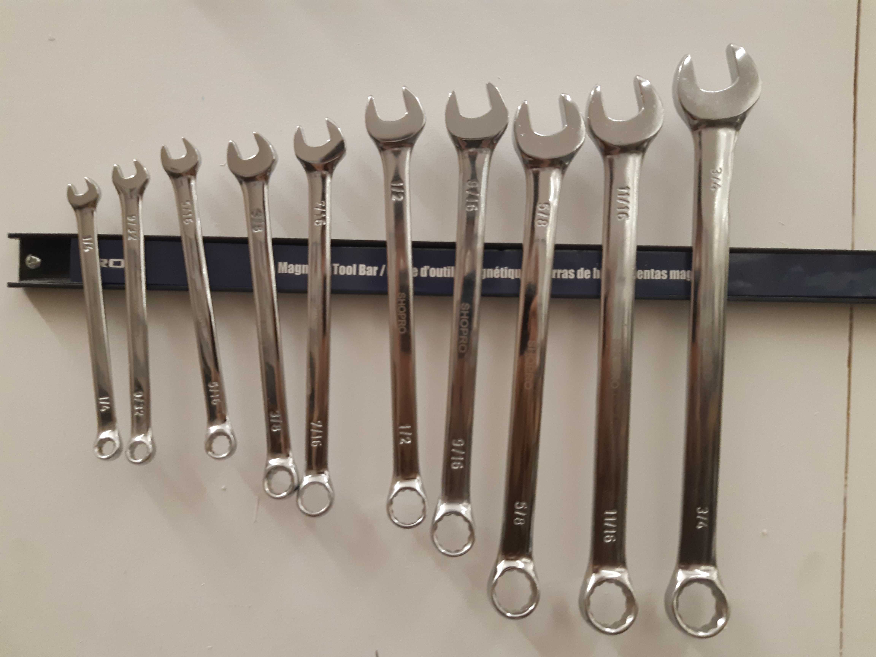
[picture p204: docs/physical/tools_images/wrench_1.jpg]
   * - 

          Complete set of Metric and Imperial wrenches

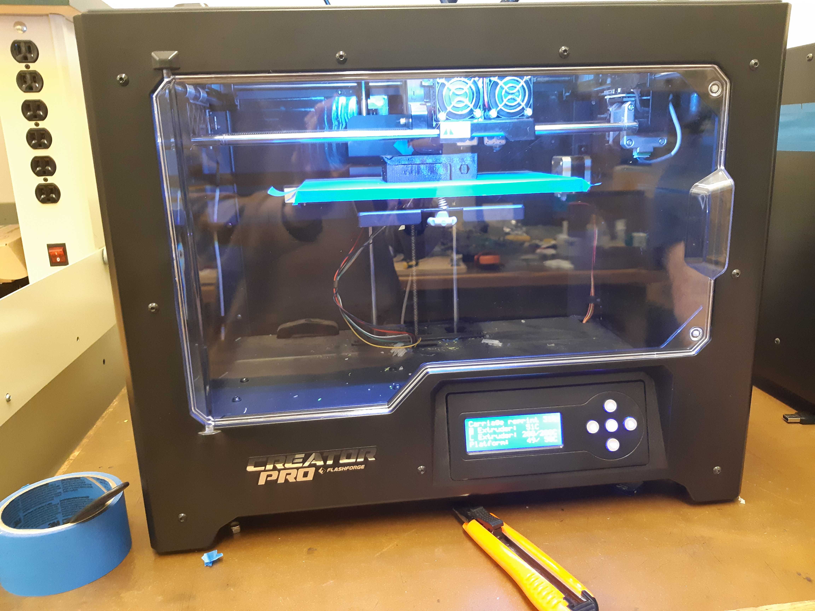
[picture p205: docs/physical/tools_images/3dprinter_2.jpg]
     - 

		  3D printer (recommended)

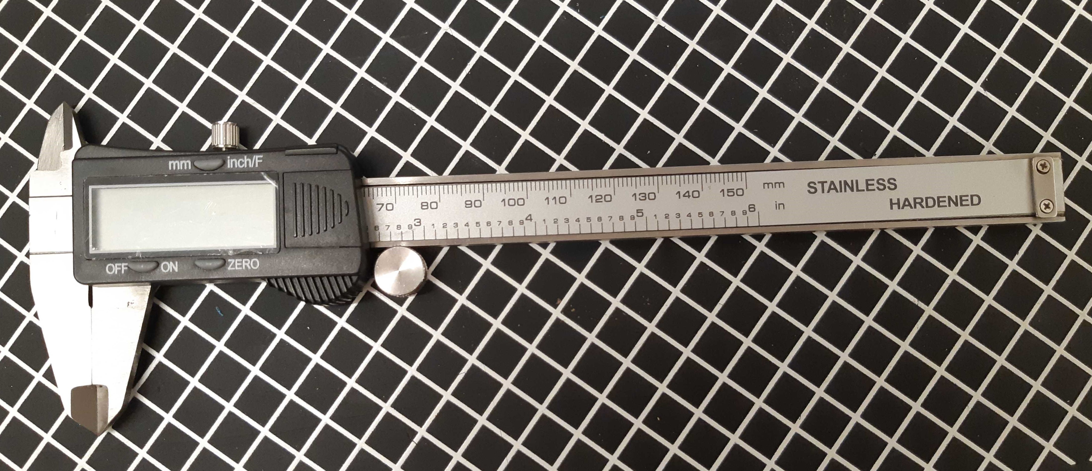
[picture p206: docs/physical/tools_images/caliper.jpg]
     - 

		  Calipers

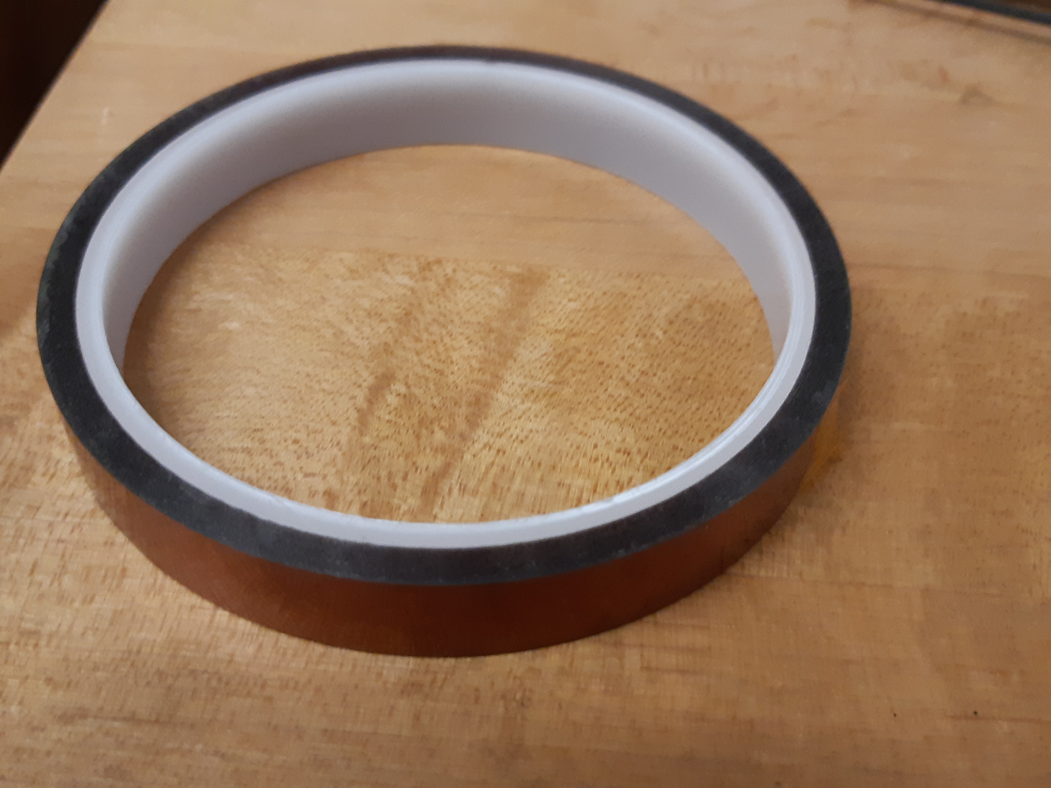
[picture p207: docs/physical/tools_images/kapton.jpg]
   * - 

          Kapton Tape, as thin as possible

     - 

          Masking Tape

     -

   * - Waterjet Cutter (recommended)

     - Handsaw

     -

.. list-table:: Electrical Tools Required

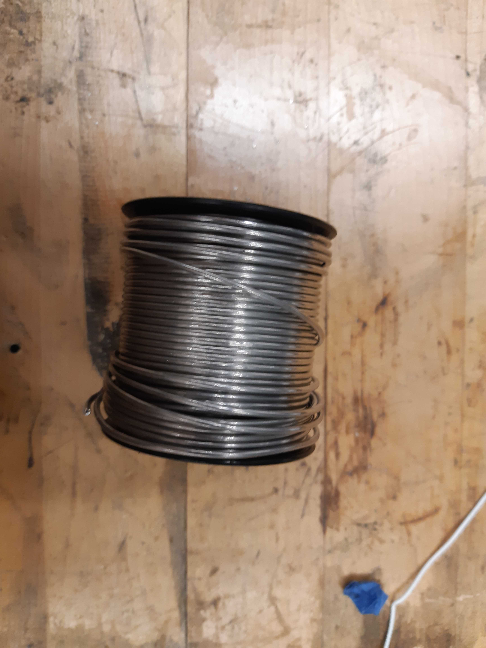
[picture p209: docs/physical/tools_images/solder.jpg]
   * - 

          Solder, as thin as possible

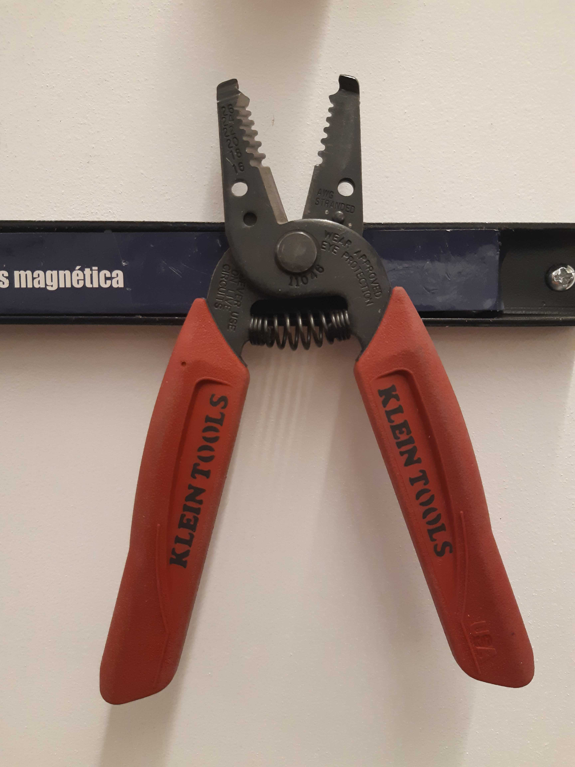
[picture p210: docs/physical/tools_images/stripper.jpg]
     - 

          Wire stripper

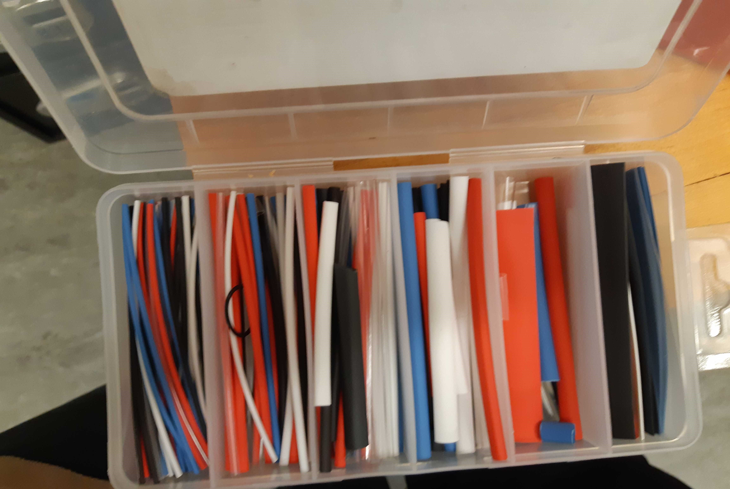
[picture p211: docs/physical/tools_images/heatshrink.jpg]
     - 

          Assorted Heatshrink

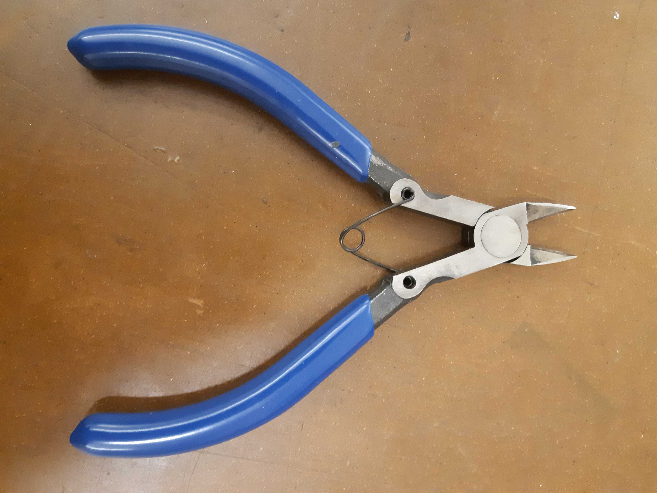
[picture p212: docs/physical/tools_images/wire_snips.jpg]
   * - 

          Wire Snips

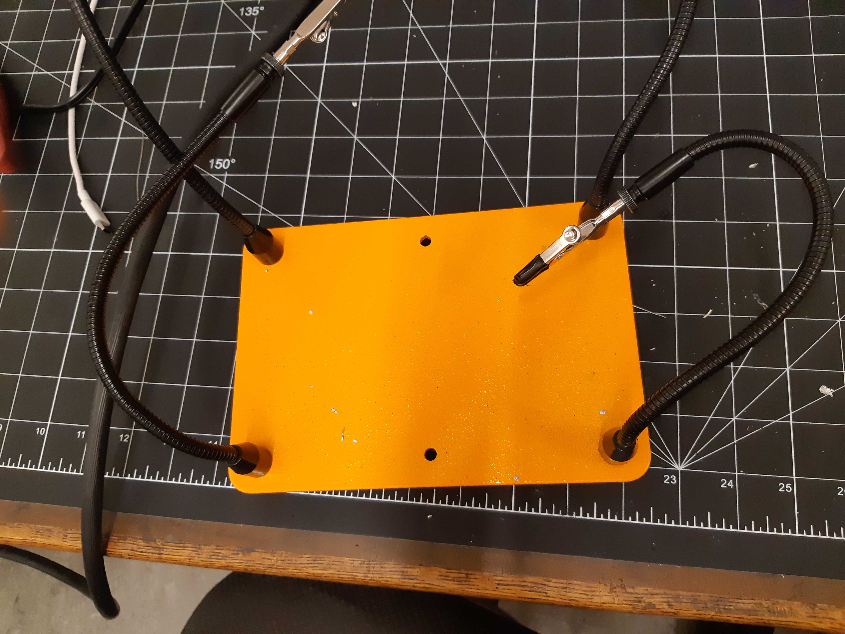
[picture p213: docs/physical/tools_images/solderhand.jpg]
     - 

          Soldering Hand

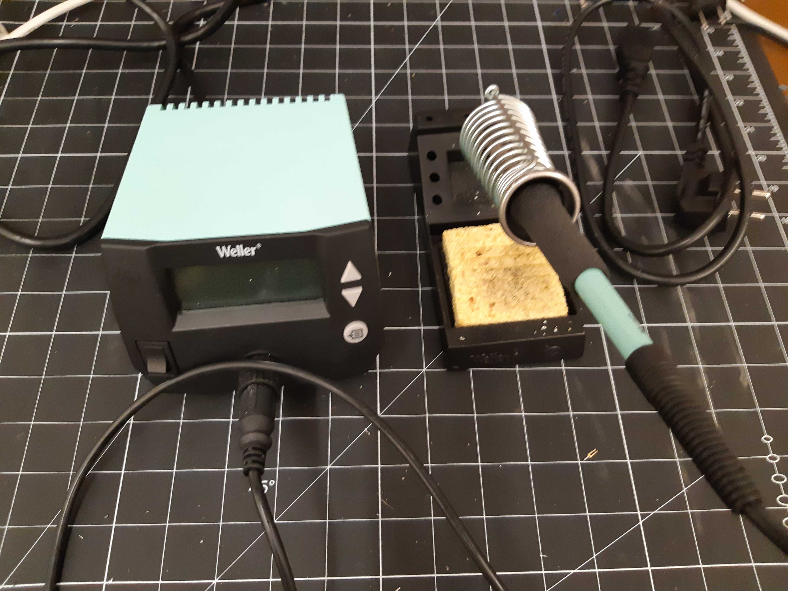
[picture p214: docs/physical/tools_images/solderstation.jpg]
     - 

          Soldering Station

   * - JST Crimper

     -

     -

If the encoder code wheels require rework(see :ref`Robotic Leg Build Instructions <build_instructions_leg>`),
then access to a well-equipped machine shop is required. This will be explained in greater detail in a later section,
but avoiding rework of encoder code wheels by purchasing ready-made code wheels is recommended. Otherwise, access to the
following equipment is required:

- Lathe
- Milling machine

Technical
=========

The following mechanical assembly & design skills are required to assemble the physical robot:

- Familiarity with CAD software such as Onshape and SOLIDWORKS
- Waterjet cutting
- 3D printing
- Drilling and tapping holes
- Insertion of Helicoils

The following electrical skills are required to assemble the physical robot:

- Soldering and Wiring
- Measurement with oscilloscope and multimeter
- Wire crimping for JST connectors
- Reading electrical schematics

The following software skills are required to setup the code infrastructure for the physical robot:

- Python, C, C++ programming languages
- Familiarity with Windows and Linux operating systems. A dual-booted laptop with Windows 10/11 and Ubuntu 18.04/20.04 or PopOS,
  a decent processor and at least 8GB of RAM is recommended.
- Git version control
- Embedded software development
- Familiarity with Field Oriented Control for motors.

This build assumes the availability of computers running Ubuntu 20.04 and Windows 10 operating systems.
Learning resources to gain familiarity with the necessary toolchains and techniques are in
:ref:`Further Reading & Resources <monopod_resources>`.
