OpenSim2Real/hardware_repository/docs/physical/in_images/wiring_2.jpg

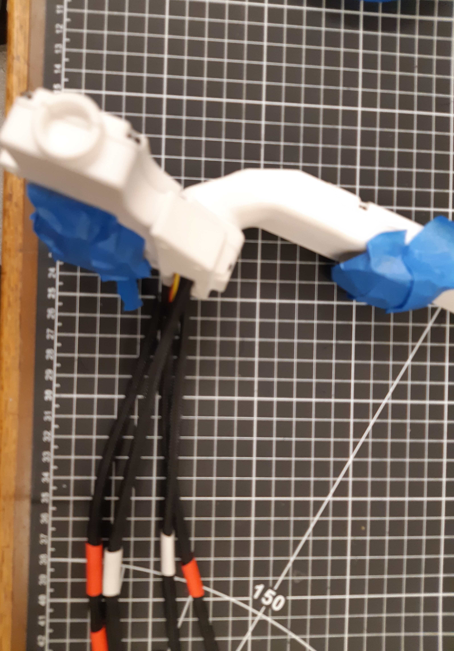
docs/physical/in_images/wiring_2.jpg
