OpenSim2Real/hardware_repository/docs/design/design_images/teststand.PNG

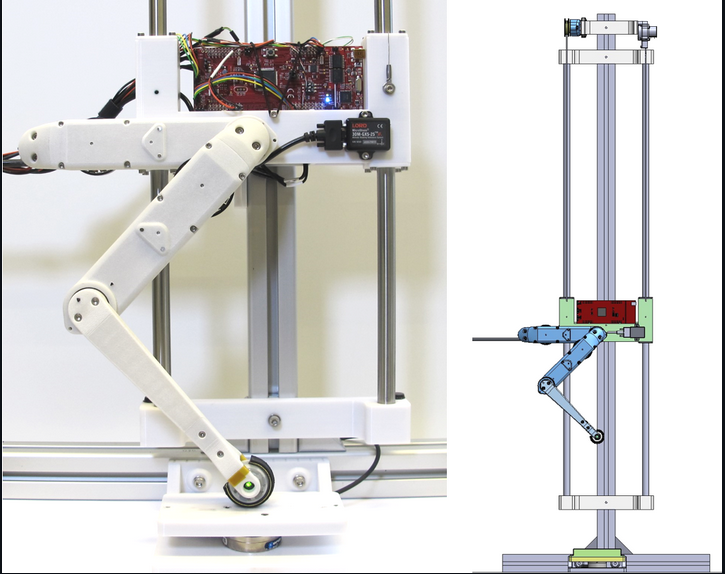
docs/design/design_images/teststand.PNG
