OpenSim2Real/hardware_repository/docs/firmware/fm_images/debug.PNG

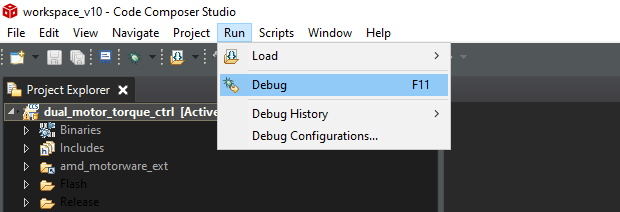
docs/firmware/fm_images/debug.PNG
