OpenSim2Real/hardware_repository/(commit log)

2022-04-02 Added first hardware files.
    [axle-holder-1.dxf, axle-holder-2.dxf, axle-mount-1.step, axle-mount-1.stl, axle-mount-2.step, axle-mount-2.stl, baseplate.dxf, centering-tool-1.stl]
2022-04-02 Added documentation.
    [axle-holder-1.dxf, axle-holder-2.dxf, axle-mount-1.step, axle-mount-1.stl, axle-mount-2.step, axle-mount-2.stl, baseplate.dxf, centering-tool-1.stl]
2022-04-03 Added remaining images for documentation
    [axle-holder-1.dxf, axle-holder-2.dxf, baseplate.dxf, collar-mount.dxf, electronic-holder.dxf, lower-base.dxf, roof.dxf, upper-base.dxf]
2022-04-04 Added several more CAD files. Added more clarification on documentation.
    [pulley-assembly-tool.STL, pulley-protection-tool.stl, tool_code_wheel_bonding.STL, tool_motor_shaft_extraction.STL, tool_motor_shaft_pulley_bonding.STL]
