OpenSim2Real/hardware_repository/docs/physical/in_images/3phase_3.jpg

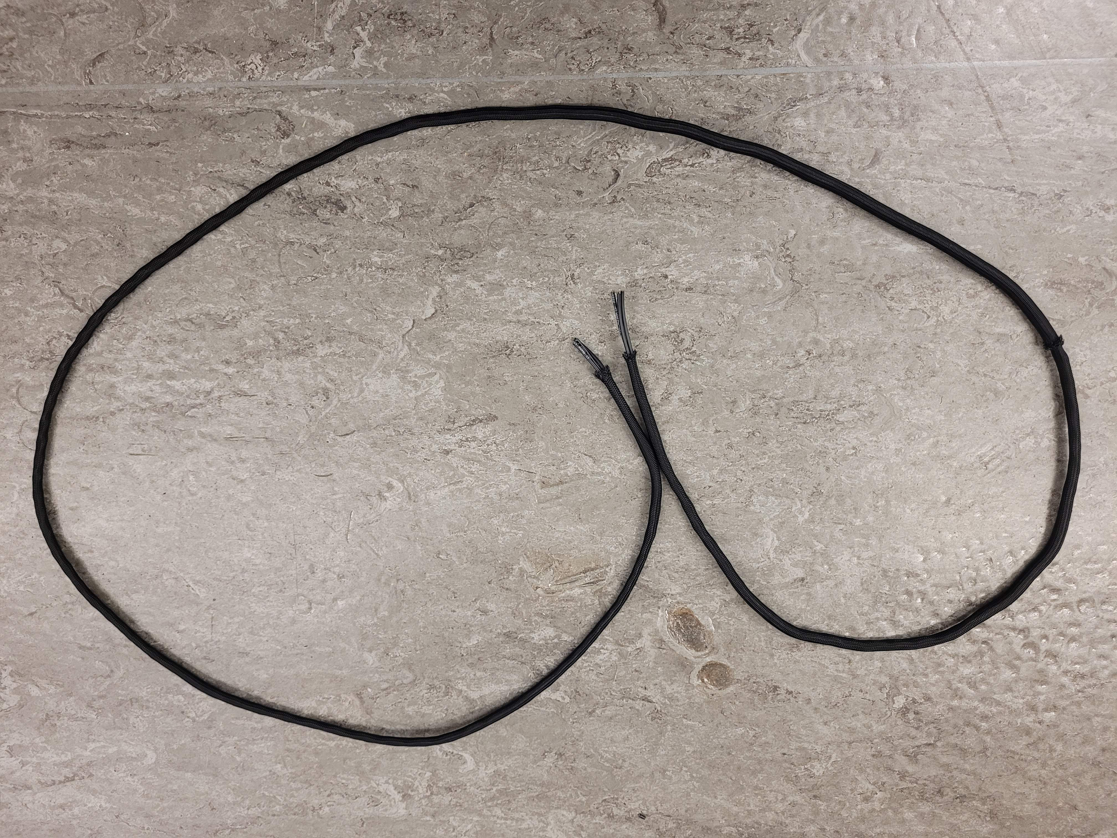
docs/physical/in_images/3phase_3.jpg
