OpenSim2Real/hardware_repository/docs/hardware_documentation/physical/tools_images/drillbits.jpg

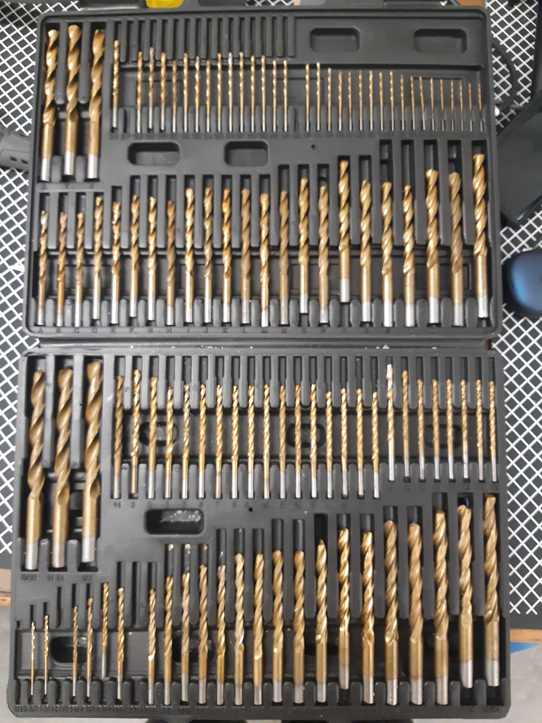
[picture p185: docs/physical/tools_images/drillbits.jpg]
docs/hardware_documentation/physical/tools_images/drillbits.jpg
