OpenSim2Real/hardware_repository/docs/physical/tools_images/masking.jpg

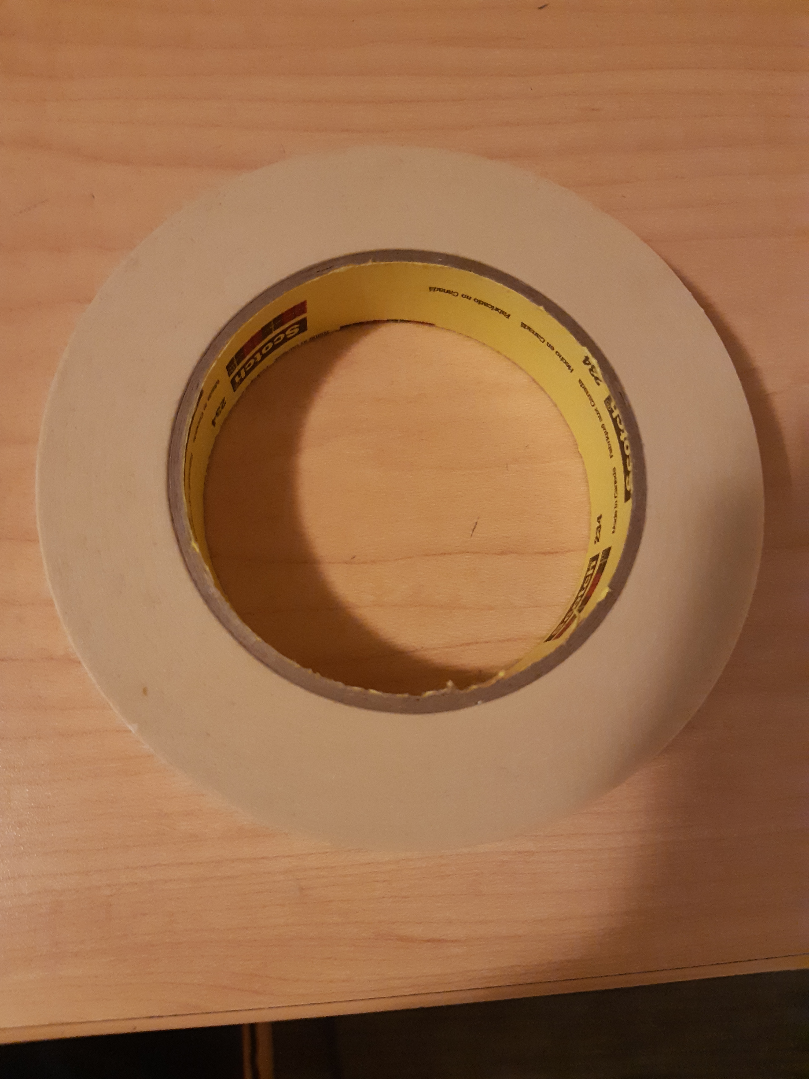
[picture p208: docs/physical/tools_images/masking.jpg]
docs/physical/tools_images/masking.jpg
